woodsmoke/Due_SB/Duet-master/Duet_Expansion/Duex4v0.2/back_silkscreen.png

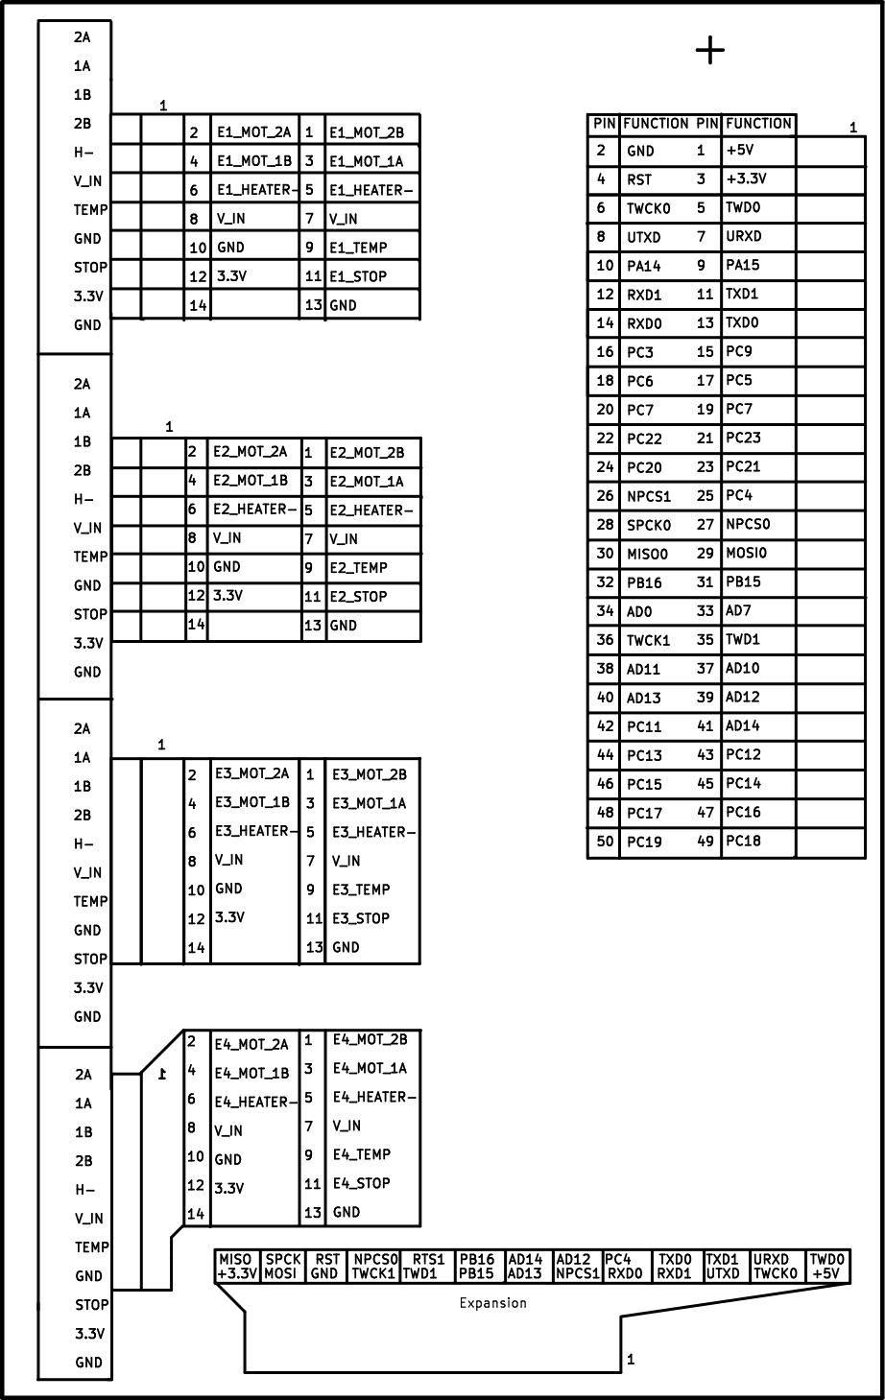
Duet-master/Duet_Expansion/Duex4v0.2/back_silkscreen.png
