woodsmoke/Due_SB/Duet-master/Archive_Files/Duet0.4/Duet0.4 BOM.xls

Part / Value | Qty | Package | Manufacturer / Part No. | Circuit Reference
Resistors, Thick Film
0R1, 1% | 8 | 1206 | Any | R32, R33, R34, R35, R44, R45, R46, R47
33R, 1% | 7 | 0603 | Any | R2, R3, R6, R7, R8, R9, R10
100R, 1% | 4 | 0603 | Any | R56, R57, R58, R59
220R, 1% | 2 | 0603 | Any | R16, R17
1k, 1% | 4 | 0603 | Any | R11, R18, R22, R24
1k5, 1% | 2 | 0603 | Any | R1, R64
4k7, 1% | 8 | 0603 | Any | R12, R13, R14, R19, R21, R65, R67, R68
6k49, 1% | 1 | 0603 | Any | R15
10k, 1% | 22 | 0603 | Any | R5, R20, R23, R25, R27, R29, R30, R31, R39, R41, R42, R43, R50, R51, R52, R53, R54, R55, R60, R61, R62, R63
12k, 1% | 4 | 0603 | Any | R36, R37, R48, R49
15k, 1% | 1 | 0603 | Any | R4
100k, 1% | 4 | 0603 | Any | R26, R28, R38, R40
Capacitors, Ceramic
22p, 50V, C0G/NP0, 5% | 4 | 0603 | Any | C8, C9, C44, C45
0u01, 50V, X7R, 10% | 1 | 0603 | Any | C47
0u1, 50V, X7R, 10% | 24 | 0603 | Any | C1, C5, C16, C17, C24, C25, C28, C29, C34, C35, C38, C39, C40, C41, C42, C43, C46, C48, C49, C50, C51, C52, C53, C55
0u22, 50V, X7R, 10% | 8 | 0603 | Any | C20, C21, C26, C27, C30, C31, C36, C37
2u2, 10V, X7R, 10% | 1 | 0805 | Any | C12
10u, 10V, X5R, 10% | 4 | 0805 | Any | C4, C7, C18, C19
22u, 6.3V, X7R, 10% | 2 | 1210 | Any | C10, C11
Capacitors, Al Electrolytic
100u, 35V, 20% | 6 | 6.3 x 7.7mm | Any | C3, C22, C23, C32, C33, C54
100u, 25V, 20% | 1 | 6.3 x 7.7mm | EPCOS, B41142A5107M | C6
Inductors / Filters
Power, 150uH, 0.5A | 1 | 2424 | PANASONIC - ELL6UH151M | L1
Ferrite Bead, 470R, 100Mhz | 2 | 0603 | Any | L3, L4
Ferrite Bead, 100R, 100MHz | 1 | 1206 | Any | L2
Crystals
12MHz | 1 | 5 x 3.2mm | TBD | X2
25MHz | 1 | 5 x 3.2mm | TBD | X1
Diodes
TS4148 | 2 | 0805 | Taiwan Semi - TS4148 RY | D4, D5
SS14M | 2 | uSMA | Taiwan Semi - SS14M | D1, D2
LED, 2mA, 1.8V | 4 | 0603 | Vishay - TLMO1000-GS08 | D3, D6, D7, D8
FETs
N-Ch, 20V, Logic-level | 3 | SOT-23 | NXP - BSH105 | TR1, TR3, TR5
P-Ch, 50V, Logic-level | 1 | SOT-23 | NXP - BSS84AK | TR7
N-Ch, 40V, Power | 3 | DPAK / TO-252 | Infineon - IPD036N04L | TR2, TR4, TR6
ICs
LPC1768 | 1 | LQFP100 | NXP - LPC1768FBD100,551 | U1
A4982 | 4 | TSSOP-24 | Allegro - A4982SLPTR-T | U5, U6, U7, U8
LM2594 | 1 | SOIC-8 | Nat Semi - LM2594M-5.0 | U3
LM1117 | 1 | SOT-223 | Nat Semi - LM1117MP-3.3 | U2
MCP44X1 | 1 | TSSOP-20 | Microchip - MCP4461-103E/ST | U9
KSZ8051 | 1 | QFN-32 | Micrel - KSZ8051RNL TR | U4
Miscellaneous
Micro Push Button Switch | 2 | SMD | Panasonic - EVQQ2T03W | S1, S2
USB - Micro B | 1 | SMD | FCI - 10118192-0001LF | J22
Micro SD Card Slot | 1 | SMD | TBD | J18
Connectors
RJ45+MAG | 1 |  |  | J19
BED_HEATER | 1 |  |  | J4
BED_TEMP | 1 |  |  | J5
CONN2X13 | 1 |  |  | J2
CONN2X20 | 2 |  |  | J1, J6
CONN_JTAG | 1 |  |  | J21
E0_HEATER | 1 |  |  | J11
E0_MOT/STOP | 1 |  |  | J10
E0_TEMP | 1 |  |  | J12
FAN0 | 1 |  |  | J13
I2C_2 | 1 |  |  | J3
JUMPER | 8 |  |  | JP1, JP2, JP3, JP4, JP5, JP6, JP7, JP8
POWER_IN | 1 |  |  | J23
UART0 | 1 |  |  | J20
X_MOT/STOP | 1 |  |  | J9
Y_MOT/STOP | 1 |  |  | J8
Z_MOT/STOP | 1 |  |  | J7
