woodsmoke/Due_SB/Duet-master/Duet0.8.5/Duet0.8.5_Schematic.pdf

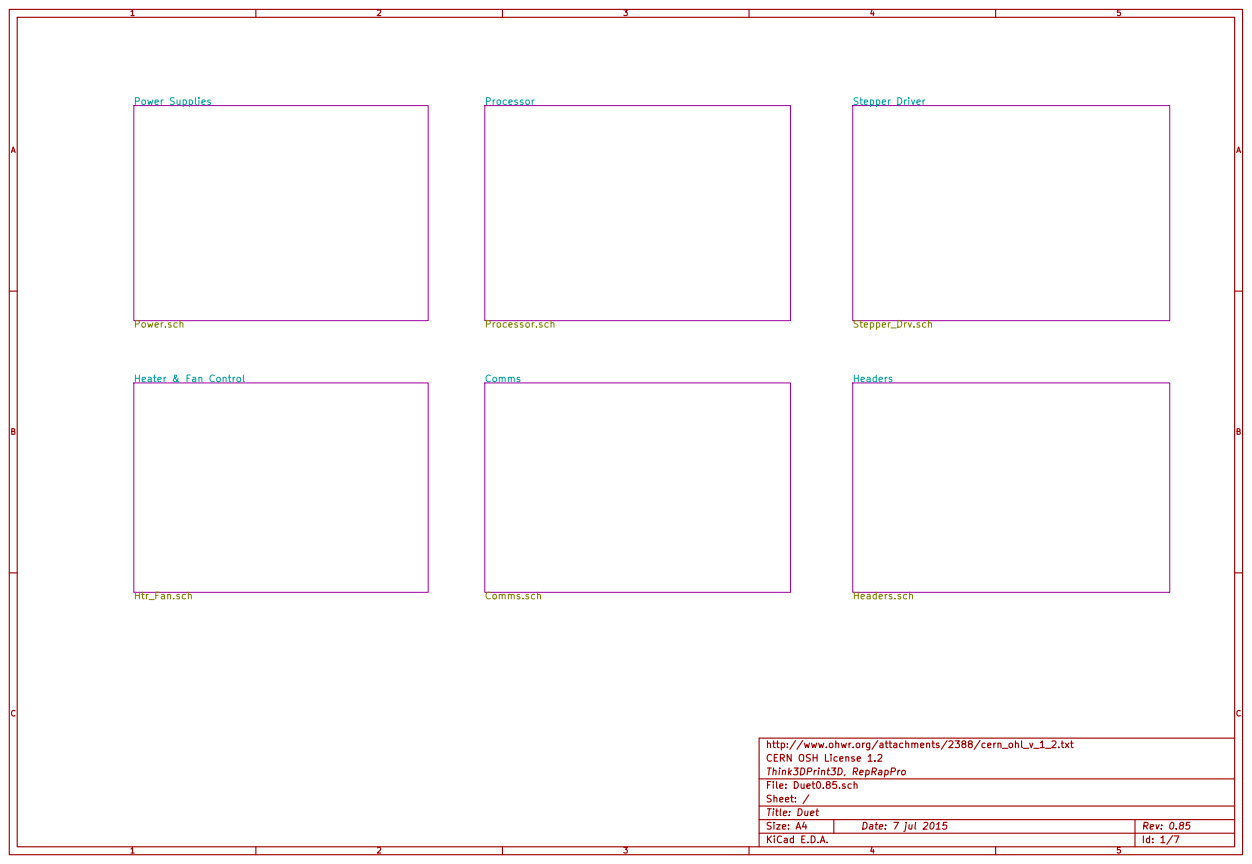
[picture p2: page 1]

http://www.ohwr.org/attachments/2388/cern_ohl_v_1_2.txt
CERN OSH License 1.2
Think3DPrint3D, RepRapPro
Id: 1/7 Title: Duet File: Duet0.85.sch Sheet: /

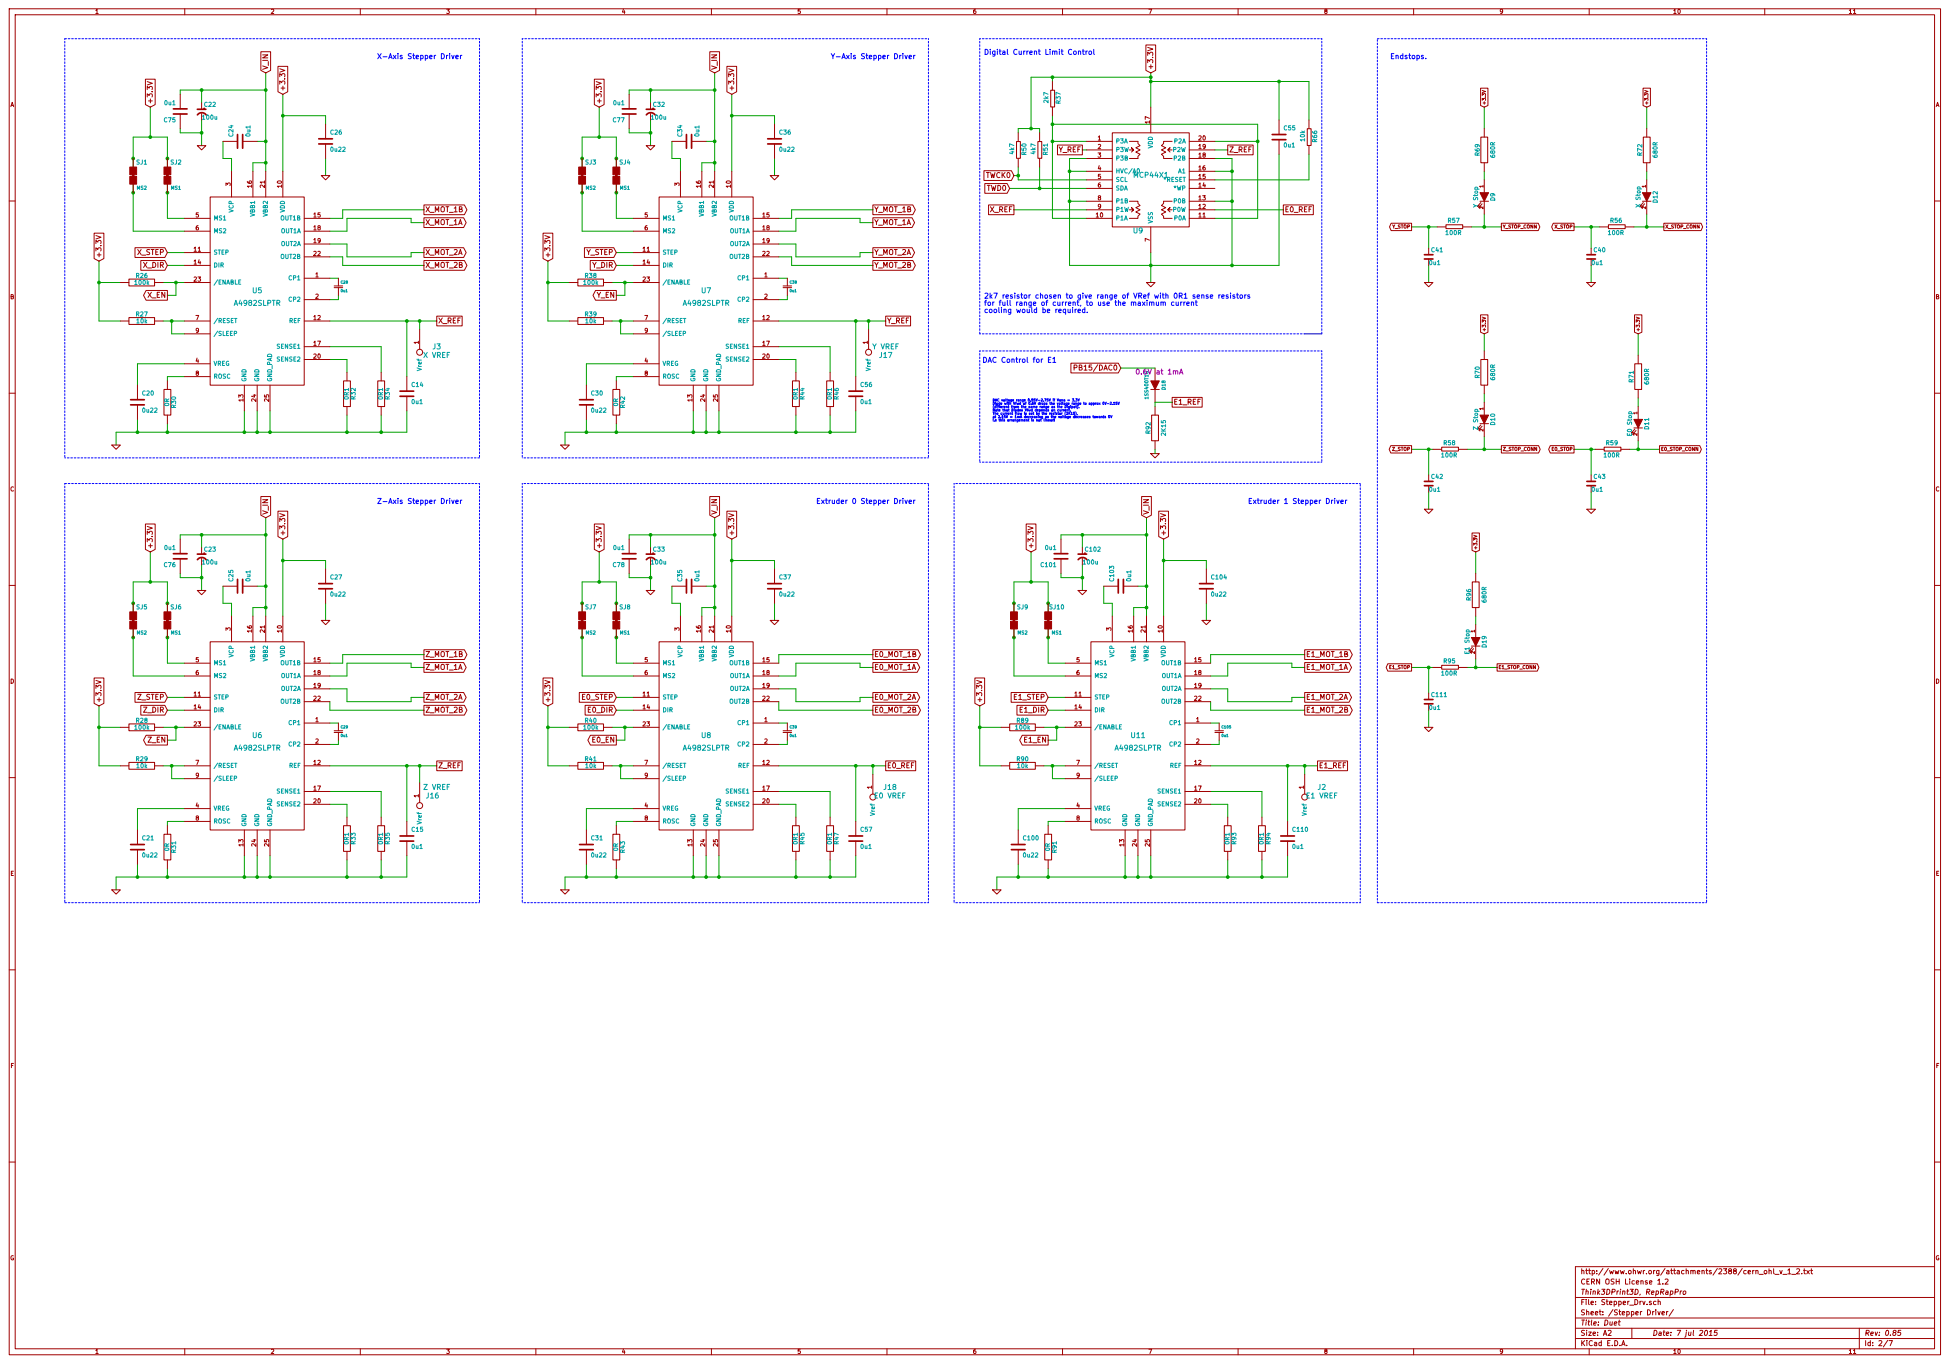
[picture p3: page 2]

Endstops. Digital Current Limit Control

for full range of current, to use the maximum current

DAC voltage range 0.55V-2.75V if Vana = 3.3V Diode with Vfwd of 0.6V drops the voltage range to approx 0V-2.15V
(different from the same range as the Digipot). Note that Diodes Vfwd depends on current. The current flow is set by the resistor (2K15), at 2.15V = 1mA decreasing as the voltage decreases towards 0V

http://www.ohwr.org/attachments/2388/cern_ohl_v_1_2.txt
CERN OSH License 1.2
Think3DPrint3D, RepRapPro
Id: 2/7 Title: Duet File: Stepper_Drv.sch
Sheet: /Stepper Driver/

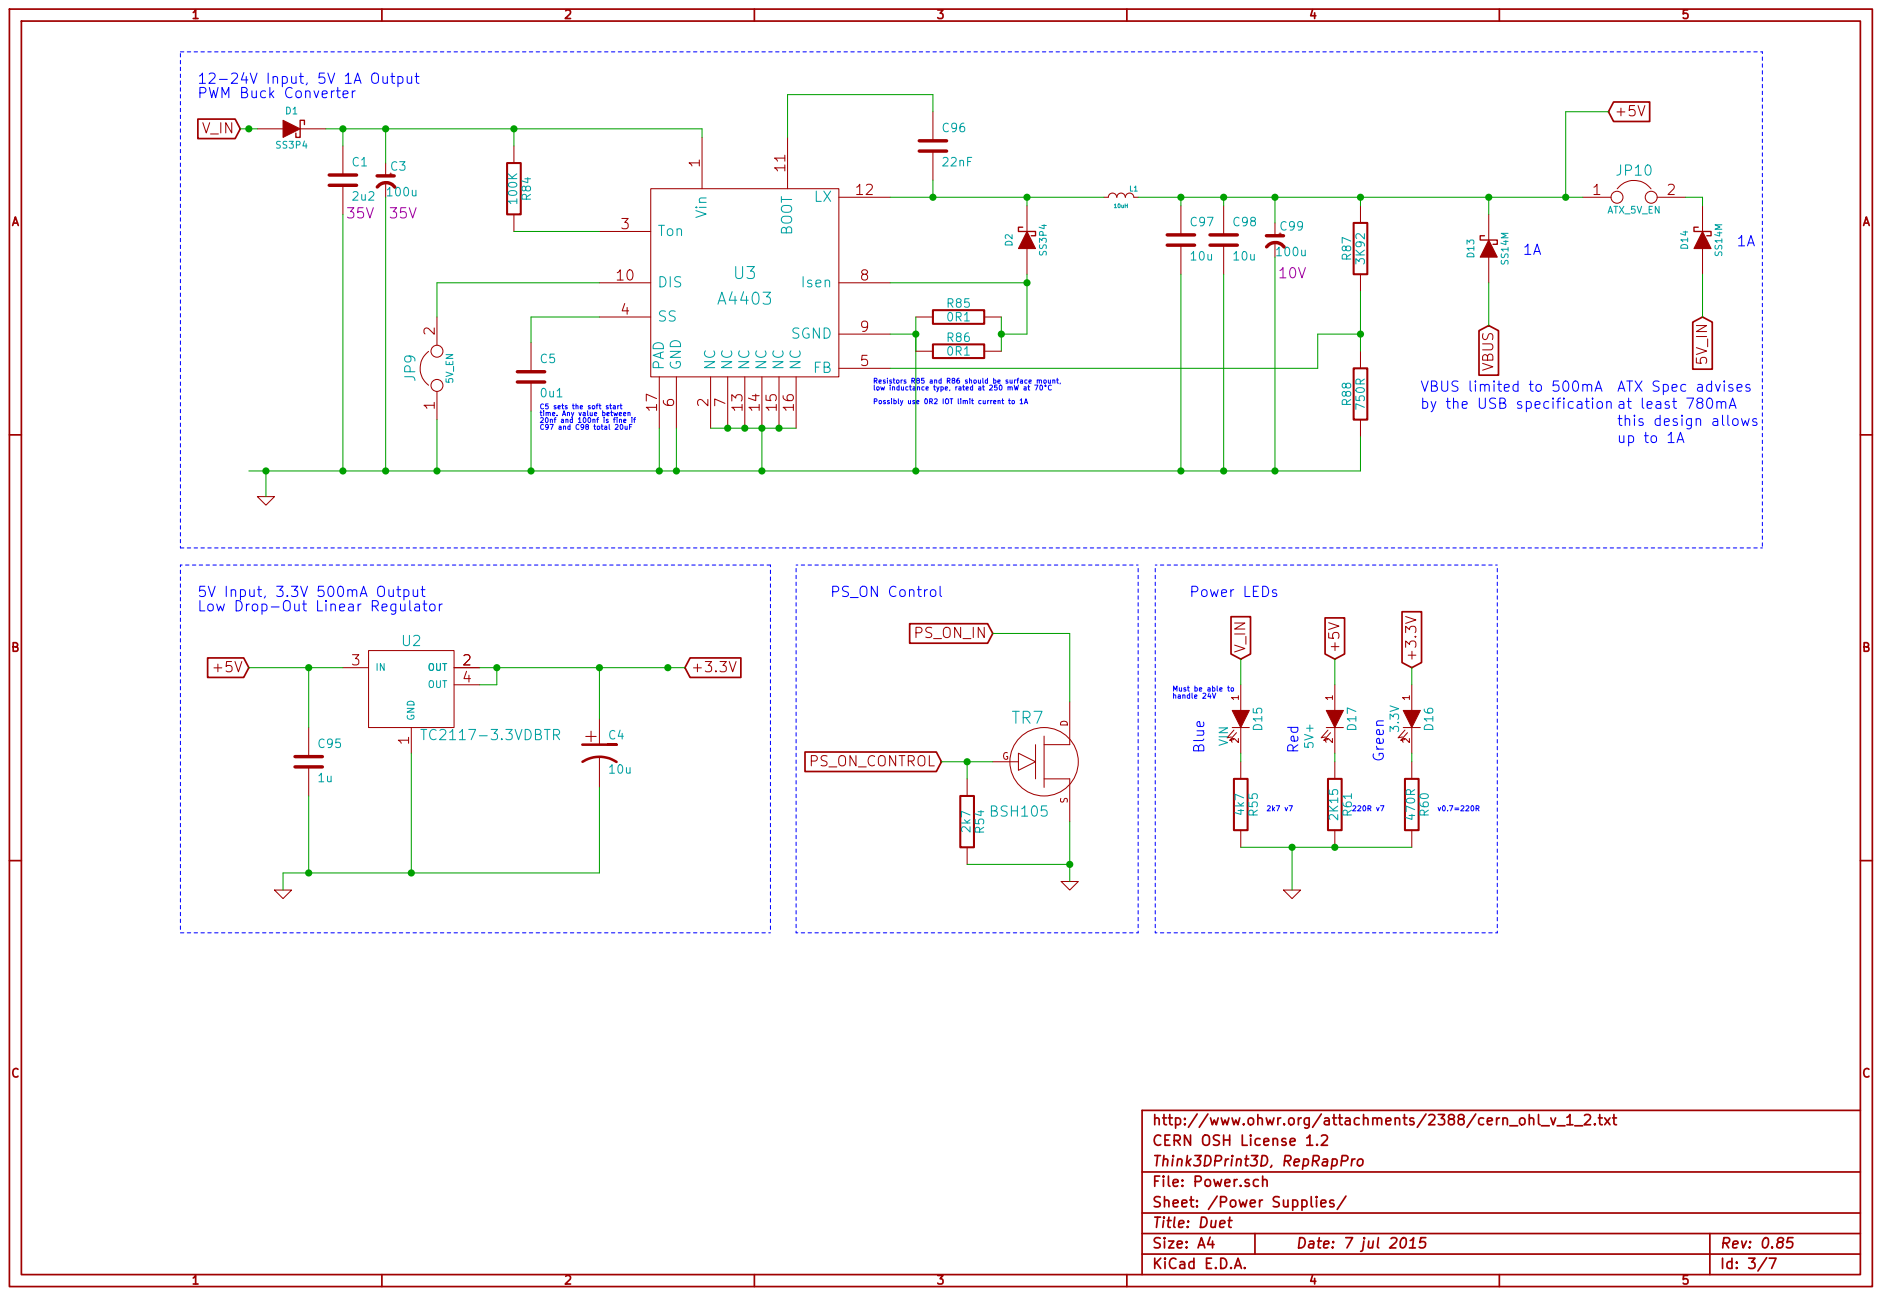
[picture p4: page 3]

U3 A4403 | LX | 12 NC 13 NC 14 NC 15 NC 16 PAD 17

2 Ton 3 SS 4 FB GND 5

Resistors R85 and R86 should be surface mount,
low inductance type, rated at 250 mW at 70°C

Possibly use 0R2 IOT limit current to 1A C5 sets the soft start

by the USB specification

this design allows at least 780mA

time. Any value between

5V Input, 3.3V 500mA Output
Low Drop-Out Linear Regulator

Must be able to

http://www.ohwr.org/attachments/2388/cern_ohl_v_1_2.txt C95

CERN OSH License 1.2
Think3DPrint3D, RepRapPro
Id: 3/7 Title: Duet File: Power.sch Sheet: /Power Supplies/

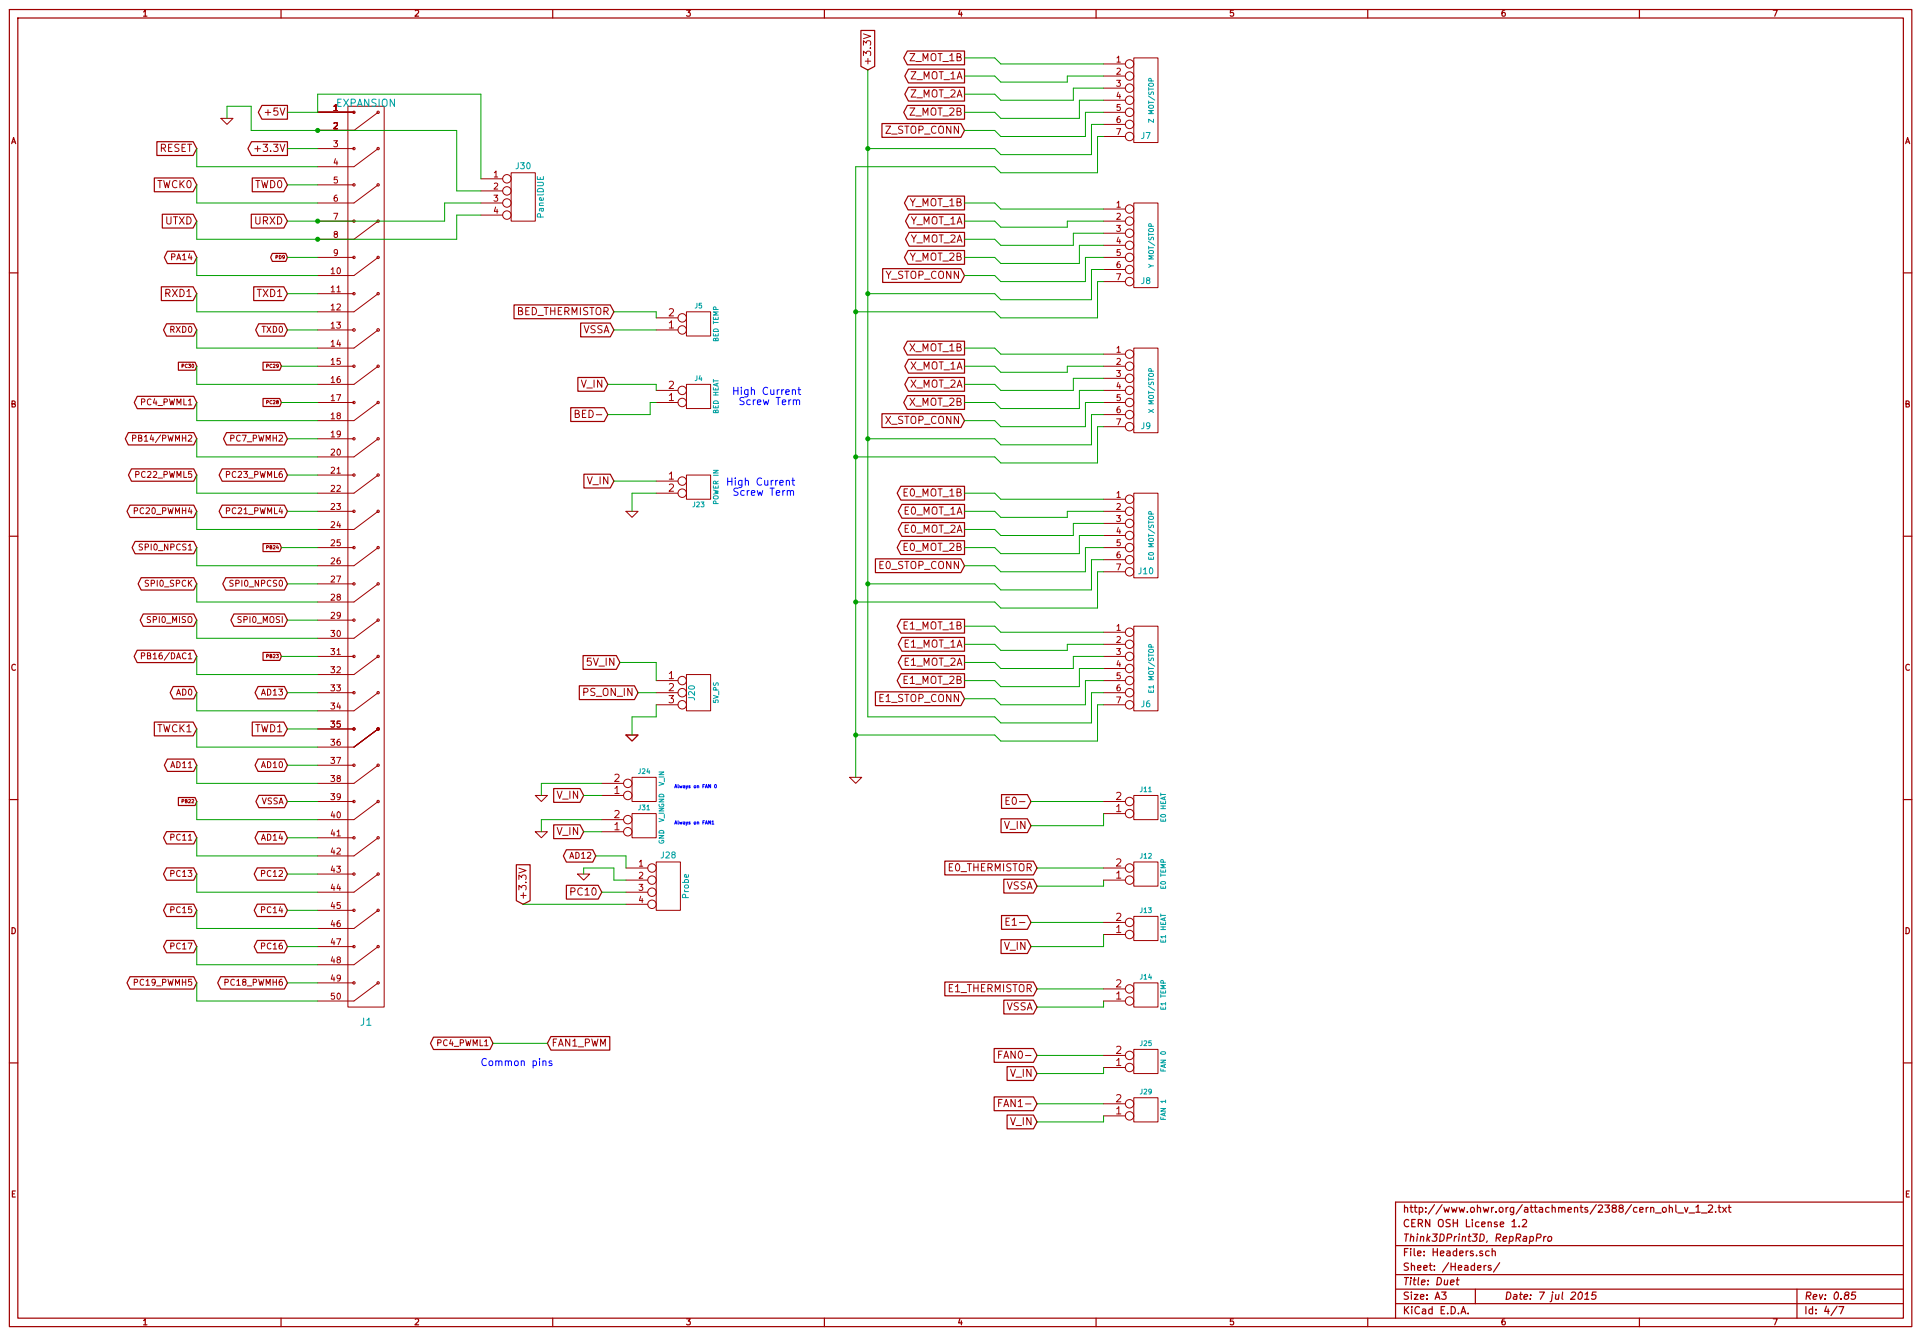
[picture p5: page 4]

CERN OSH License 1.2
Think3DPrint3D, RepRapPro
Id: 4/7 Title: Duet File: Headers.sch Sheet: /Headers/

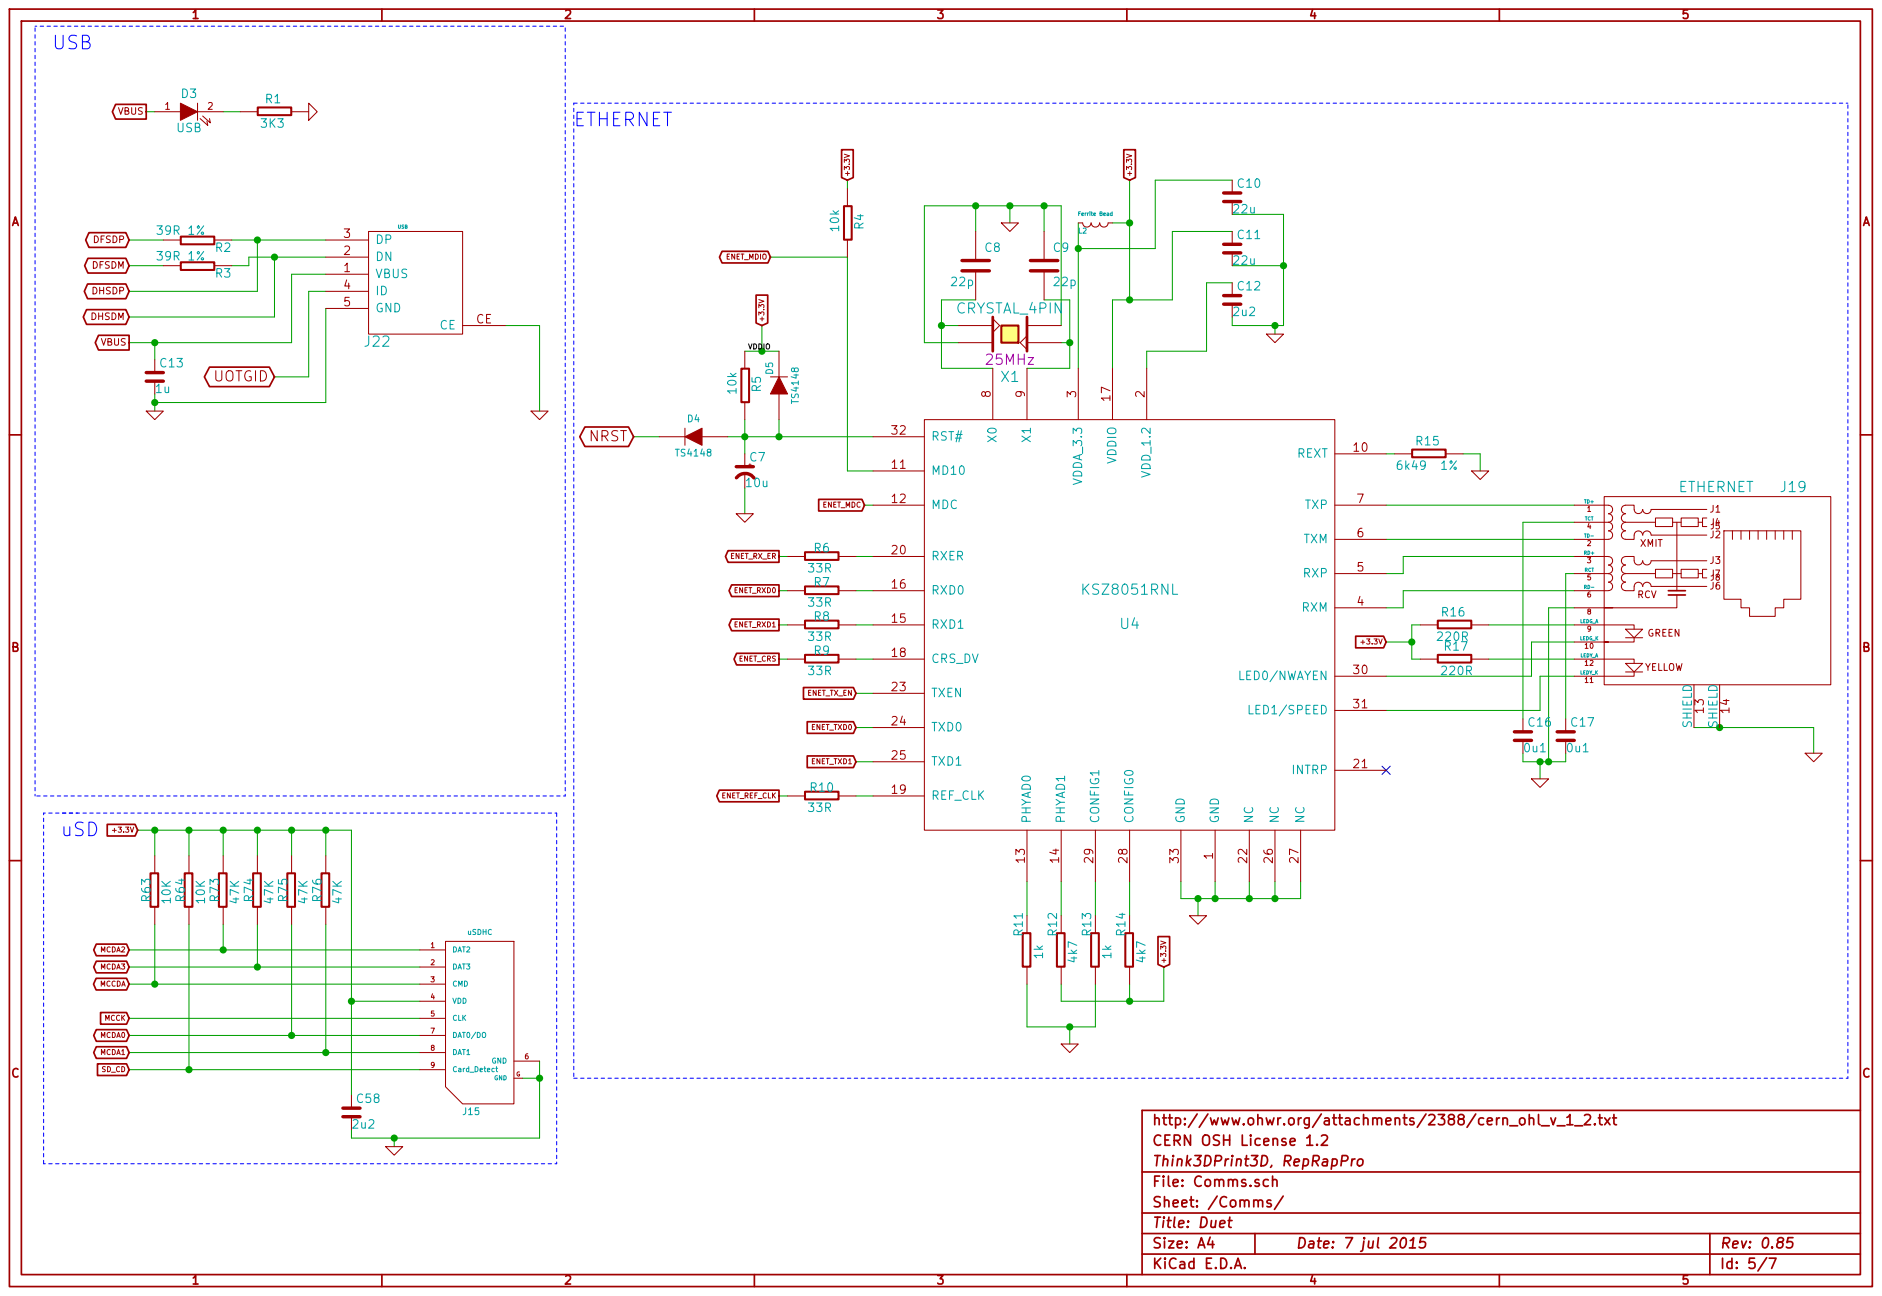
[picture p6: page 5]

3 RXM 4 RXP 5 TXM 6 TXP 7 X0

XMIT YELLOW | J1

GREEN

CERN OSH License 1.2
Think3DPrint3D, RepRapPro
Id: 5/7 Title: Duet File: Comms.sch
Sheet: /Comms/

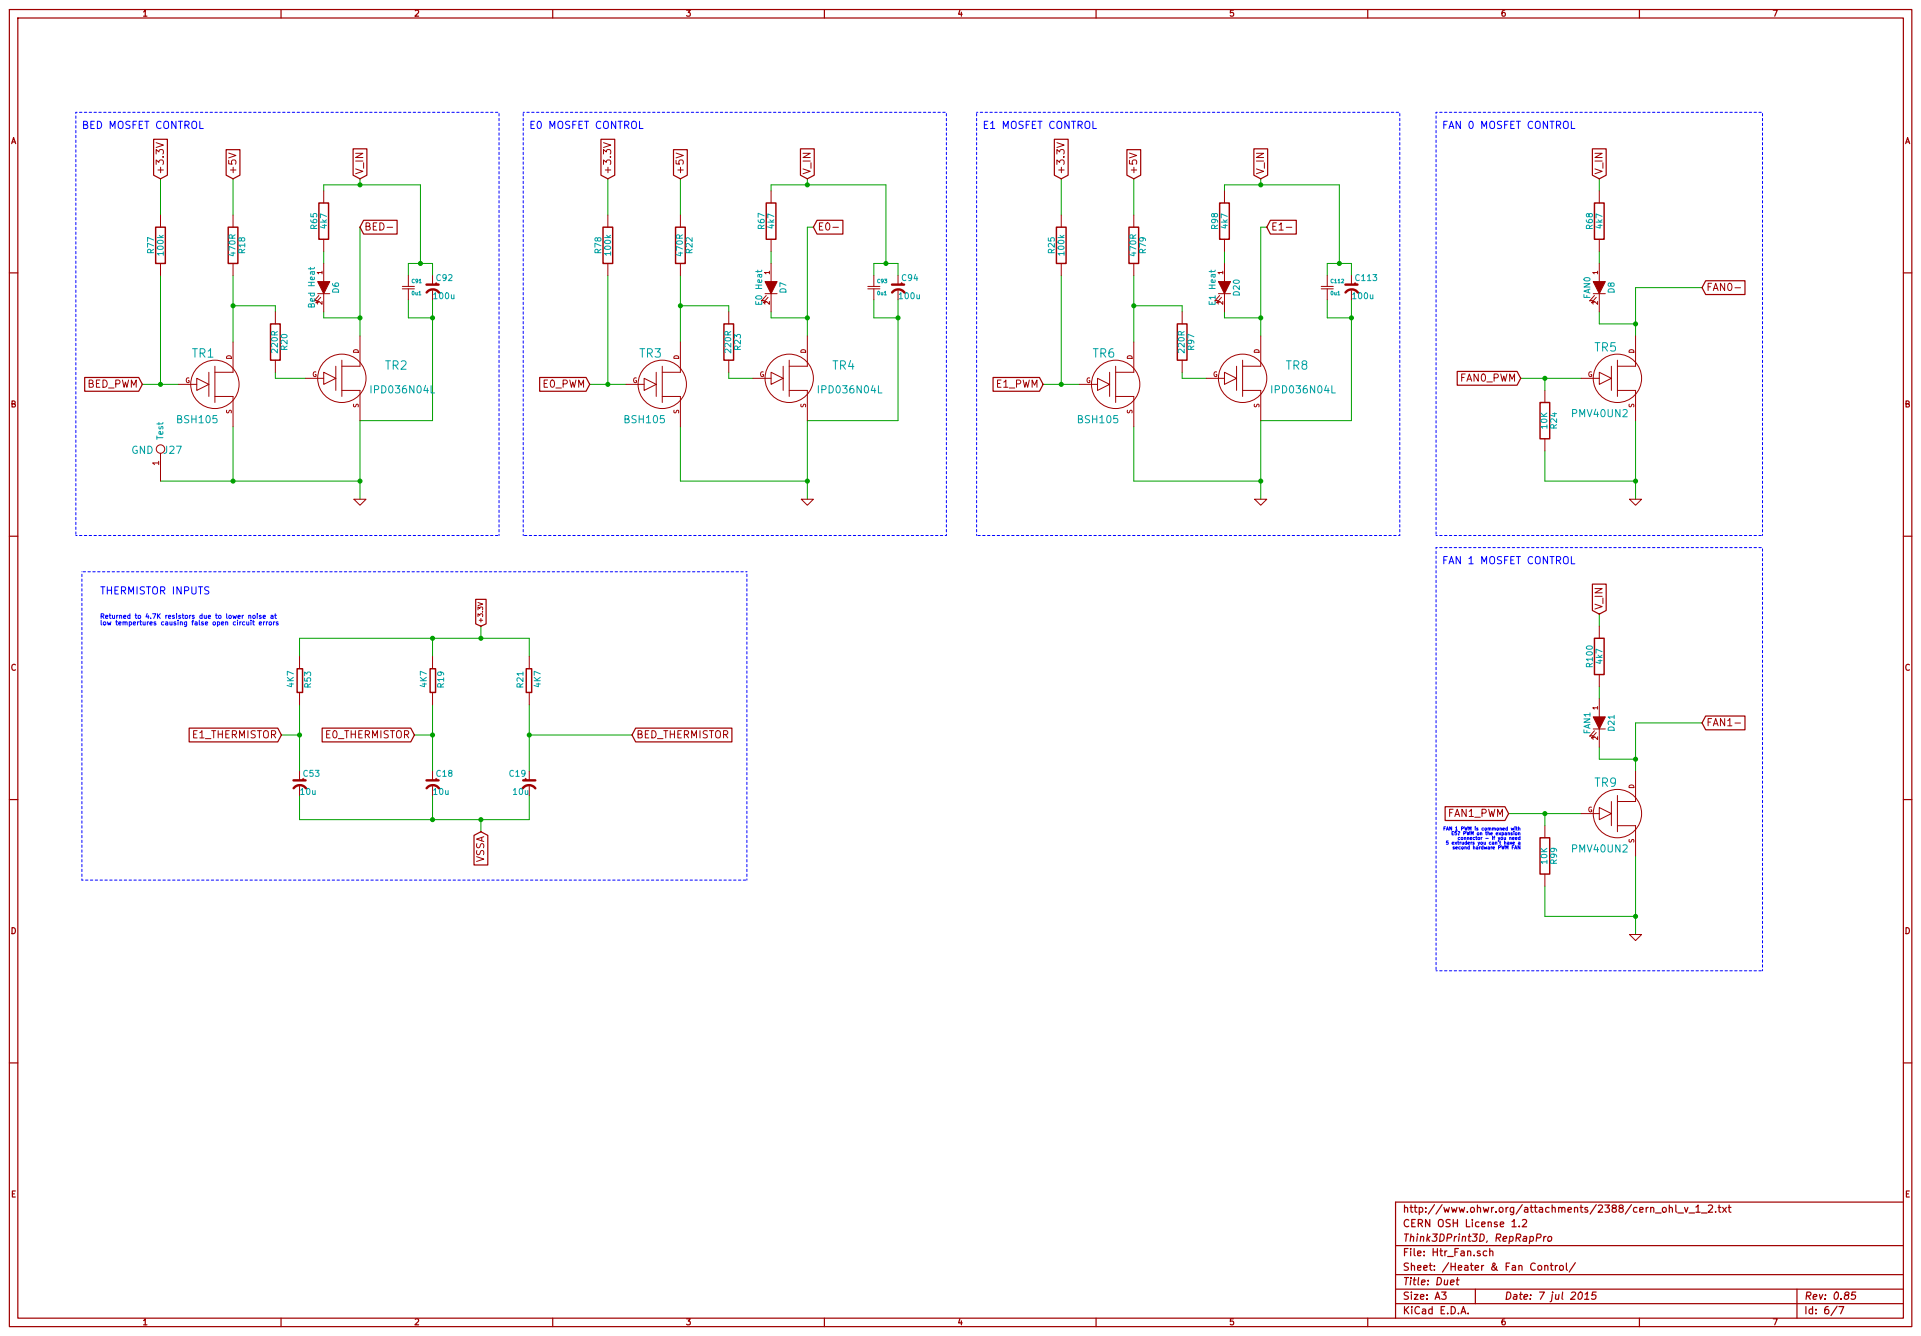
[picture p7: page 6]

10u +3.3V Returned to 4.7K resistors due to lower noise at
low tempertures causing false open circuit errors

FAN 1 PWM is commoned with E5? PWM on the expansion
connector - If you need
5 extruders you can't have a
second hardware PWM FAN

http://www.ohwr.org/attachments/2388/cern_ohl_v_1_2.txt
CERN OSH License 1.2
Think3DPrint3D, RepRapPro
Id: 6/7 Title: Duet File: Htr_Fan.sch
Sheet: /Heater & Fan Control/

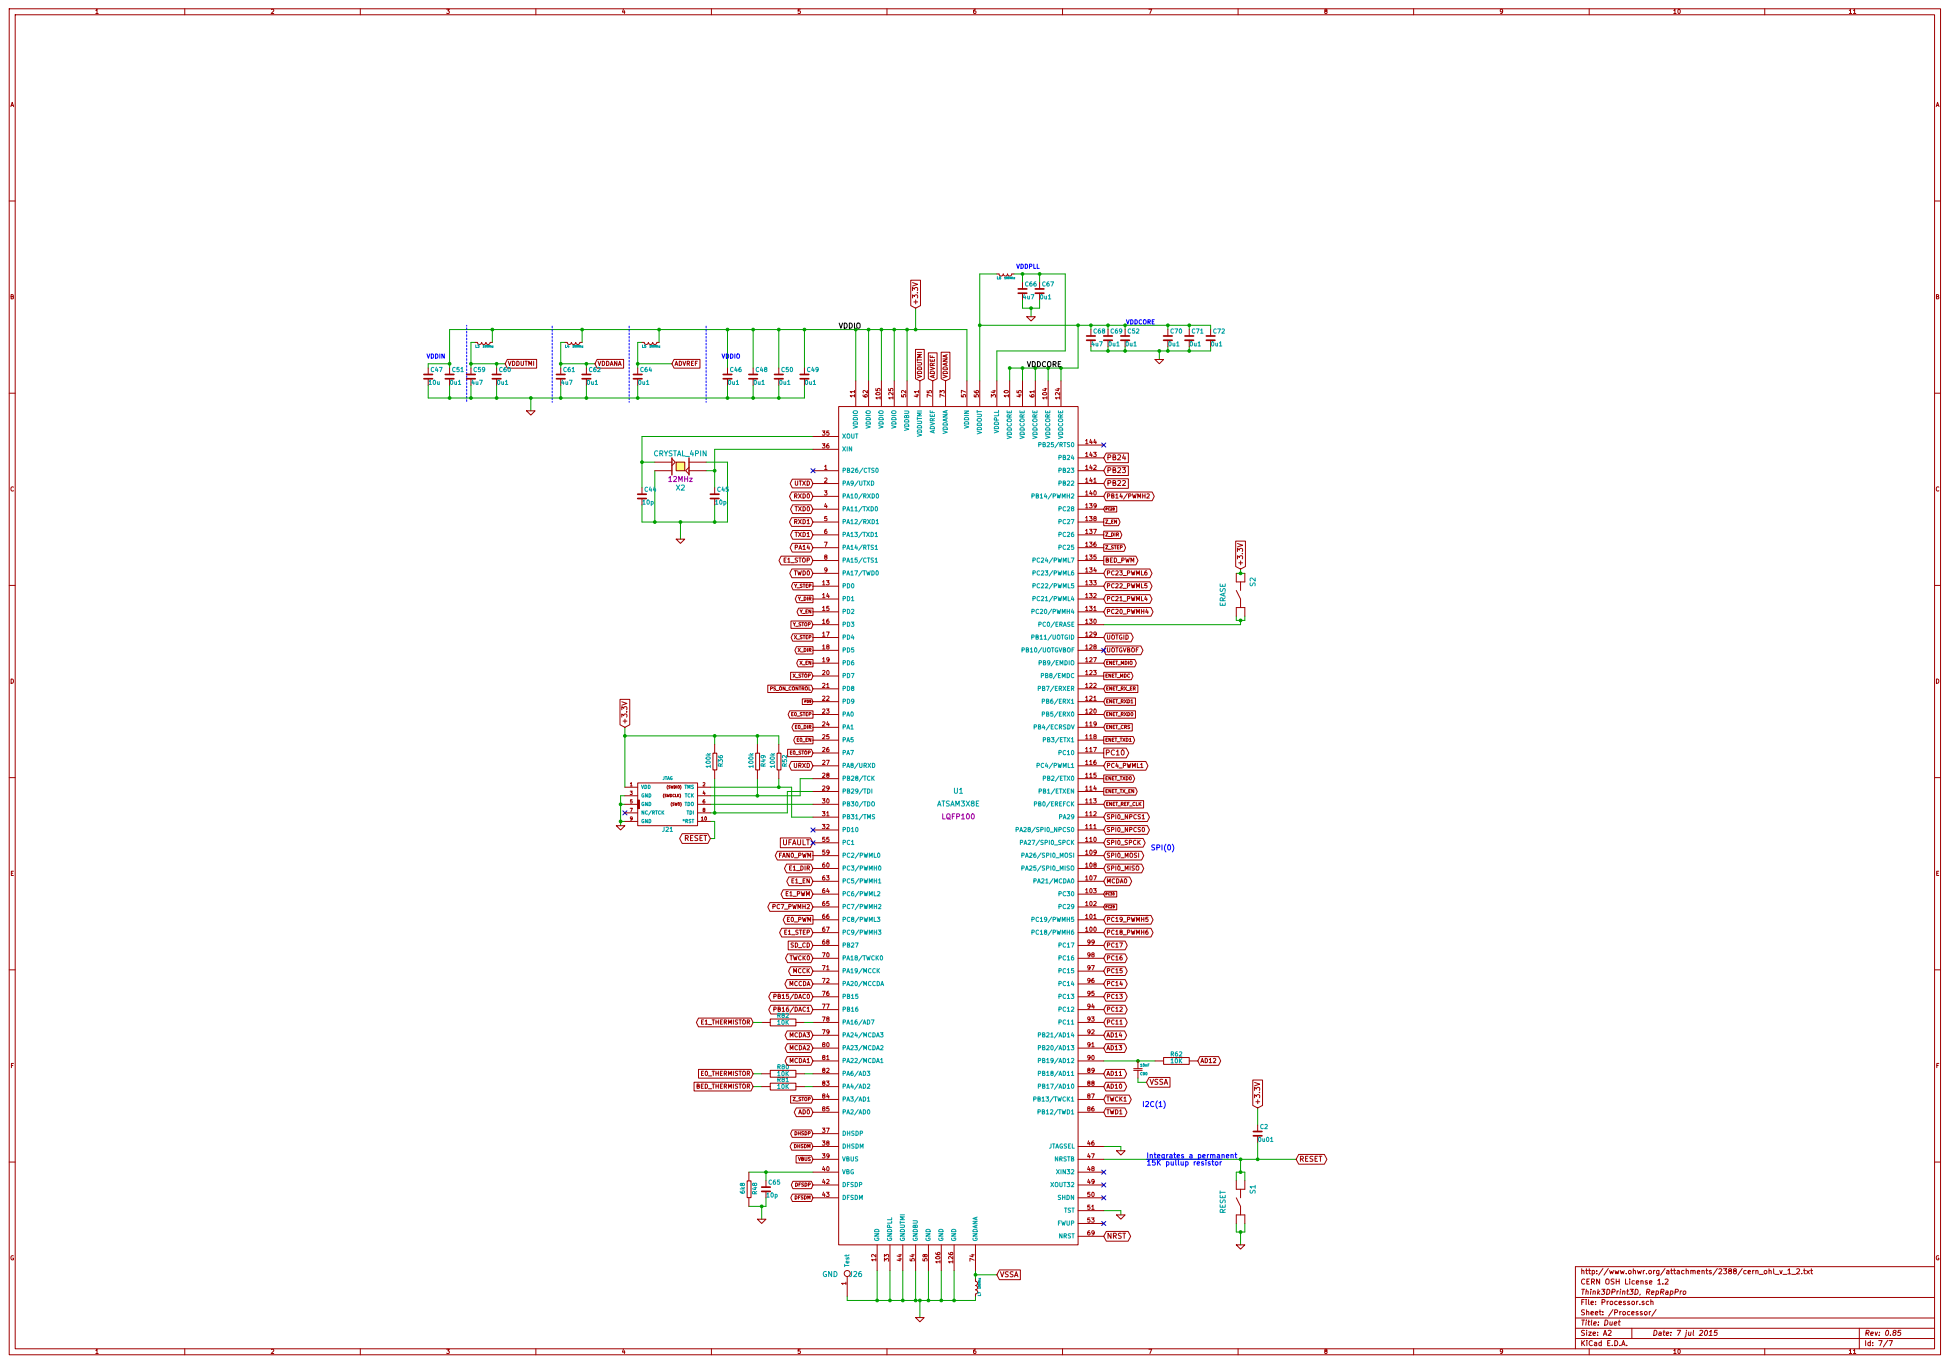
[picture p8: page 7]

http://www.ohwr.org/attachments/2388/cern_ohl_v_1_2.txt R81

CERN OSH License 1.2
Think3DPrint3D, RepRapPro
Id: 7/7 Title: Duet File: Processor.sch Sheet: /Processor/
