woodsmoke/Due_SB/Duet-master/Duet0.8.5/Duet0.85.kicad_pcb

## KiCad design Duet-master/Duet0.8.5/Duet0.85.kicad_pcb (2015-08-22)

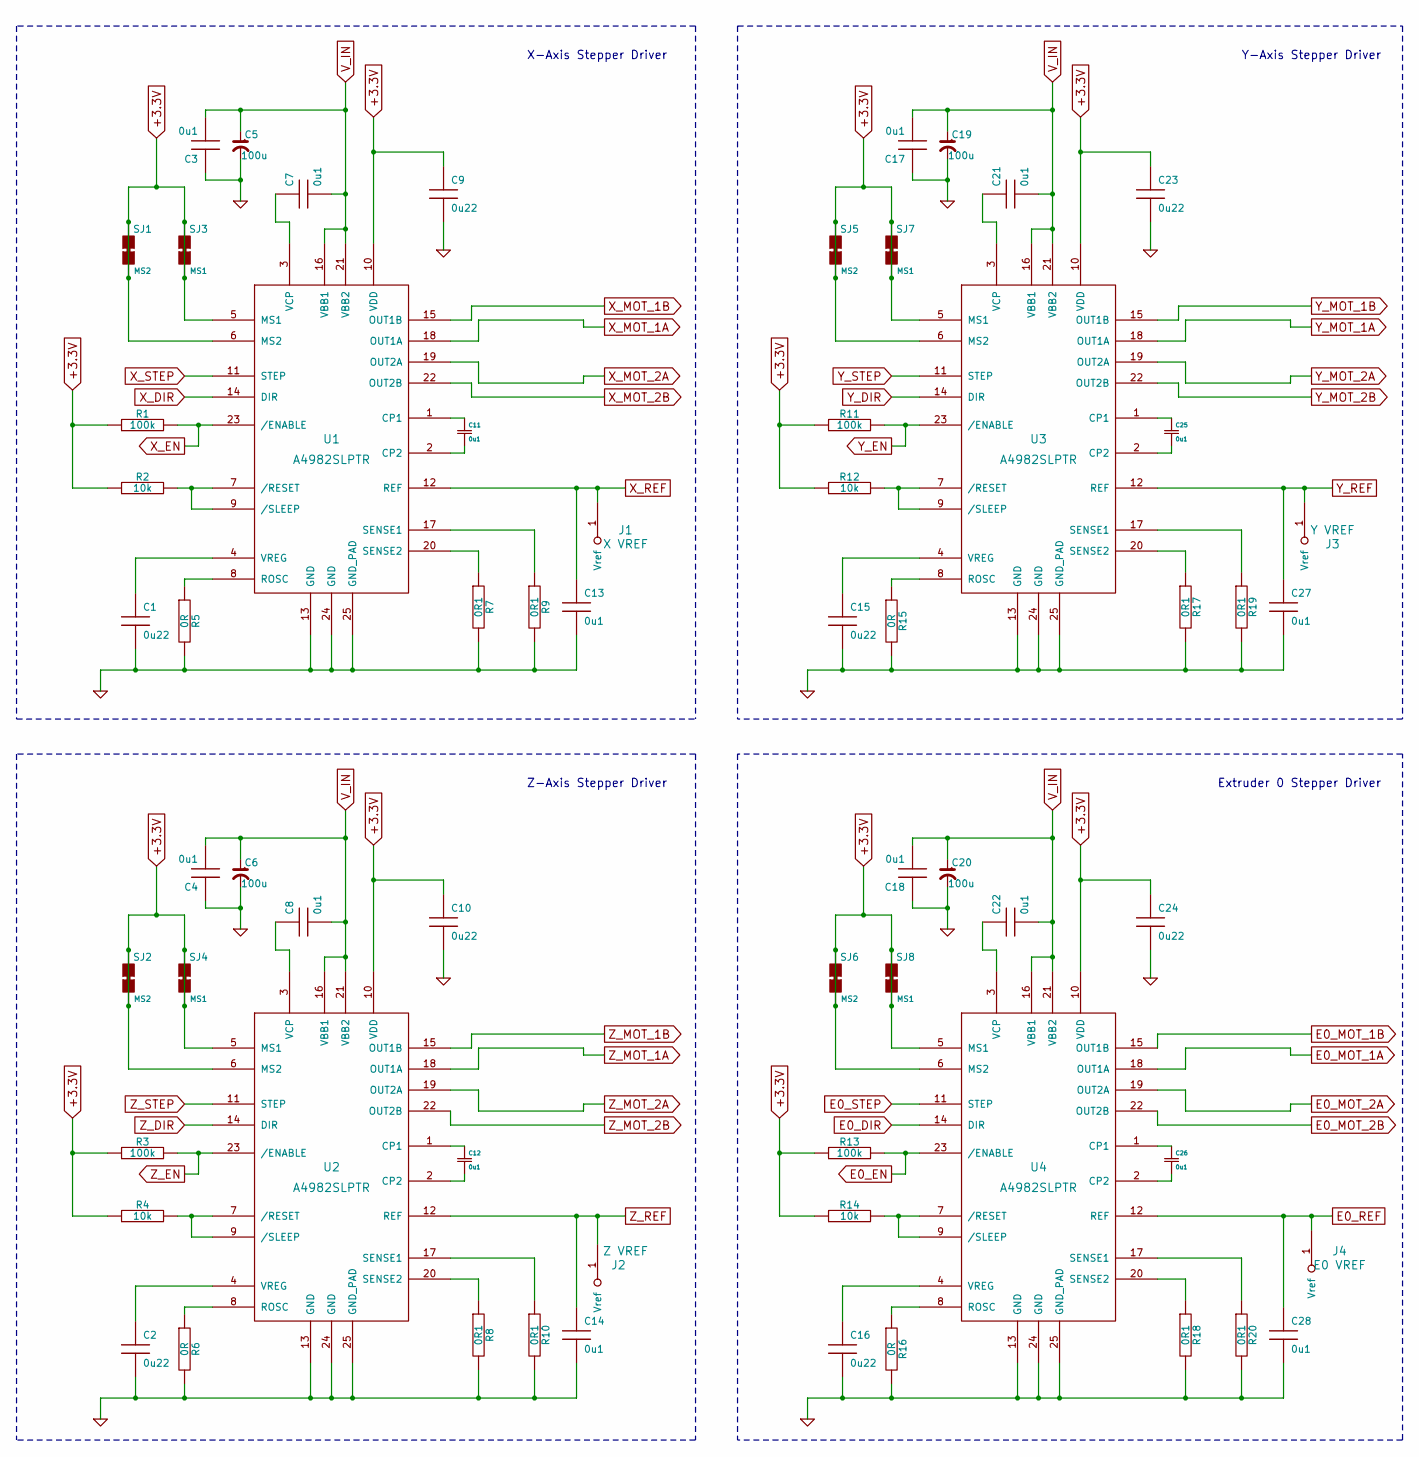
[picture p9: schematic Stepper_Drv.sch, Duet, part in row 1, column 1]

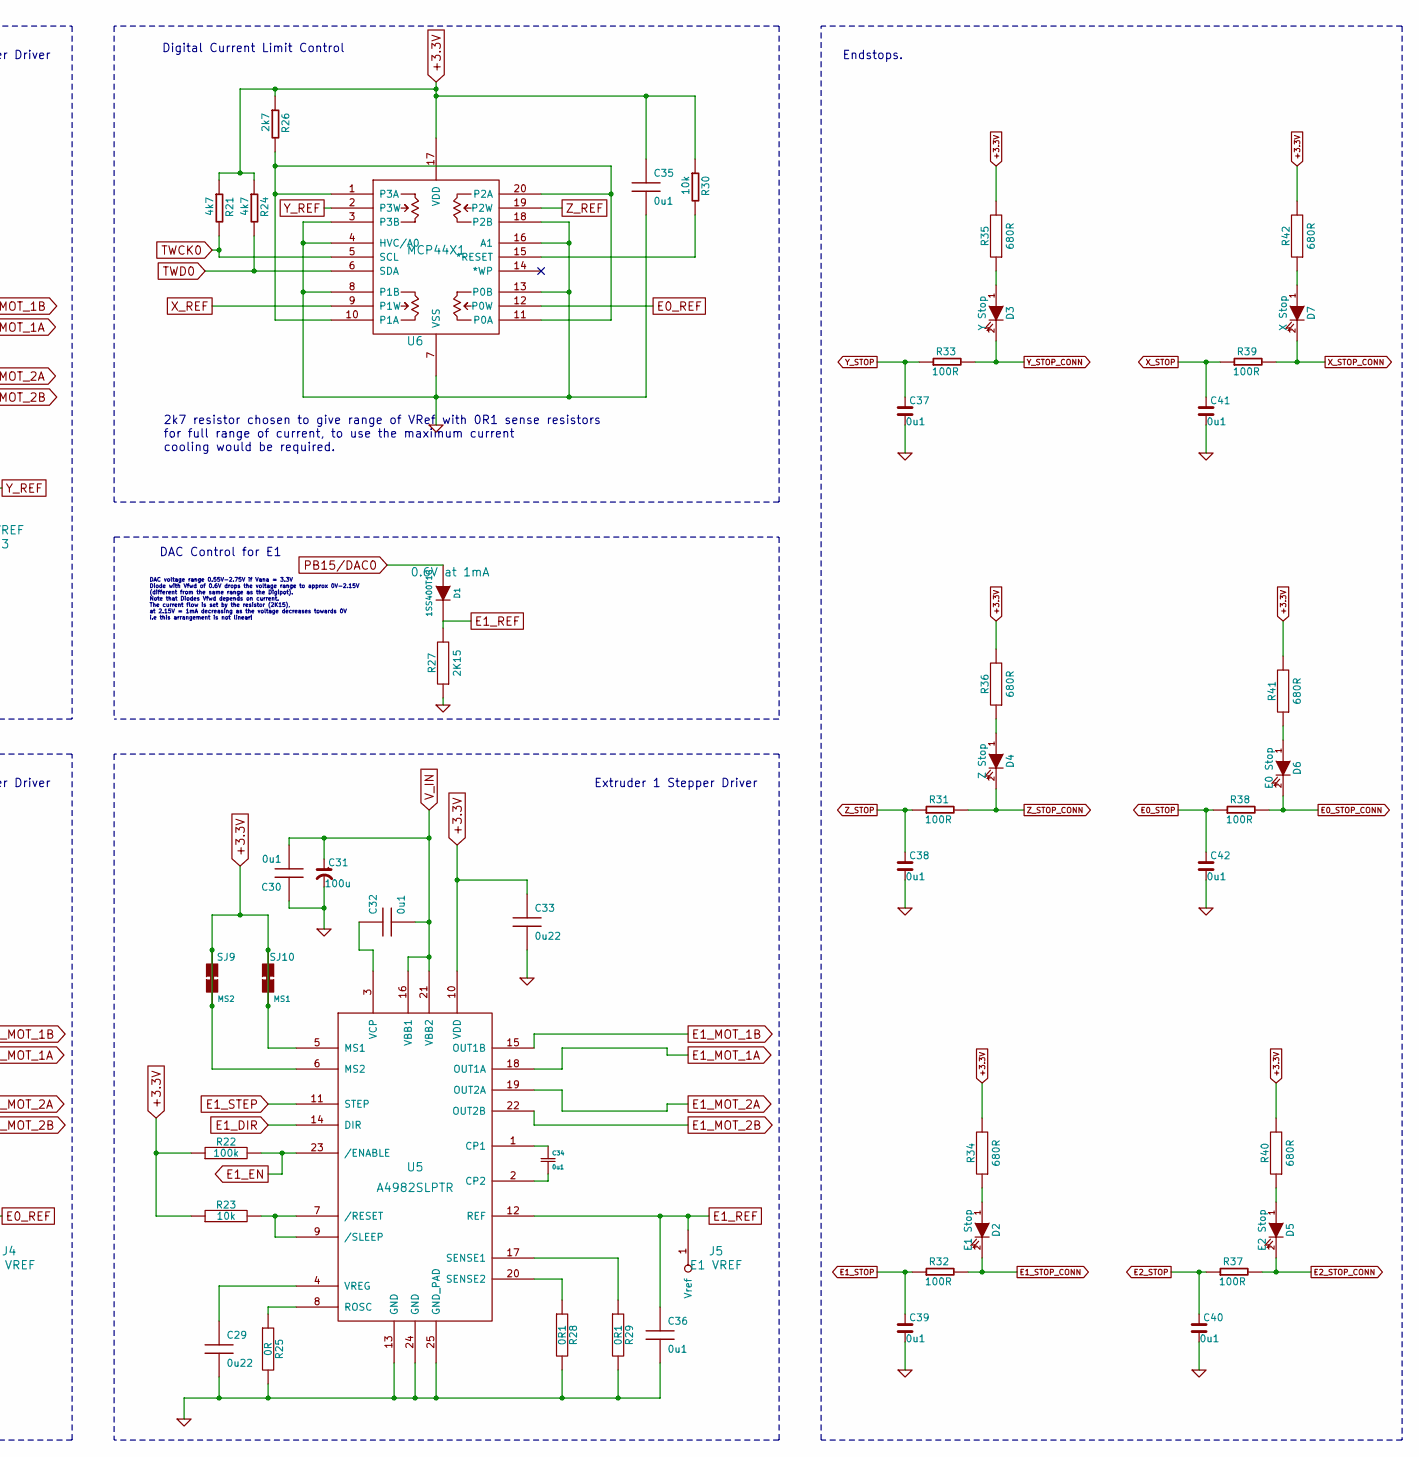
[picture p10: schematic Stepper_Drv.sch, Duet, part in row 1, column 2]

Parts:
C1, C2, C9, C10, C15, C16, C23, C24, C29, C33: 0u22; 0mf22_capacitor
C3, C4, C7, C8, C11, C12, C13, C14, C17, C18, C21, C22, C25, C26, C27, C28, C30, C32, C34, C35, C36, C37, C38, C39, C40, C41, C42: 0u1; 0mf1_capacitor
C5, C6, C19, C20, C31: 100u; 100mf_capacitor
D1: 1SS400T1G; Fwd Voltage Drop (1mA) 0.6V at 1mA
D2: E1 Stop; E1STOP_diode
D3: Y Stop; YSTOP_diode
D4: Z Stop; ZSTOP_diode
D5: E2 Stop; E2STOP_diode
D6: E0 Stop; E0STOP_diode
D7: X Stop; XSTOP_diode
J1: X VREF; Vref
J2: Z VREF; Vref
J3: Y VREF; Vref
J4: E0 VREF; Vref
J5: E1 VREF; Vref
R1, R3, R11, R13, R22: 100k; 100k_R_0603
R2, R4, R12, R14, R23, R30: 10k; 10k_R_0603
R5, R6, R15, R16, R25: 0R; 0R_R_0603
R7, R8, R9, R10, R17, R18, R19, R20, R28, R29: 0R1; 0R1_R_1206
R21, R24: 4k7; 4k7_R_0603
R26: 2k7; 2k7_R_0603
R27: 2K15; 2k15_R_0603
R31: 100R; 100k_R_0603
R32, R33, R37, R38, R39: 100R; 100R_R_0603
R34, R35, R36, R40, R41, R42: 680R; 680R_R_0603
SJ1, SJ2, SJ5, SJ6, SJ9: MS2; SJump
SJ3, SJ4, SJ7, SJ8, SJ10: MS1; SJump
U1, U2, U3, U4, U5: A4982SLPTR; A4982SPLTR_TSSOP-24-thin_pads
U6: MCP44X1; MCP44X1_TSSOP-20

Connections:
+3.3V: C9.1, C10.1, C23.1, C24.1, C33.1, C35.1, R1.1, R2.1, R3.1, R4.1, R11.1, R12.1, R13.1, R14.1, R21.1, R22.1, R23.1, R24.1, R26.1, R30.1, R34.2, R35.2, R36.2, R40.2, R41.2, R42.2, SJ1.1 (SJ_P1), SJ1.2 (SJ_P2), SJ2.1 (SJ_P1), SJ2.2 (SJ_P2), SJ3.1 (SJ_P1), SJ3.2 (SJ_P2), SJ4.1 (SJ_P1), SJ4.2 (SJ_P2), SJ5.1 (SJ_P1), SJ5.2 (SJ_P2), SJ6.1 (SJ_P1), SJ6.2 (SJ_P2), SJ7.1 (SJ_P1), SJ7.2 (SJ_P2), SJ8.1 (SJ_P1), SJ8.2 (SJ_P2), SJ9.1 (SJ_P1), SJ9.2 (SJ_P2), SJ10.1 (SJ_P1), SJ10.2 (SJ_P2), U1.5 (MS1), U1.6 (MS2), U1.10 (VDD), U2.5 (MS1), U2.6 (MS2), U2.10 (VDD), U3.5 (MS1), U3.6 (MS2), U3.10 (VDD), U4.5 (MS1), U4.6 (MS2), U4.10 (VDD), U5.5 (MS1), U5.6 (MS2), U5.10 (VDD), U6.17 (VDD); also elsewhere on the board
E0_DIR: U4.14 (DIR); also elsewhere on the board
E0_EN: R13.2, U4.23 (/ENABLE); also elsewhere on the board
E0_MOT_1A: U4.18 (OUT1A); also elsewhere on the board
E0_MOT_1B: U4.15 (OUT1B); also elsewhere on the board
E0_MOT_2A: U4.19 (OUT2A); also elsewhere on the board
E0_MOT_2B: U4.22 (OUT2B); also elsewhere on the board
E0_REF: C28.1, J4.1, U4.12 (REF), U6.12 (P0W)
E0_STEP: U4.11 (STEP); also elsewhere on the board
E0_STOP: C42.1, R38.1; also elsewhere on the board
E0_STOP_CONN: D6.2 (K), R38.2; also elsewhere on the board
E1_DIR: U5.14 (DIR); also elsewhere on the board
E1_EN: R22.2, U5.23 (/ENABLE); also elsewhere on the board
E1_MOT_1A: U5.18 (OUT1A); also elsewhere on the board
E1_MOT_1B: U5.15 (OUT1B); also elsewhere on the board
E1_MOT_2A: U5.19 (OUT2A); also elsewhere on the board
E1_MOT_2B: U5.22 (OUT2B); also elsewhere on the board
E1_REF: C36.1, D1.1 (K), J5.1, R27.2, U5.12 (REF)
E1_STEP: U5.11 (STEP); also elsewhere on the board
E1_STOP: C39.1, R32.1; also elsewhere on the board
E1_STOP_CONN: D2.2 (K), R32.2; also elsewhere on the board
E2_STOP: C40.1, R37.1; also elsewhere on the board
E2_STOP_CONN: D5.2 (K), R37.2; also elsewhere on the board
GND: C1.2, C2.2, C3.1, C4.1, C5.2, C6.2, C9.2, C10.2, C13.2, C14.2, C15.2, C16.2, C17.1, C18.1, C19.2, C20.2, C23.2, C24.2, C27.2, C28.2, C29.2, C30.1, C31.2, C33.2, C35.2, C36.2, C37.2, C38.2, C39.2, C40.2, C41.2, C42.2, R5.2, R6.2, R7.2, R8.2, R9.2, R10.2, R15.2, R16.2, R17.2, R18.2, R19.2, R20.2, R25.2, R27.1, R28.2, R29.2, U1.13 (GND), U1.24 (GND), U1.25 (GND_PAD), U2.13 (GND), U2.24 (GND), U2.25 (GND_PAD), U3.13 (GND), U3.24 (GND), U3.25 (GND_PAD), U4.13 (GND), U4.24 (GND), U4.25 (GND_PAD), U5.13 (GND), U5.24 (GND), U5.25 (GND_PAD), U6.3 (P3B), U6.4 (HVC/A0), U6.7 (VSS), U6.8 (P1B), U6.13 (P0B), U6.16 (A1), U6.18 (P2B); also elsewhere on the board
unnamed: C1.1, U1.4 (VREG)
unnamed: C2.1, U2.4 (VREG)
unnamed: C7.1, U1.3 (VCP)
unnamed: C8.1, U2.3 (VCP)
unnamed: C11.1, U1.1 (CP1)
unnamed: C11.2, U1.2 (CP2)
unnamed: C12.1, U2.1 (CP1)
unnamed: C12.2, U2.2 (CP2)
unnamed: C15.1, U3.4 (VREG)
unnamed: C16.1, U4.4 (VREG)
unnamed: C21.1, U3.3 (VCP)
unnamed: C22.1, U4.3 (VCP)
unnamed: C25.1, U3.1 (CP1)
unnamed: C25.2, U3.2 (CP2)
unnamed: C26.1, U4.1 (CP1)
unnamed: C26.2, U4.2 (CP2)
unnamed: C29.1, U5.4 (VREG)
unnamed: C32.1, U5.3 (VCP)
unnamed: C34.1, U5.1 (CP1)
unnamed: C34.2, U5.2 (CP2)
unnamed: D2.1 (A), R34.1
unnamed: D3.1 (A), R35.1
unnamed: D4.1 (A), R36.1
unnamed: D5.1 (A), R40.1
unnamed: D6.1 (A), R41.1
unnamed: D7.1 (A), R42.1
unnamed: R2.2, U1.7 (/RESET), U1.9 (/SLEEP)
unnamed: R4.2, U2.7 (/RESET), U2.9 (/SLEEP)
unnamed: R5.1, U1.8 (ROSC)
unnamed: R6.1, U2.8 (ROSC)
unnamed: R7.1, U1.20 (SENSE2)
unnamed: R8.1, U2.20 (SENSE2)
unnamed: R9.1, U1.17 (SENSE1)
unnamed: R10.1, U2.17 (SENSE1)
unnamed: R12.2, U3.7 (/RESET), U3.9 (/SLEEP)
unnamed: R14.2, U4.7 (/RESET), U4.9 (/SLEEP)
unnamed: R15.1, U3.8 (ROSC)
unnamed: R16.1, U4.8 (ROSC)
unnamed: R17.1, U3.20 (SENSE2)
unnamed: R18.1, U4.20 (SENSE2)
unnamed: R19.1, U3.17 (SENSE1)
unnamed: R20.1, U4.17 (SENSE1)
unnamed: R23.2, U5.7 (/RESET), U5.9 (/SLEEP)
unnamed: R25.1, U5.8 (ROSC)
unnamed: R26.2, U6.1 (P3A), U6.10 (P1A), U6.11 (P0A), U6.20 (P2A)
unnamed: R28.1, U5.20 (SENSE2)
unnamed: R29.1, U5.17 (SENSE1)
unnamed: R30.2, U6.15 (*RESET)
PB15/DAC0: D1.2 (A); also elsewhere on the board
TWCK0: R21.2, U6.5 (SCL); also elsewhere on the board
TWD0: R24.2, U6.6 (SDA); also elsewhere on the board
V_IN: C3.2, C4.2, C5.1, C6.1, C7.2, C8.2, C17.2, C18.2, C19.1, C20.1, C21.2, C22.2, C30.2, C31.1, C32.2, U1.16 (VBB1), U1.21 (VBB2), U2.16 (VBB1), U2.21 (VBB2), U3.16 (VBB1), U3.21 (VBB2), U4.16 (VBB1), U4.21 (VBB2), U5.16 (VBB1), U5.21 (VBB2); also elsewhere on the board
X_DIR: U1.14 (DIR); also elsewhere on the board
X_EN: R1.2, U1.23 (/ENABLE); also elsewhere on the board
X_MOT_1A: U1.18 (OUT1A); also elsewhere on the board
X_MOT_1B: U1.15 (OUT1B); also elsewhere on the board
X_MOT_2A: U1.19 (OUT2A); also elsewhere on the board
X_MOT_2B: U1.22 (OUT2B); also elsewhere on the board
X_REF: C13.1, J1.1, U1.12 (REF), U6.9 (P1W)
X_STEP: U1.11 (STEP); also elsewhere on the board
X_STOP: C41.1, R39.1; also elsewhere on the board
X_STOP_CONN: D7.2 (K), R39.2; also elsewhere on the board
Y_DIR: U3.14 (DIR); also elsewhere on the board
Y_EN: R11.2, U3.23 (/ENABLE); also elsewhere on the board
Y_MOT_1A: U3.18 (OUT1A); also elsewhere on the board
Y_MOT_1B: U3.15 (OUT1B); also elsewhere on the board
Y_MOT_2A: U3.19 (OUT2A); also elsewhere on the board
Y_MOT_2B: U3.22 (OUT2B); also elsewhere on the board
Y_REF: C27.1, J3.1, U3.12 (REF), U6.2 (P3W)
Y_STEP: U3.11 (STEP); also elsewhere on the board
Y_STOP: C37.1, R33.1; also elsewhere on the board
Y_STOP_CONN: D3.2 (K), R33.2; also elsewhere on the board
Z_DIR: U2.14 (DIR); also elsewhere on the board
Z_EN: R3.2, U2.23 (/ENABLE); also elsewhere on the board
Z_MOT_1A: U2.18 (OUT1A); also elsewhere on the board
Z_MOT_1B: U2.15 (OUT1B); also elsewhere on the board
Z_MOT_2A: U2.19 (OUT2A); also elsewhere on the board
Z_MOT_2B: U2.22 (OUT2B); also elsewhere on the board
Z_REF: C14.1, J2.1, U2.12 (REF), U6.19 (P2W)
Z_STEP: U2.11 (STEP); also elsewhere on the board
Z_STOP: C38.1, R31.1; also elsewhere on the board
Z_STOP_CONN: D4.2 (K), R31.2; also elsewhere on the board

Notes on the sheet:
2k7 resistor chosen to give range of VRef with 0R1 sense resistors for full range of current, to use the maximum current cooling would be required.
Endstops.
Digital Current Limit Control
Z-Axis Stepper Driver
Extruder 0 Stepper Driver
Y-Axis Stepper Driver
X-Axis Stepper Driver
Extruder 1 Stepper Driver
DAC Control for E1
DAC voltage range 0.55V-2.75V if Vana = 3.3V Diode with Vfwd of 0.6V drops the voltage range to approx 0V-2.15V (different from the same range as the Digipot). Note that Diodes Vfwd depends on current. The current flow is set by the resistor (2K15), at 2.15V = 1mA decreasing as the voltage decrease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

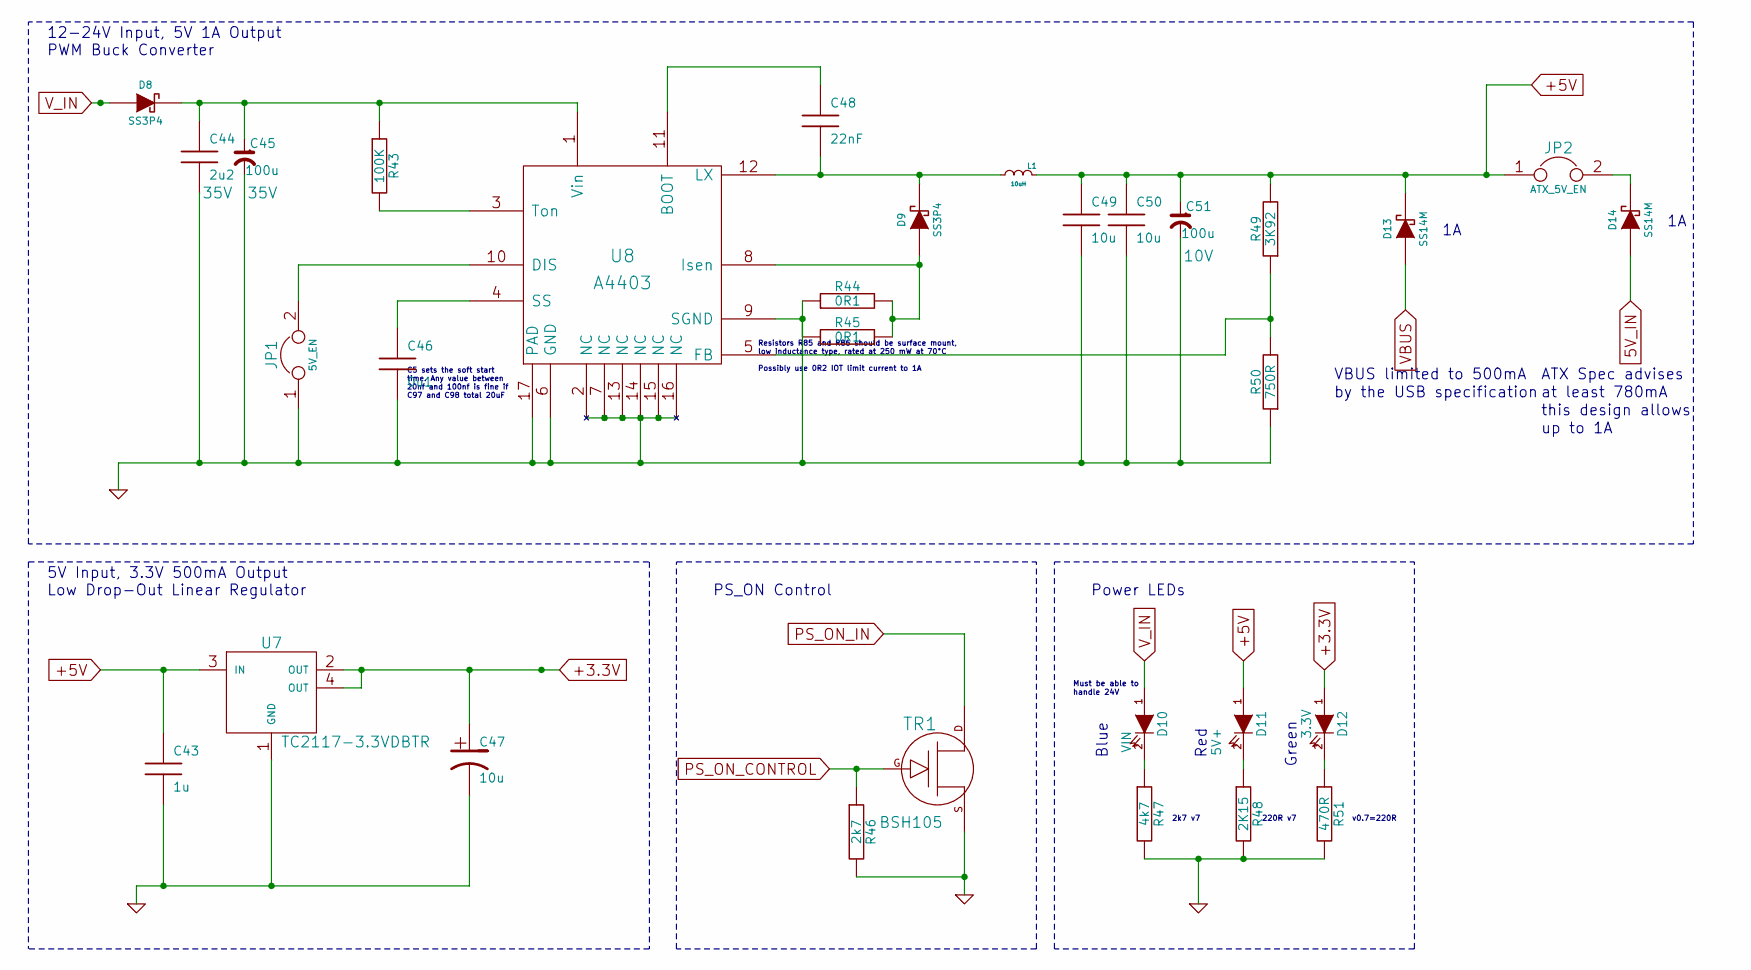
[picture p11: schematic Power.sch, Duet]

Parts:
C43: 1u; 1mf_capacitor
C44: 2u2; 2mf2_capacitor; Voltage 35V
C45: 100u; 100mf_capacitor; Voltage 35V
C46: 0u1; 0mf1_capacitor
C47, C49, C50: 10u; 10mf_capacitor
C48: 22nF; 22nf_capacitor
C51: 100u; 100mf_capacitor; Voltage 10V
D8, D9: SS3P4
D10: VIN; V_IN_Diode_0603
D11: 5V+; 5V_Diode_0603
D12: 3.3V; 33V_Diode_0603
D13, D14: SS14M
JP1: 5V_EN; JUMPER
JP2: ATX_5V_EN; JUMPER
L1: 10uH; 10mH_L_6x6
R43: 100K; 100k_R_0603
R44, R45: 0R1; 0R1_R_1206
R46: 2k7; 2k7_R_0603
R47: 4k7; 4k7_R_0603
R48: 2K15; 2k15_R_0603
R49: 3K92; 3k92_R_0603
R50: 750R; 750R_R_0603
R51: 470R; 470R_R_0603
TR1: BSH105; BSH105_SOT-23
U7: TC2117-3.3VDBTR
U8: A4403; A4403_QFN16-4x4

Connections:
5V_IN: D14.1 (A); also elsewhere on the board
+3.3V: C47.1, D12.1 (A), U7.2 (OUT), U7.4 (OUT); also elsewhere on the board
+5V: C43.1, C49.1, C50.1, C51.1, D11.1 (A), D13.2 (K), JP2.1, L1.1 (A), R49.2, U7.3 (IN); also elsewhere on the board
GND: C43.2, C44.2, C45.2, C46.2, C47.2, C49.2, C50.2, C51.2, JP1.1, R44.1, R45.1, R46.2, R47.2, R48.2, R50.1, R51.2, TR1.S, U7.1 (GND), U8.2 (NC), U8.6 (GND), U8.7 (NC), U8.9 (SGND), U8.13 (NC), U8.14 (NC), U8.15 (NC), U8.16 (NC), U8.17 (PAD); also elsewhere on the board
unnamed: C44.1, C45.1, D8.2 (K), R43.1, U8.1 (Vin)
unnamed: C46.1, U8.4 (SS)
unnamed: C48.1, U8.11 (BOOT)
unnamed: C48.2, D9.2 (K), L1.2 (B), U8.12 (LX)
unnamed: D9.1 (A), R44.2, R45.2, U8.8 (Isen)
unnamed: D10.2 (K), R47.1
unnamed: D11.2 (K), R48.1
unnamed: D12.2 (K), R51.1
unnamed: D14.2 (K), JP2.2
unnamed: JP1.2, U8.10 (DIS)
unnamed: R43.2, U8.3 (Ton)
unnamed: R49.1, R50.2, U8.5 (FB)
PS_ON_CONTROL: R46.1, TR1.G; also elsewhere on the board
PS_ON_IN: TR1.D; also elsewhere on the board
VBUS: D13.1 (A); also elsewhere on the board
V_IN: D8.1 (A), D10.1 (A); also elsewhere on the board

Notes on the sheet:
PS_ON Control
up to 1A
this design allows
at least 780mA
ATX Spec advises
by the USB specification
VBUS limited to 500mA
5V Input, 3.3V 500mA Output Low Drop-Out Linear Regulator
12-24V Input, 5V 1A Output PWM Buck Converter
2k7 v7
220R v7
v0.7=220R
Resistors R85 and R86 should be surface mount, low inductance type, rated at 250 mW at 70°C Possibly use 0R2 IOT limit current to 1A
C5 sets the soft start time. Any value between 20nf and 100nf is fine if C97 and C98 total 20uF
Power LEDs
Must be able to handle 24V
Blue
Red
Green

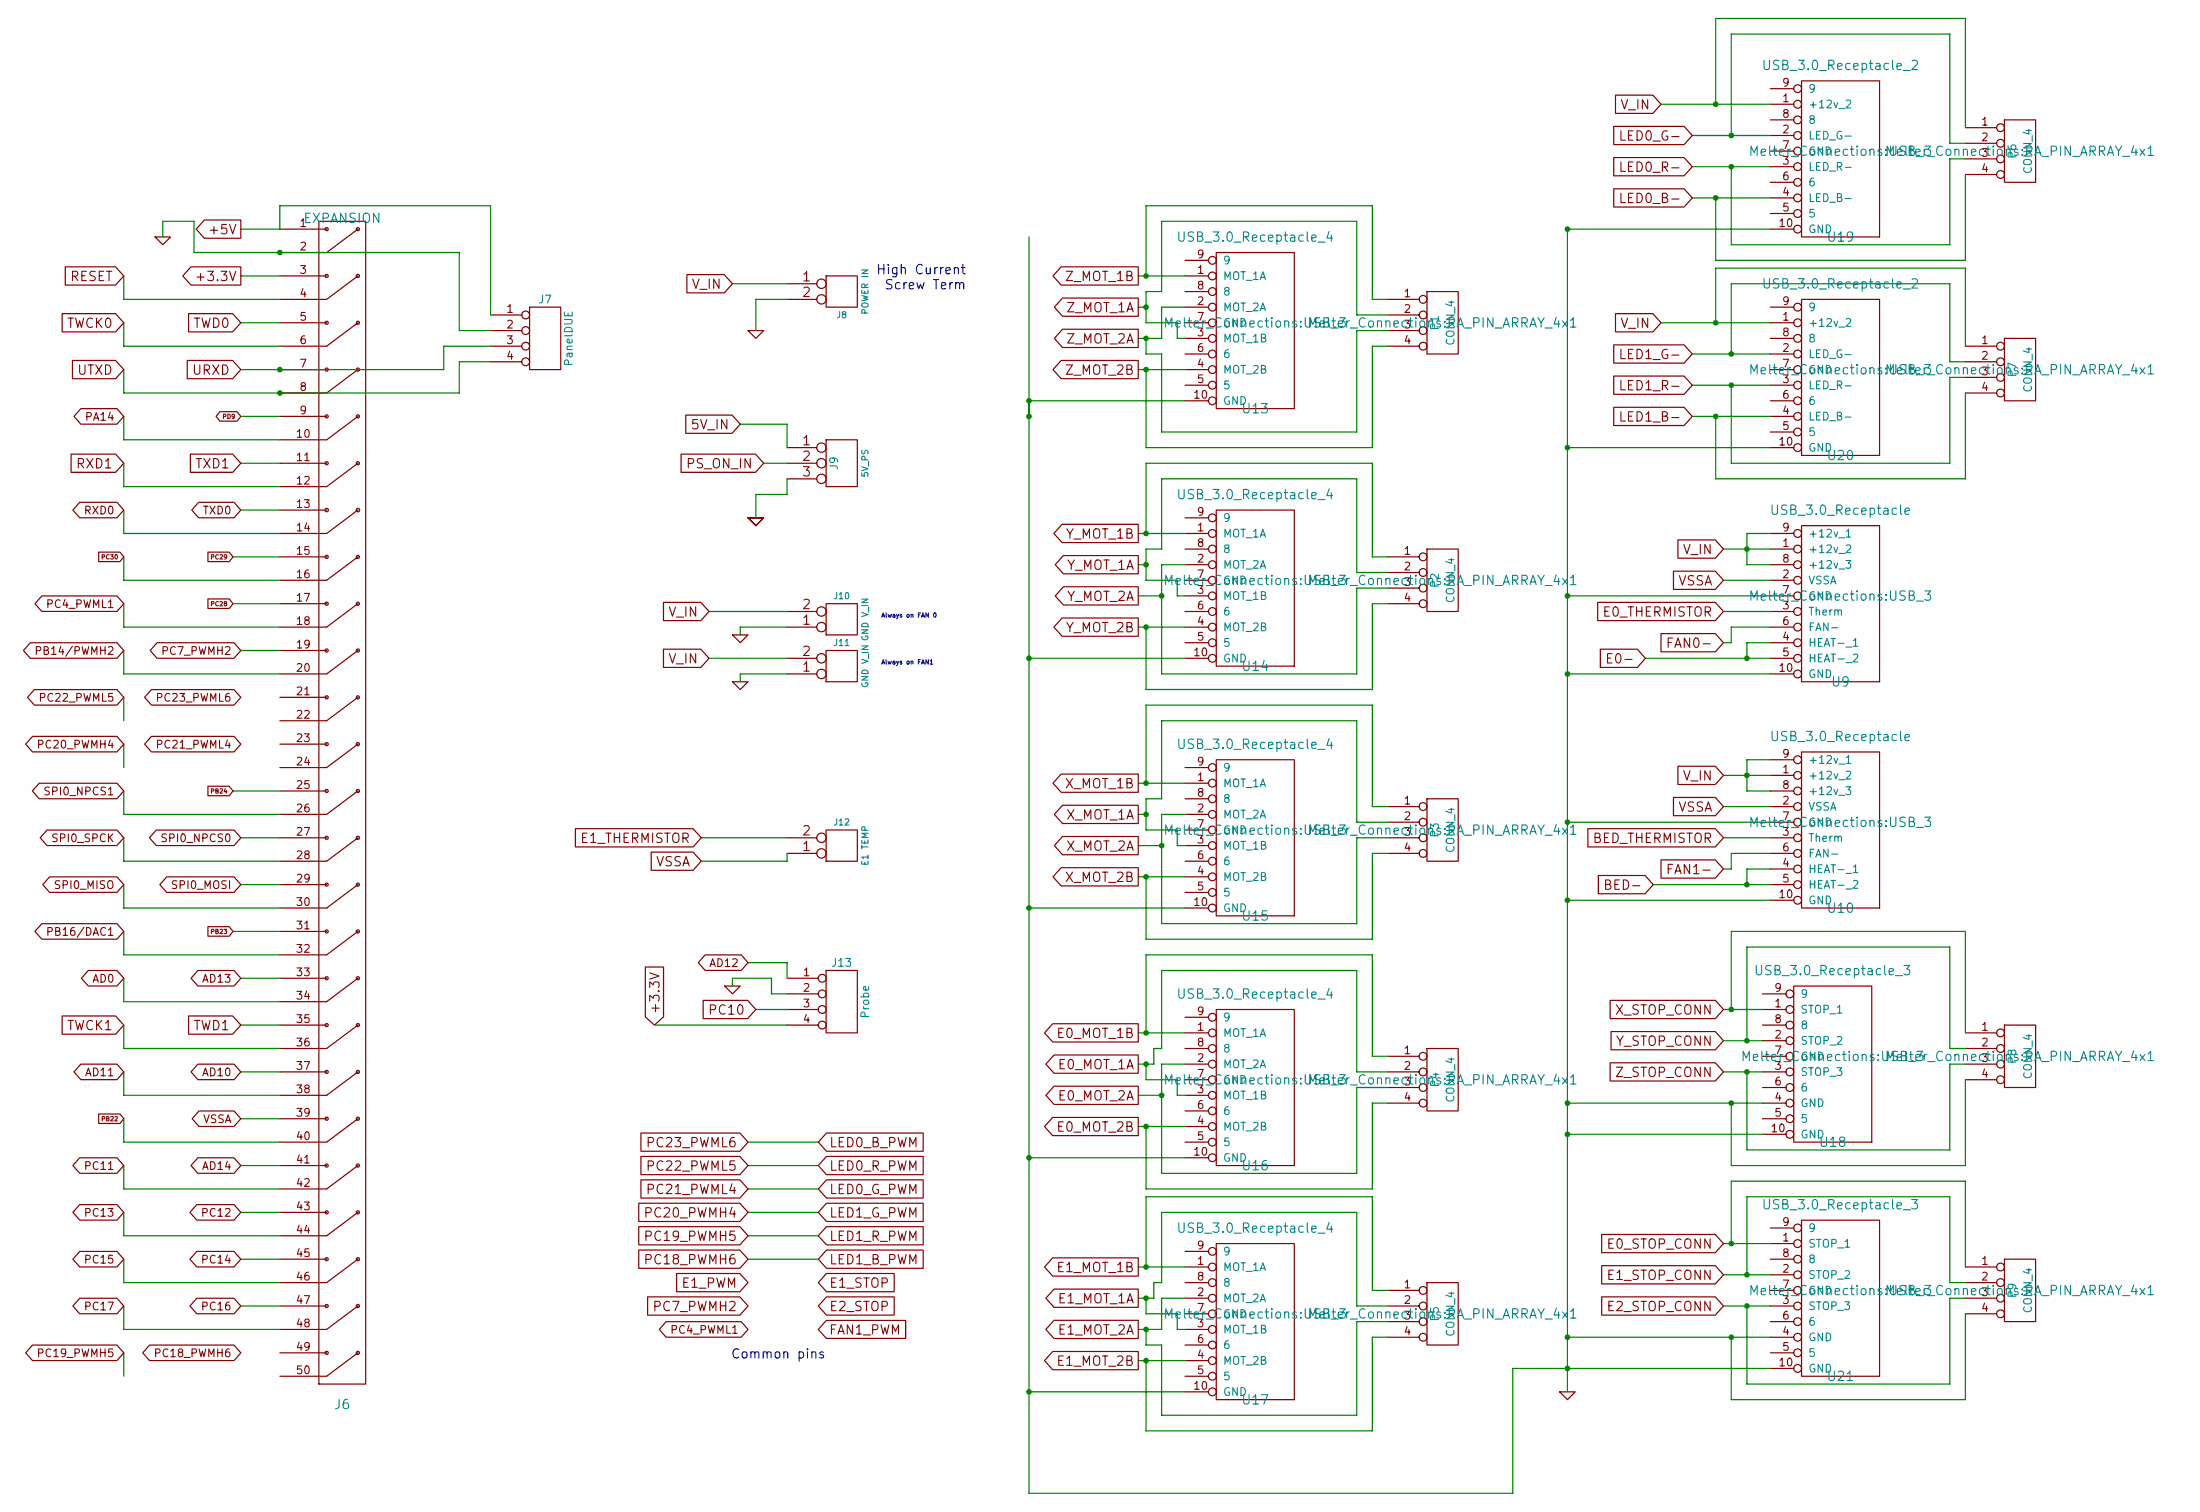
[picture p12: schematic Headers.sch, Duet]

Parts:
J6: EXPANSION; PIN_ARRAY_25X2
J7: PanelDUE; PIN_ARRAY_4x1
J8: POWER IN; V_TERM_2-WAY_6.35mm
J9: 5V_PS; 5VPSGND_PIN_ARRAY_3X1
J10, J11: GND V_IN; JUMPER
J12: E1 TEMP; PIN_ARRAY_2X1
J13: Probe; PIN_ARRAY_4x1
P1, P2, P3, P4, P5, P6, P7, P8, P9: CONN_4; RA_PIN_ARRAY_4x1
U9, U10: USB_3.0_Receptacle; USB_3
U13, U14, U15, U16, U17: USB_3.0_Receptacle_4; USB_3
U18, U21: USB_3.0_Receptacle_3; USB_3
U19, U20: USB_3.0_Receptacle_2; USB_3

Connections:
5V_IN: J9.1; also elsewhere on the board
+3.3V: J6.3, J13.4; also elsewhere on the board
+5V: J6.1, J7.1; also elsewhere on the board
AD0: J6.34; also elsewhere on the board
AD10: J6.37; also elsewhere on the board
AD11: J6.38; also elsewhere on the board
AD12: J13.1; also elsewhere on the board
AD13: J6.33; also elsewhere on the board
AD14: J6.41; also elsewhere on the board
E1_THERMISTOR: J12.2 (PM); also elsewhere on the board
GND: J6.2, J7.2, J8.2 (PM), J9.3, J10.1, J11.1, J13.2, P8.4, P9.4, U9.7 (GND), U9.10 (GND), U10.7 (GND), U10.10 (GND), U13.10 (GND), U14.10 (GND), U15.10 (GND), U16.10 (GND), U17.10 (GND), U18.4 (GND), U18.10 (GND), U19.10 (GND), U20.10 (GND), U21.4 (GND), U21.10 (GND); also elsewhere on the board
unnamed: P1.1, U13.1 (MOT_1A)
unnamed: P1.2, U13.3 (MOT_1B)
unnamed: P1.3, U13.2 (MOT_2A)
unnamed: P1.4, U13.4 (MOT_2B)
unnamed: P2.1, U14.1 (MOT_1A)
unnamed: P2.2, U14.3 (MOT_1B)
unnamed: P2.3, U14.2 (MOT_2A)
unnamed: P2.4, U14.4 (MOT_2B)
unnamed: P3.1, U15.1 (MOT_1A)
unnamed: P3.2, U15.3 (MOT_1B)
unnamed: P3.3, U15.2 (MOT_2A)
unnamed: P3.4, U15.4 (MOT_2B)
unnamed: P4.1, U16.1 (MOT_1A)
unnamed: P4.2, U16.3 (MOT_1B)
unnamed: P4.3, U16.2 (MOT_2A)
unnamed: P4.4, U16.4 (MOT_2B)
unnamed: P5.1, U17.1 (MOT_1A)
unnamed: P5.2, U17.3 (MOT_1B)
unnamed: P5.3, U17.2 (MOT_2A)
unnamed: P5.4, U17.4 (MOT_2B)
unnamed: P6.2, U19.2 (LED_G-)
unnamed: P6.3, U19.3 (LED_R-)
unnamed: P6.4, U19.4 (LED_B-)
unnamed: P7.2, U20.2 (LED_G-)
unnamed: P7.3, U20.3 (LED_R-)
unnamed: P7.4, U20.4 (LED_B-)
unnamed: P8.1, U18.1 (STOP_1)
unnamed: P8.2, U18.2 (STOP_2)
unnamed: P8.3, U18.3 (STOP_3)
unnamed: P9.1, U21.1 (STOP_1)
unnamed: P9.2, U21.2 (STOP_2)
unnamed: P9.3, U21.3 (STOP_3)
unnamed: U9.4 (HEAT-_1), U9.5 (HEAT-_2)
unnamed: U10.4 (HEAT-_1), U10.5 (HEAT-_2)
PA14: J6.10; also elsewhere on the board
PB14/PWMH2: J6.20; also elsewhere on the board
PB16/DAC1: J6.32; also elsewhere on the board
PB22: J6.40; also elsewhere on the board
PB23: J6.31; also elsewhere on the board
PB24: J6.25; also elsewhere on the board
PC4_PWML1: J6.18
PC7_PWMH2: J6.19
PC10: J13.3; also elsewhere on the board
PC11: J6.42; also elsewhere on the board
PC12: J6.43; also elsewhere on the board
PC13: J6.44; also elsewhere on the board
PC14: J6.45; also elsewhere on the board
PC15: J6.46; also elsewhere on the board
PC16: J6.47; also elsewhere on the board
PC17: J6.48; also elsewhere on the board
PC28: J6.17; also elsewhere on the board
PC29: J6.15; also elsewhere on the board
PC30: J6.16; also elsewhere on the board
PD9: J6.9; also elsewhere on the board
PS_ON_IN: J9.2 (PM); also elsewhere on the board
RESET: J6.4; also elsewhere on the board
RXD0: J6.14; also elsewhere on the board
RXD1: J6.12; also elsewhere on the board
SPI0_MISO: J6.30; also elsewhere on the board
SPI0_MOSI: J6.29; also elsewhere on the board
SPI0_NPCS0: J6.27; also elsewhere on the board
SPI0_NPCS1: J6.26; also elsewhere on the board
SPI0_SPCK: J6.28; also elsewhere on the board
TWCK0: J6.6; also elsewhere on the board
TWCK1: J6.36; also elsewhere on the board
TWD0: J6.5; also elsewhere on the board
TWD1: J6.35; also elsewhere on the board
TXD0: J6.13; also elsewhere on the board
TXD1: J6.11; also elsewhere on the board
URXD: J6.7, J7.3; also elsewhere on the board
UTXD: J6.8, J7.4; also elsewhere on the board
VSSA: J6.39, J12.1, U9.2 (VSSA), U10.2 (VSSA); also elsewhere on the board
V_IN: J8.1, J10.2 (PM), J11.2 (PM), P6.1, P7.1, U9.1 (+12v_2), U9.8 (+12v_3), U9.9 (+12v_1), U10.1 (+12v_2), U10.8 (+12v_3), U10.9 (+12v_1), U19.1 (+12v_2), U20.1 (+12v_2); also elsewhere on the board

Notes on the sheet:
High Current Screw Term
Always on FAN 0
Common pins
Always on FAN1

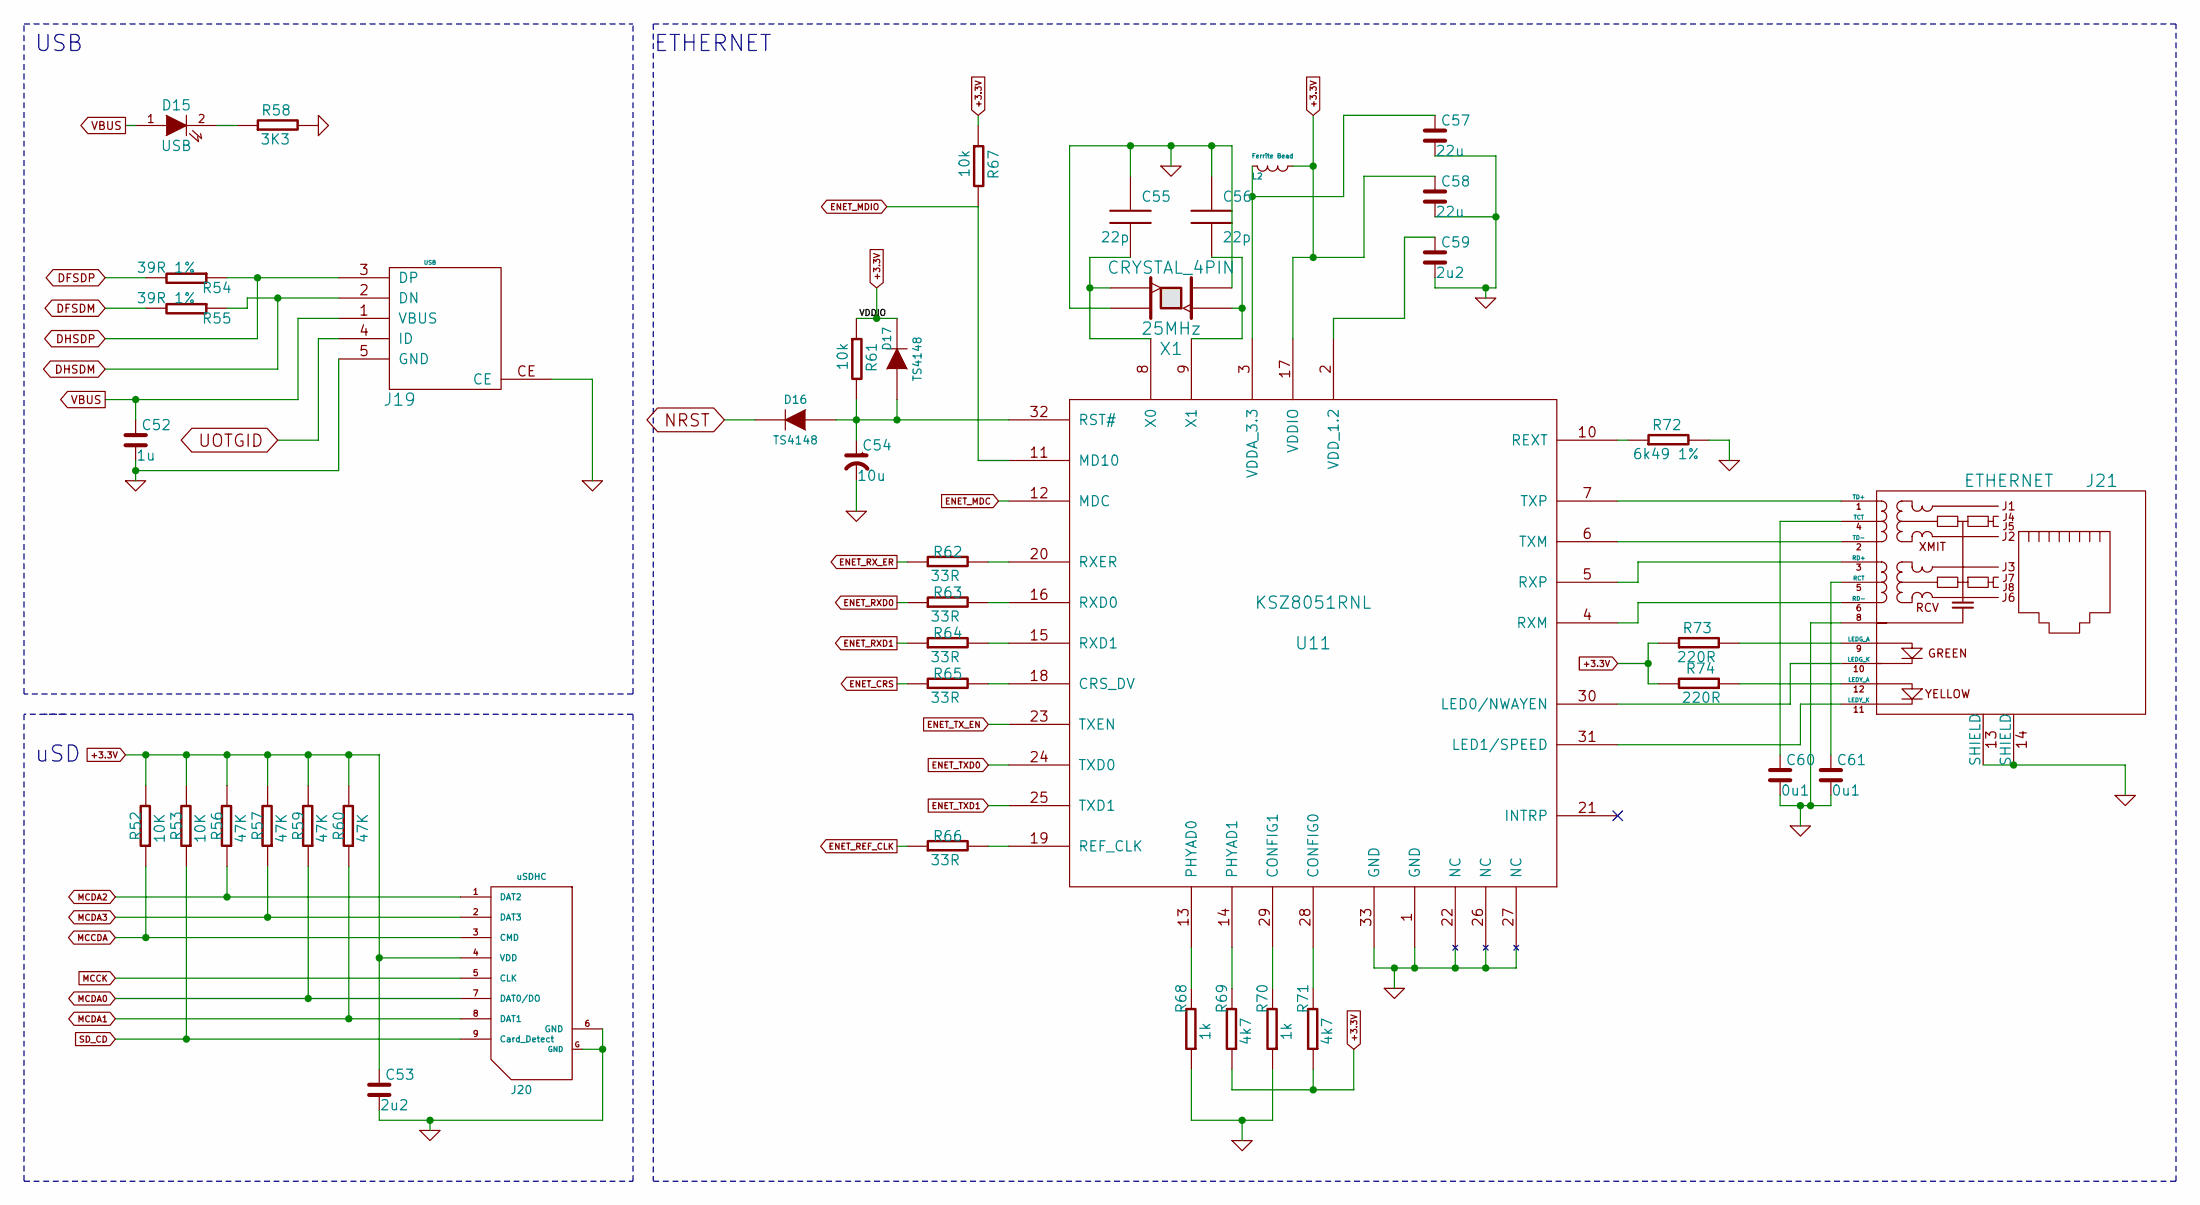
[picture p13: schematic Comms.sch, Duet]

Parts:
C52: 1u; 1mf_capacitor
C53, C59: 2u2; 2mf2_capacitor
C54: 10u; 10mf_capacitor
C55, C56: 22p; 22pf_capacitor
C57, C58: 22u; 22mf_Capacitor_1210
C60, C61: 0u1; 0mf1_capacitor
D15: USB; USB_Diode_0603
D16, D17: TS4148; TS4148_Diode_0805
J19: USB; uSD_SKT
J20: uSDHC; SD_Card_Receptacle
J21: ETHERNET; RJ45_MAG
L2: Ferrite Bead; FERRITE_BEAD
R52, R53: 10K; 10k_R_0603
R54, R55: 39R 1%; 39_1per_R_0603
R56, R57, R59, R60: 47K; 47k_R_0603
R58: 3K3; 3k3_R_0603
R61, R67: 10k; 10k_R_0603
R62, R63, R64, R65, R66: 33R; 33R_R_0603
R68, R70: 1k; 1k_R_0603
R69, R71: 4k7; 4k7_R_0603
R72: 6k49 1%; 6k49_1_per_R_0603
R73, R74: 220R; 220R_R_0603
U11: KSZ8051RNL
X1: CRYSTAL_4PIN; Xtal_5x3.2

Connections:
+3.3V: C53.1, C58.1, D17.1 (K), J20.4 (VDD), L2.2 (B), R52.2, R53.2, R56.2, R57.2, R59.2, R60.2, R61.1, R67.1, R69.1, R71.1, R73.1, R74.2, U11.17 (VDDIO); also elsewhere on the board
DFSDM: R55.2; also elsewhere on the board
DFSDP: R54.2; also elsewhere on the board
DHSDM: J19.2 (DN), R55.1; also elsewhere on the board
DHSDP: J19.3 (DP), R54.1; also elsewhere on the board
ENET_CRS: R65.1; also elsewhere on the board
ENET_MDC: U11.12 (MDC); also elsewhere on the board
ENET_MDIO: R67.2, U11.11 (MD10); also elsewhere on the board
ENET_REF_CLK: R66.1; also elsewhere on the board
ENET_RXD0: R63.1; also elsewhere on the board
ENET_RXD1: R64.1; also elsewhere on the board
ENET_RX_ER: R62.1; also elsewhere on the board
ENET_TXD0: U11.24 (TXD0); also elsewhere on the board
ENET_TXD1: U11.25 (TXD1); also elsewhere on the board
ENET_TX_EN: U11.23 (TXEN); also elsewhere on the board
GND: C52.2, C53.2, C54.2, C55.1, C56.1, C57.2, C58.2, C59.2, C60.2, C61.2, J19.5 (GND), J19.CE, J20.6 (GND), J20.G (GND), J21.8, J21.13 (SHIELD), J21.14 (SHIELD), R58.2, R68.1, R70.1, R72.2, U11.1 (GND), U11.22 (NC), U11.26 (NC), U11.27 (NC), U11.33 (GND), X1.2, X1.4; also elsewhere on the board
MCCDA: J20.3 (CMD), R52.1; also elsewhere on the board
MCCK: J20.5 (CLK); also elsewhere on the board
MCDA0: J20.7 (DAT0/DO), R59.1; also elsewhere on the board
MCDA1: J20.8 (DAT1), R60.1; also elsewhere on the board
MCDA2: J20.1 (DAT2), R56.1; also elsewhere on the board
MCDA3: J20.2 (DAT3), R57.1; also elsewhere on the board
NRST: D16.1 (K); also elsewhere on the board
unnamed: C54.1, D16.2 (A), D17.2 (A), R61.2, U11.32 (RST#)
unnamed: C55.2, U11.8 (X0), X1.3
unnamed: C56.2, U11.9 (X1), X1.1
unnamed: C57.1, L2.1 (A), U11.3 (VDDA_3.3)
unnamed: C59.1, U11.2 (VDD_1.2)
unnamed: C60.1, J21.4 (TCT)
unnamed: C61.1, J21.5 (RCT)
unnamed: D15.2 (K), R58.1
unnamed: J21.1 (TD+), U11.7 (TXP)
unnamed: J21.2 (TD-), U11.6 (TXM)
unnamed: J21.3 (RD+), U11.5 (RXP)
unnamed: J21.6 (RD-), U11.4 (RXM)
unnamed: J21.9 (LEDG_A), R73.2
unnamed: J21.10 (LEDG_K), U11.30 (LED0/NWAYEN)
unnamed: J21.11 (LEDY_K), U11.31 (LED1/SPEED)
unnamed: J21.12 (LEDY_A), R74.1
unnamed: R62.2, U11.20 (RXER)
unnamed: R63.2, U11.16 (RXD0)
unnamed: R64.2, U11.15 (RXD1)
unnamed: R65.2, U11.18 (CRS_DV)
unnamed: R66.2, U11.19 (REF_CLK)
unnamed: R68.2, U11.13 (PHYAD0)
unnamed: R69.2, U11.14 (PHYAD1)
unnamed: R70.2, U11.29 (CONFIG1)
unnamed: R71.2, U11.28 (CONFIG0)
unnamed: R72.1, U11.10 (REXT)
SD_CD: J20.9 (Card_Detect), R53.1; also elsewhere on the board
UOTGID: J19.4 (ID); also elsewhere on the board
VBUS: C52.1, D15.1 (A), J19.1 (VBUS); also elsewhere on the board

Notes on the sheet:
uSD
ETHERNET
USB
