woodsmoke/Due_SB/Duet-master/Duet0.8.5/Duet0.85.kicad_pcb

## KiCad design Duet-master/Duet0.8.5/Duet0.85.kicad_pcb (continued)

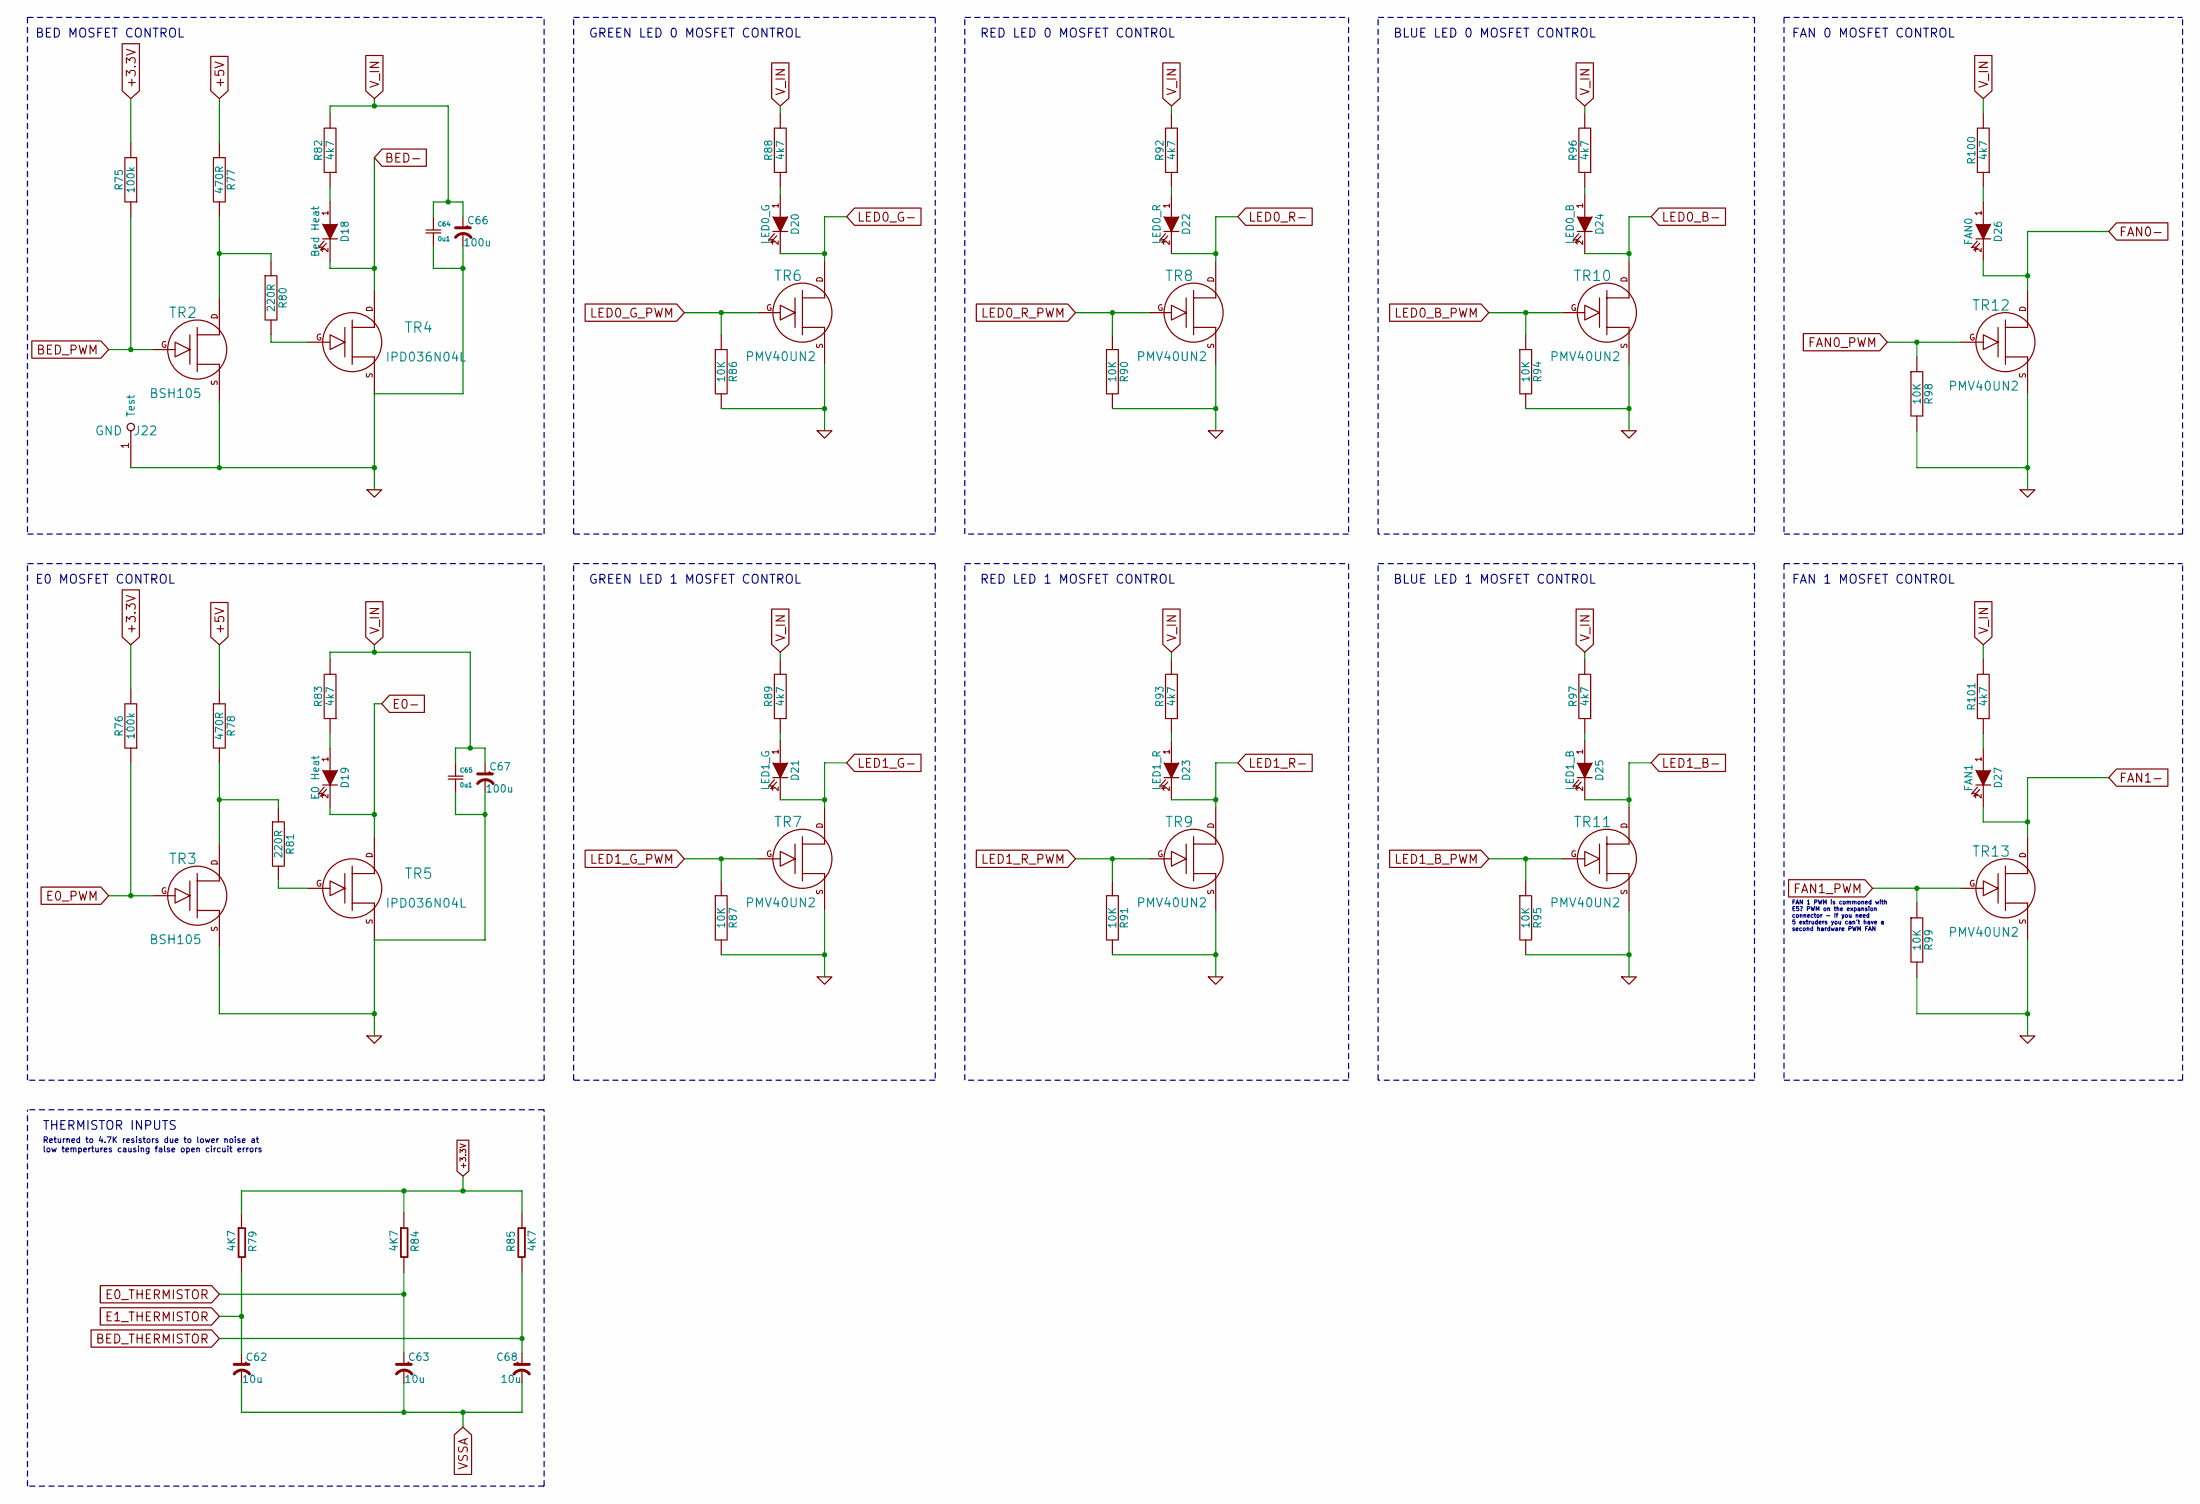
[picture p14: schematic Htr_Fan.sch, Duet]

Parts:
C62, C63, C68: 10u; 10mf_capacitor
C64, C65: 0u1; 0mf1_capacitor
C66, C67: 100u; 100mf_capacitor
D18: Bed Heat; BED_Diode_0603
D19: E0 Heat; E0_Diode_0603
D20: LED0_G; LED0_diode
D21: LED1_G; LED0_diode
D22: LED0_R; LED0_diode
D23: LED1_R; LED0_diode
D24: LED0_B; LED0_diode
D25: LED1_B; LED0_diode
D26: FAN0; FAN0_diode
D27: FAN1; FAN1_diode
J22: GND; GND_TP
R75, R76: 100k; 100k_R_0603
R77, R78: 470R; 470R_R_0603
R79, R84, R85: 4K7; 4k7_R_0603
R80, R81: 220R; 220R_R_0603
R82, R83, R88, R89, R92, R93, R96, R97, R100, R101: 4k7; 4k7_R_0603
R86, R87, R90, R91, R94, R95, R98, R99: 10K; 10k_R_0603
TR2, TR3: BSH105; BSH105_SOT-23
TR4, TR5: IPD036N04L; IPD036N04L_D-PAK
TR6, TR7, TR8, TR9, TR10, TR11, TR12, TR13: PMV40UN2; PMV40UN2_SOT-23

Connections:
+3.3V: R75.2, R76.2, R79.1, R84.1, R85.1; also elsewhere on the board
+5V: R77.1, R78.1; also elsewhere on the board
BED-: D18.2 (K), TR4.D; also elsewhere on the board
BED_PWM: R75.1, TR2.G; also elsewhere on the board
BED_THERMISTOR: C68.1, R85.2; also elsewhere on the board
E0-: D19.2 (K), TR5.D; also elsewhere on the board
E0_PWM: R76.1, TR3.G; also elsewhere on the board
E0_THERMISTOR: C63.1, R84.2; also elsewhere on the board
E1_THERMISTOR: C62.1, R79.2; also elsewhere on the board
FAN0-: D26.2 (K), TR12.D; also elsewhere on the board
FAN0_PWM: R98.1, TR12.G; also elsewhere on the board
FAN1-: D27.2 (K), TR13.D; also elsewhere on the board
FAN1_PWM: R99.1, TR13.G; also elsewhere on the board
GND: C64.2, C65.2, C66.2, C67.2, J22.1, R86.2, R87.2, R90.2, R91.2, R94.2, R95.2, R98.2, R99.2, TR2.S, TR3.S, TR4.S, TR5.S, TR6.S, TR7.S, TR8.S, TR9.S, TR10.S, TR11.S, TR12.S, TR13.S; also elsewhere on the board
LED0_B-: D24.2 (K), TR10.D; also elsewhere on the board
LED0_G-: D20.2 (K), TR6.D; also elsewhere on the board
LED0_R-: D22.2 (K), TR8.D; also elsewhere on the board
LED1_B-: D25.2 (K), TR11.D; also elsewhere on the board
LED1_G-: D21.2 (K), TR7.D; also elsewhere on the board
LED1_R-: D23.2 (K), TR9.D; also elsewhere on the board
unnamed: D18.1 (A), R82.1
unnamed: D19.1 (A), R83.1
unnamed: D20.1 (A), R88.1
unnamed: D21.1 (A), R89.1
unnamed: D22.1 (A), R92.1
unnamed: D23.1 (A), R93.1
unnamed: D24.1 (A), R96.1
unnamed: D25.1 (A), R97.1
unnamed: D26.1 (A), R100.1
unnamed: D27.1 (A), R101.1
unnamed: R77.2, R80.1, TR2.D
unnamed: R78.2, R81.1, TR3.D
unnamed: R80.2, TR4.G
unnamed: R81.2, TR5.G
VSSA: C62.2, C63.2, C68.2; also elsewhere on the board
V_IN: C64.1, C65.1, C66.1, C67.1, R82.2, R83.2, R88.2, R89.2, R92.2, R93.2, R96.2, R97.2, R100.2, R101.2; also elsewhere on the board

Notes on the sheet:
Returned to 4.7K resistors due to lower noise at low tempertures causing false open circuit errors
THERMISTOR INPUTS
FAN 0 MOSFET CONTROL
E0 MOSFET CONTROL
BED MOSFET CONTROL
FAN 1 MOSFET CONTROL
FAN 1 PWM is commoned with E5? PWM on the expansion connector - If you need 5 extruders you can't have a second hardware PWM FAN
RED LED 0 MOSFET CONTROL
GREEN LED 0 MOSFET CONTROL
BLUE LED 0 MOSFET CONTROL
RED LED 1 MOSFET CONTROL
GREEN LED 1 MOSFET CONTROL
BLUE LED 1 MOSFET CONTROL

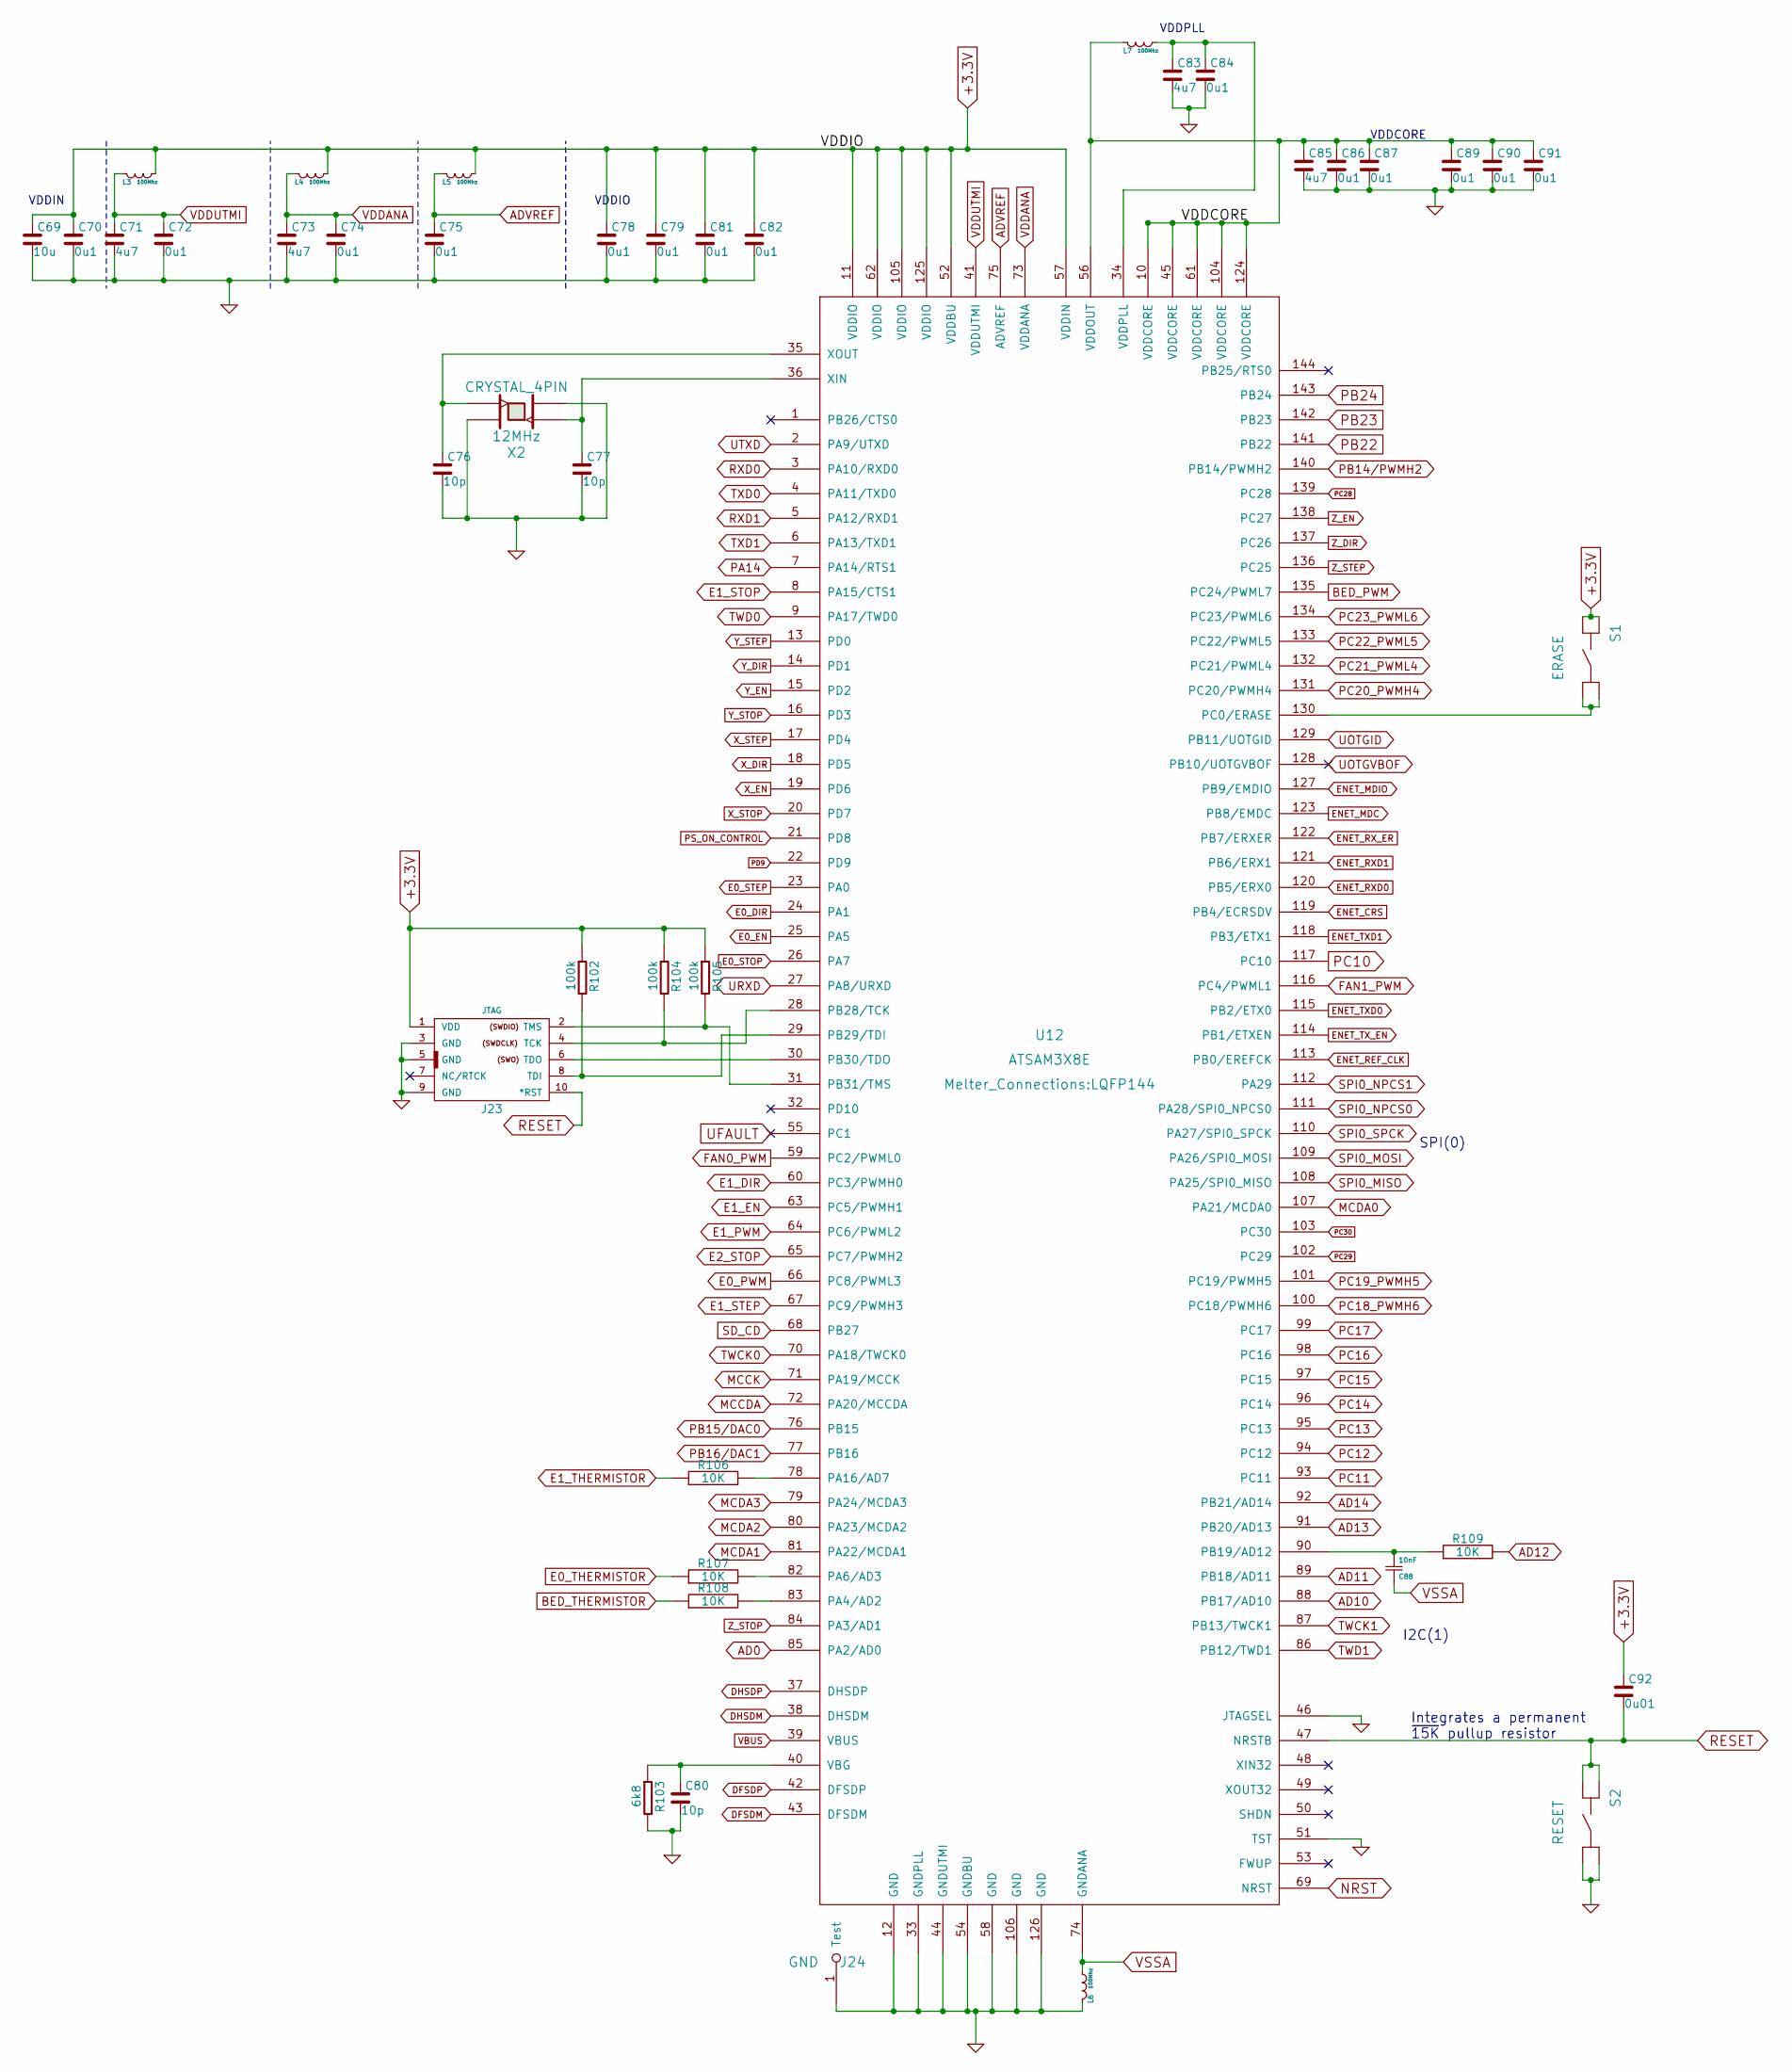
[picture p15: schematic Processor.sch, Duet]

Parts:
C69: 10u; 10mf_capacitor
C70, C72, C74, C75, C78, C79, C81, C82, C84, C86, C87, C89, C90, C91: 0u1; 0mf1_capacitor
C71, C73, C83, C85: 4u7; 4uf7_capacitor
C76, C77, C80: 10p; 10pf_capacitor
C88: 10nF; 10nf_capacitor
C92: 0u01; 0mf01_Capacitor
J23: JTAG; PIN_ARRAY_5x2
J24: GND; GND_TP
L3, L4, L5, L6, L7: 100Mhz; 100Mhz_R_0603
R102, R104, R105: 100k; 100k_R_0603
R103: 6k8; 6k8_R_0603
R106, R107, R108, R109: 10K; 10k_R_0603
S1: ERASE; SW_SIDE_1
S2: RESET; SW_SIDE_1
U12: ATSAM3X8E; LQFP144
X2: CRYSTAL_4PIN; Xtal_5x3.2

Connections:
+3.3V: C69.1, C70.1, C78.1, C79.1, C81.1, C82.1, C92.1, J23.1 (VDD), L3.2 (B), L4.2 (B), L5.2 (B), R102.1, R104.1, R105.1, S1.3, S1.4, U12.11 (VDDIO), U12.52 (VDDBU), U12.57 (VDDIN), U12.62 (VDDIO), U12.105 (VDDIO), U12.125 (VDDIO); also elsewhere on the board
/Processor/VDDCORE: C85.1, C86.1, C87.1, C89.1, C90.1, C91.1, L7.1 (A), U12.10 (VDDCORE), U12.45 (VDDCORE), U12.56 (VDDOUT), U12.61 (VDDCORE), U12.104 (VDDCORE), U12.124 (VDDCORE)
AD0: U12.85 (PA2/AD0); also elsewhere on the board
AD10: U12.88 (PB17/AD10); also elsewhere on the board
AD11: U12.89 (PB18/AD11); also elsewhere on the board
AD12: R109.2; also elsewhere on the board
AD13: U12.91 (PB20/AD13); also elsewhere on the board
AD14: U12.92 (PB21/AD14); also elsewhere on the board
ADVREF: C75.1, L5.1 (A), U12.75 (ADVREF)
BED_PWM: U12.135 (PC24/PWML7); also elsewhere on the board
BED_THERMISTOR: R108.1; also elsewhere on the board
DFSDM: U12.43 (DFSDM); also elsewhere on the board
DFSDP: U12.42 (DFSDP); also elsewhere on the board
DHSDM: U12.38 (DHSDM); also elsewhere on the board
DHSDP: U12.37 (DHSDP); also elsewhere on the board
E0_DIR: U12.24 (PA1); also elsewhere on the board
E0_EN: U12.25 (PA5); also elsewhere on the board
E0_PWM: U12.66 (PC8/PWML3); also elsewhere on the board
E0_STEP: U12.23 (PA0); also elsewhere on the board
E0_STOP: U12.26 (PA7); also elsewhere on the board
E0_THERMISTOR: R107.1; also elsewhere on the board
E1_DIR: U12.60 (PC3/PWMH0); also elsewhere on the board
E1_EN: U12.63 (PC5/PWMH1); also elsewhere on the board
E1_PWM: U12.64 (PC6/PWML2)
E1_STEP: U12.67 (PC9/PWMH3); also elsewhere on the board
E1_STOP: U12.8 (PA15/CTS1); also elsewhere on the board
E1_THERMISTOR: R106.1; also elsewhere on the board
E2_STOP: U12.65 (PC7/PWMH2); also elsewhere on the board
ENET_CRS: U12.119 (PB4/ECRSDV); also elsewhere on the board
ENET_MDC: U12.123 (PB8/EMDC); also elsewhere on the board
ENET_MDIO: U12.127 (PB9/EMDIO); also elsewhere on the board
ENET_REF_CLK: U12.113 (PB0/EREFCK); also elsewhere on the board
ENET_RXD0: U12.120 (PB5/ERX0); also elsewhere on the board
ENET_RXD1: U12.121 (PB6/ERX1); also elsewhere on the board
ENET_RX_ER: U12.122 (PB7/ERXER); also elsewhere on the board
ENET_TXD0: U12.115 (PB2/ETX0); also elsewhere on the board
ENET_TXD1: U12.118 (PB3/ETX1); also elsewhere on the board
ENET_TX_EN: U12.114 (PB1/ETXEN); also elsewhere on the board
FAN0_PWM: U12.59 (PC2/PWML0); also elsewhere on the board
FAN1_PWM: U12.116 (PC4/PWML1); also elsewhere on the board
GND: C69.2, C70.2, C71.2, C72.2, C73.2, C74.2, C75.2, C76.2, C77.2, C78.2, C79.2, C80.2, C81.2, C82.2, C83.2, C84.2, C85.2, C86.2, C87.2, C89.2, C90.2, C91.2, J23.3 (GND), J23.5 (GND), J23.9 (GND), J24.1, L6.1 (A), R103.2, S2.1, S2.2, U12.12 (GND), U12.33 (GNDPLL), U12.44 (GNDUTMI), U12.46 (JTAGSEL), U12.51 (TST), U12.54 (GNDBU), U12.58 (GND), U12.106 (GND), U12.126 (GND), X2.2, X2.4; also elsewhere on the board
MCCDA: U12.72 (PA20/MCCDA); also elsewhere on the board
MCCK: U12.71 (PA19/MCCK); also elsewhere on the board
MCDA0: U12.107 (PA21/MCDA0); also elsewhere on the board
MCDA1: U12.81 (PA22/MCDA1); also elsewhere on the board
MCDA2: U12.80 (PA23/MCDA2); also elsewhere on the board
MCDA3: U12.79 (PA24/MCDA3); also elsewhere on the board
NRST: U12.69 (NRST); also elsewhere on the board
unnamed: C76.1, U12.35 (XOUT), X2.3
unnamed: C77.1, U12.36 (XIN), X2.1
unnamed: C80.1, R103.1, U12.40 (VBG)
unnamed: C83.1, C84.1, L7.2 (B), U12.34 (VDDPLL)
unnamed: C88.2, R109.1, U12.90 (PB19/AD12)
unnamed: J23.2 (TMS), R105.2, U12.31 (PB31/TMS)
unnamed: J23.4 (TCK), R104.2, U12.28 (PB28/TCK)
unnamed: J23.6 (TDO), U12.30 (PB30/TDO)
unnamed: J23.8 (TDI), R102.2, U12.29 (PB29/TDI)
unnamed: R106.2, U12.78 (PA16/AD7)
unnamed: R107.2, U12.82 (PA6/AD3)
unnamed: R108.2, U12.83 (PA4/AD2)
unnamed: S1.1, S1.2, U12.130 (PC0/ERASE)
PA14: U12.7 (PA14/RTS1); also elsewhere on the board
PB14/PWMH2: U12.140 (PB14/PWMH2); also elsewhere on the board
PB15/DAC0: U12.76 (PB15); also elsewhere on the board
PB16/DAC1: U12.77 (PB16); also elsewhere on the board
PB22: U12.141 (PB22); also elsewhere on the board
PB23: U12.142 (PB23); also elsewhere on the board
PB24: U12.143 (PB24); also elsewhere on the board
PC10: U12.117 (PC10); also elsewhere on the board
PC11: U12.93 (PC11); also elsewhere on the board
PC12: U12.94 (PC12); also elsewhere on the board
PC13: U12.95 (PC13); also elsewhere on the board
PC14: U12.96 (PC14); also elsewhere on the board
PC15: U12.97 (PC15); also elsewhere on the board
PC16: U12.98 (PC16); also elsewhere on the board
PC17: U12.99 (PC17); also elsewhere on the board
PC28: U12.139 (PC28); also elsewhere on the board
PC29: U12.102 (PC29); also elsewhere on the board
PC30: U12.103 (PC30); also elsewhere on the board
PD9: U12.22 (PD9); also elsewhere on the board
PS_ON_CONTROL: U12.21 (PD8); also elsewhere on the board
RESET: C92.2, J23.10 (*RST), S2.3, S2.4, U12.47 (NRSTB); also elsewhere on the board
RXD0: U12.3 (PA10/RXD0); also elsewhere on the board
RXD1: U12.5 (PA12/RXD1); also elsewhere on the board
SD_CD: U12.68 (PB27); also elsewhere on the board
SPI0_MISO: U12.108 (PA25/SPI0_MISO); also elsewhere on the board
SPI0_MOSI: U12.109 (PA26/SPI0_MOSI); also elsewhere on the board
SPI0_NPCS0: U12.111 (PA28/SPI0_NPCS0); also elsewhere on the board
SPI0_NPCS1: U12.112 (PA29); also elsewhere on the board
SPI0_SPCK: U12.110 (PA27/SPI0_SPCK); also elsewhere on the board
TWCK0: U12.70 (PA18/TWCK0); also elsewhere on the board
TWCK1: U12.87 (PB13/TWCK1); also elsewhere on the board
TWD0: U12.9 (PA17/TWD0); also elsewhere on the board
TWD1: U12.86 (PB12/TWD1); also elsewhere on the board
TXD0: U12.4 (PA11/TXD0); also elsewhere on the board
TXD1: U12.6 (PA13/TXD1); also elsewhere on the board
UFAULT: U12.55 (PC1)
UOTGID: U12.129 (PB11/UOTGID); also elsewhere on the board
UOTGVBOF: U12.128 (PB10/UOTGVBOF)
URXD: U12.27 (PA8/URXD); also elsewhere on the board
UTXD: U12.2 (PA9/UTXD); also elsewhere on the board
VBUS: U12.39 (VBUS); also elsewhere on the board
VDDANA: C73.1, C74.1, L4.1 (A), U12.73 (VDDANA)
VDDUTMI: C71.1, C72.1, L3.1 (A), U12.41 (VDDUTMI)
VSSA: C88.1, L6.2 (B), U12.74 (GNDANA); also elsewhere on the board
X_DIR: U12.18 (PD5); also elsewhere on the board
X_EN: U12.19 (PD6); also elsewhere on the board
X_STEP: U12.17 (PD4); also elsewhere on the board
X_STOP: U12.20 (PD7); also elsewhere on the board
Y_DIR: U12.14 (PD1); also elsewhere on the board
Y_EN: U12.15 (PD2); also elsewhere on the board
Y_STEP: U12.13 (PD0); also elsewhere on the board
Y_STOP: U12.16 (PD3); also elsewhere on the board
Z_DIR: U12.137 (PC26); also elsewhere on the board
Z_EN: U12.138 (PC27); also elsewhere on the board
Z_STEP: U12.136 (PC25); also elsewhere on the board
Z_STOP: U12.84 (PA3/AD1); also elsewhere on the board

Notes on the sheet:
Integrates a permanent ~15K pullup resistor
SPI(0)
I2C(1)
VDDPLL
VDDCORE
VDDIO
VDDIN

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
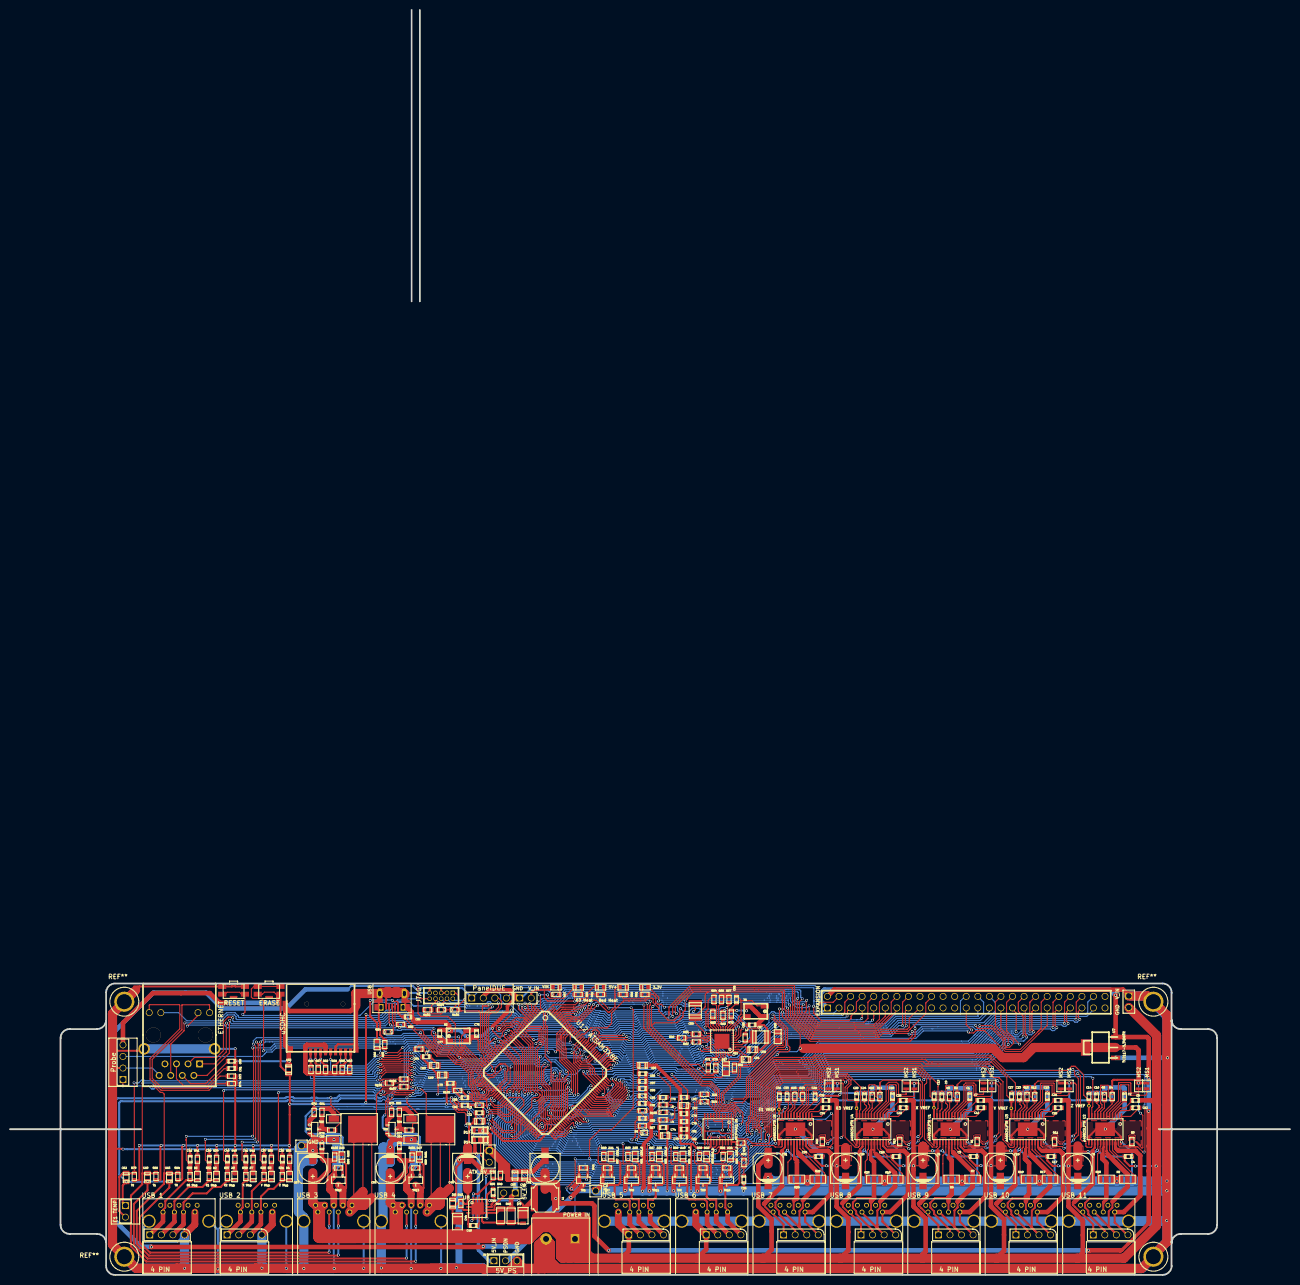
[picture p16: board Duet0.85.kicad_pcb from above]

Board: 4 copper layers, 234.0 x 64.0 mm, 313 parts (0 on the bottom side), 265 nets.

Other parts of the board:
H1, H2, H3, H4, H5, H6, H7, H8, H9: 4 PIN; RA_PIN_ARRAY_4x1
USB 1: SENSE 2; USB_3
USB 2: SENSE 1; USB_3
USB 3: PWR/SENSE 1; USB_3
USB 4: PWR/SENSE 2; USB_3
USB 5: LIGHT 2; USB_3
USB 6: LIGHT 1; USB_3
USB 7: MOTOR 1; USB_3
USB 8: MOTOR 2; USB_3
USB 9: MOTOR 3; USB_3
USB 10: MOTOR 4; USB_3
USB 11: MOTOR 5; USB_3

Their connections:
BED-: USB 4.4, USB 4.5; also elsewhere on the board
BED_THERMISTOR: USB 4.3; also elsewhere on the board
E0-: USB 3.4, USB 3.5; also elsewhere on the board
E0_MOT_1A: H6.2, USB 8.3; also elsewhere on the board
E0_MOT_1B: H6.1, USB 8.1; also elsewhere on the board
E0_MOT_2A: H6.3, USB 8.2; also elsewhere on the board
E0_MOT_2B: H6.4, USB 8.4; also elsewhere on the board
E0_STOP_CONN: H1.1, USB 1.1; also elsewhere on the board
E0_THERMISTOR: USB 3.3; also elsewhere on the board
E1_MOT_1A: H5.2, USB 7.3; also elsewhere on the board
E1_MOT_1B: H5.1, USB 7.1; also elsewhere on the board
E1_MOT_2A: H5.3, USB 7.2; also elsewhere on the board
E1_MOT_2B: H5.4, USB 7.4; also elsewhere on the board
E1_STOP_CONN: H1.2, USB 1.2; also elsewhere on the board
E2_STOP_CONN: H1.3, USB 1.3; also elsewhere on the board
FAN0-: USB 3.6; also elsewhere on the board
FAN1-: USB 4.6; also elsewhere on the board
GND: H1.4, H2.4, USB 1.4, USB 1.10, USB 2.4, USB 2.10, USB 3.7, USB 3.10, USB 4.7, USB 4.10, USB 5.10, USB 6.10, USB 7.10, USB 8.10, USB 9.10, USB 10.10, USB 11.10; also elsewhere on the board
LED0_B-: H4.4, USB 6.4; also elsewhere on the board
LED0_G-: H4.2, USB 6.2; also elsewhere on the board
LED0_R-: H4.3, USB 6.3; also elsewhere on the board
LED1_B-: H3.4, USB 5.4; also elsewhere on the board
LED1_G-: H3.2, USB 5.2; also elsewhere on the board
LED1_R-: H3.3, USB 5.3; also elsewhere on the board
VSSA: USB 3.2, USB 4.2; also elsewhere on the board
V_IN: H3.1, H4.1, USB 3.1, USB 3.8, USB 3.9, USB 4.1, USB 4.8, USB 4.9, USB 5.1, USB 6.1; also elsewhere on the board
X_MOT_1A: H7.2, USB 9.3; also elsewhere on the board
X_MOT_1B: H7.1, USB 9.1; also elsewhere on the board
X_MOT_2A: H7.3, USB 9.2; also elsewhere on the board
X_MOT_2B: H7.4, USB 9.4; also elsewhere on the board
X_STOP_CONN: H2.1, USB 2.1; also elsewhere on the board
Y_MOT_1A: H8.2, USB 10.3; also elsewhere on the board
Y_MOT_1B: H8.1, USB 10.1; also elsewhere on the board
Y_MOT_2A: H8.3, USB 10.2; also elsewhere on the board
Y_MOT_2B: H8.4, USB 10.4; also elsewhere on the board
Y_STOP_CONN: H2.2, USB 2.2; also elsewhere on the board
Z_MOT_1A: H9.2, USB 11.3; also elsewhere on the board
Z_MOT_1B: H9.1, USB 11.1; also elsewhere on the board
Z_MOT_2A: H9.3, USB 11.2; also elsewhere on the board
Z_MOT_2B: H9.4, USB 11.4; also elsewhere on the board
Z_STOP_CONN: H2.3, USB 2.3; also elsewhere on the board
