woodsmoke/Due_SB/Duet-master/Duet0.6/Processor.sch

## KiCad design Duet-master/Duet0.6/Processor.sch (2015-08-09)

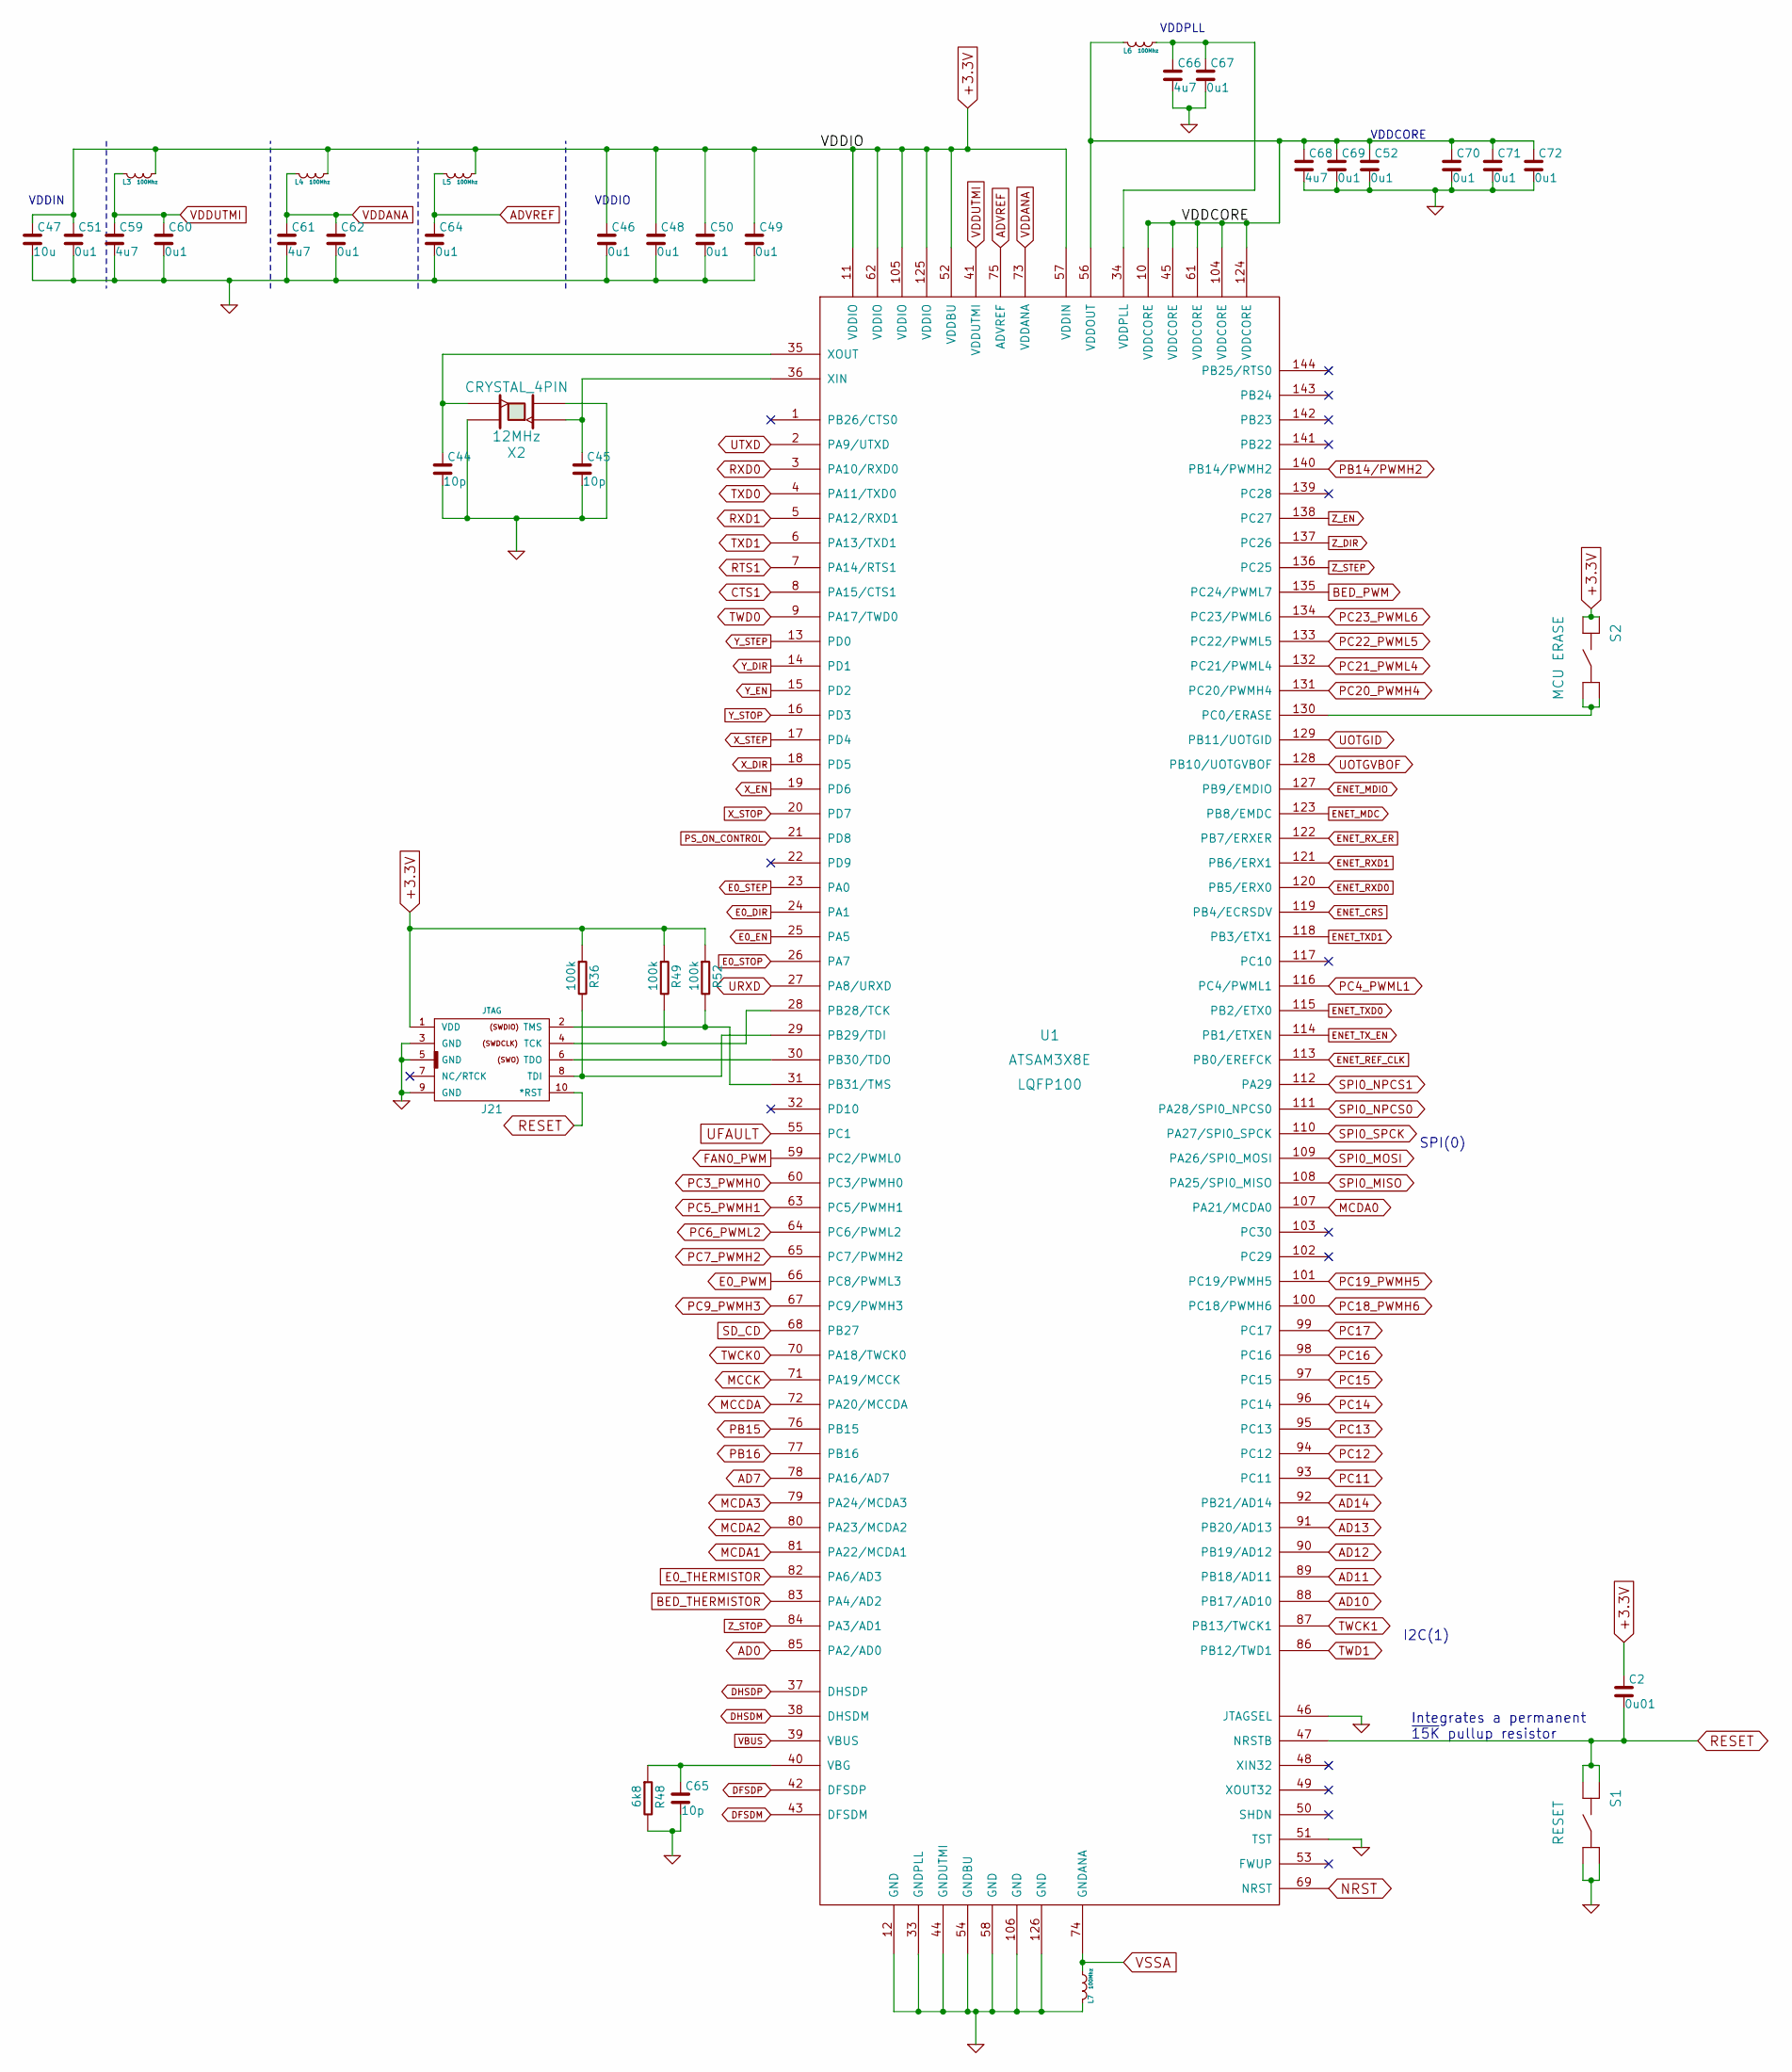
[picture p20: schematic Processor.sch]

Parts:
C2: 0u01
C44, C45, C65: 10p
C46, C48, C49, C50, C51, C52, C60, C62, C64, C67, C69, C70, C71, C72: 0u1
C47: 10u
C59, C61, C66, C68: 4u7
J21: JTAG
L3, L4, L5, L6, L7: 100Mhz
R36, R49, R52: 100k
R48: 6k8
S1: RESET
S2: MCU ERASE
U1: ATSAM3X8E; LQFP100
X2: CRYSTAL_4PIN

Connections:
+3.3V: C2.1, C46.1, C47.1, C48.1, C49.1, C50.1, C51.1, J21.1 (VDD), L3.2 (B), L4.2 (B), L5.2 (B), R36.1, R49.1, R52.1, S2.3, S2.4, U1.11 (VDDIO), U1.52 (VDDBU), U1.57 (VDDIN), U1.62 (VDDIO), U1.105 (VDDIO), U1.125 (VDDIO)
AD0: U1.85 (PA2/AD0)
AD7: U1.78 (PA16/AD7)
AD10: U1.88 (PB17/AD10)
AD11: U1.89 (PB18/AD11)
AD12: U1.90 (PB19/AD12)
AD13: U1.91 (PB20/AD13)
AD14: U1.92 (PB21/AD14)
ADVREF: C64.1, L5.1 (A), U1.75 (ADVREF)
BED_PWM: U1.135 (PC24/PWML7)
BED_THERMISTOR: U1.83 (PA4/AD2)
CTS1: U1.8 (PA15/CTS1)
DFSDM: U1.43 (DFSDM)
DFSDP: U1.42 (DFSDP)
DHSDM: U1.38 (DHSDM)
DHSDP: U1.37 (DHSDP)
E0_DIR: U1.24 (PA1)
E0_EN: U1.25 (PA5)
E0_PWM: U1.66 (PC8/PWML3)
E0_STEP: U1.23 (PA0)
E0_STOP: U1.26 (PA7)
E0_THERMISTOR: U1.82 (PA6/AD3)
ENET_CRS: U1.119 (PB4/ECRSDV)
ENET_MDC: U1.123 (PB8/EMDC)
ENET_MDIO: U1.127 (PB9/EMDIO)
ENET_REF_CLK: U1.113 (PB0/EREFCK)
ENET_RXD0: U1.120 (PB5/ERX0)
ENET_RXD1: U1.121 (PB6/ERX1)
ENET_RX_ER: U1.122 (PB7/ERXER)
ENET_TXD0: U1.115 (PB2/ETX0)
ENET_TXD1: U1.118 (PB3/ETX1)
ENET_TX_EN: U1.114 (PB1/ETXEN)
FAN0_PWM: U1.59 (PC2/PWML0)
GND: C44.2, C45.2, C46.2, C47.2, C48.2, C49.2, C50.2, C51.2, C52.2, C59.2, C60.2, C61.2, C62.2, C64.2, C65.2, C66.2, C67.2, C68.2, C69.2, C70.2, C71.2, C72.2, J21.3 (GND), J21.5 (GND), J21.9 (GND), L7.1 (A), R48.2, S1.1, S1.2, U1.12 (GND), U1.33 (GNDPLL), U1.44 (GNDUTMI), U1.46 (JTAGSEL), U1.51 (TST), U1.54 (GNDBU), U1.58 (GND), U1.106 (GND), U1.126 (GND), X2.2, X2.4
MCCDA: U1.72 (PA20/MCCDA)
MCCK: U1.71 (PA19/MCCK)
MCDA0: U1.107 (PA21/MCDA0)
MCDA1: U1.81 (PA22/MCDA1)
MCDA2: U1.80 (PA23/MCDA2)
MCDA3: U1.79 (PA24/MCDA3)
NRST: U1.69 (NRST)
unnamed: C44.1, U1.35 (XOUT), X2.3
unnamed: C45.1, U1.36 (XIN), X2.1
unnamed: C65.1, R48.1, U1.40 (VBG)
unnamed: C66.1, C67.1, L6.2 (B), U1.34 (VDDPLL)
unnamed: J21.2 (TMS), R52.2, U1.31 (PB31/TMS)
unnamed: J21.4 (TCK), R49.2, U1.28 (PB28/TCK)
unnamed: J21.6 (TDO), U1.30 (PB30/TDO)
unnamed: J21.8 (TDI), R36.2, U1.29 (PB29/TDI)
unnamed: S2.1, S2.2, U1.130 (PC0/ERASE)
PB14/PWMH2: U1.140 (PB14/PWMH2)
PB15: U1.76 (PB15)
PB16: U1.77 (PB16)
PC3_PWMH0: U1.60 (PC3/PWMH0)
PC4_PWML1: U1.116 (PC4/PWML1)
PC5_PWMH1: U1.63 (PC5/PWMH1)
PC6_PWML2: U1.64 (PC6/PWML2)
PC7_PWMH2: U1.65 (PC7/PWMH2)
PC9_PWMH3: U1.67 (PC9/PWMH3)
PC11: U1.93 (PC11)
PC12: U1.94 (PC12)
PC13: U1.95 (PC13)
PC14: U1.96 (PC14)
PC15: U1.97 (PC15)
PC16: U1.98 (PC16)
PC17: U1.99 (PC17)
PC18_PWMH6: U1.100 (PC18/PWMH6)
PC19_PWMH5: U1.101 (PC19/PWMH5)
PC20_PWMH4: U1.131 (PC20/PWMH4)
PC21_PWML4: U1.132 (PC21/PWML4)
PC22_PWML5: U1.133 (PC22/PWML5)
PC23_PWML6: U1.134 (PC23/PWML6)
PS_ON_CONTROL: U1.21 (PD8)
RESET: C2.2, J21.10 (*RST), S1.3, S1.4, U1.47 (NRSTB)
RTS1: U1.7 (PA14/RTS1)
RXD0: U1.3 (PA10/RXD0)
RXD1: U1.5 (PA12/RXD1)
SD_CD: U1.68 (PB27)
SPI0_MISO: U1.108 (PA25/SPI0_MISO)
SPI0_MOSI: U1.109 (PA26/SPI0_MOSI)
SPI0_NPCS0: U1.111 (PA28/SPI0_NPCS0)
SPI0_NPCS1: U1.112 (PA29)
SPI0_SPCK: U1.110 (PA27/SPI0_SPCK)
TWCK0: U1.70 (PA18/TWCK0)
TWCK1: U1.87 (PB13/TWCK1)
TWD0: U1.9 (PA17/TWD0)
TWD1: U1.86 (PB12/TWD1)
TXD0: U1.4 (PA11/TXD0)
TXD1: U1.6 (PA13/TXD1)
UFAULT: U1.55 (PC1)
UOTGID: U1.129 (PB11/UOTGID)
UOTGVBOF: U1.128 (PB10/UOTGVBOF)
URXD: U1.27 (PA8/URXD)
UTXD: U1.2 (PA9/UTXD)
VBUS: U1.39 (VBUS)
VDDANA: C61.1, C62.1, L4.1 (A), U1.73 (VDDANA)
VDDCORE: C52.1, C68.1, C69.1, C70.1, C71.1, C72.1, L6.1 (A), U1.10 (VDDCORE), U1.45 (VDDCORE), U1.56 (VDDOUT), U1.61 (VDDCORE), U1.104 (VDDCORE), U1.124 (VDDCORE)
VDDUTMI: C59.1, C60.1, L3.1 (A), U1.41 (VDDUTMI)
VSSA: L7.2 (B), U1.74 (GNDANA)
X_DIR: U1.18 (PD5)
X_EN: U1.19 (PD6)
X_STEP: U1.17 (PD4)
X_STOP: U1.20 (PD7)
Y_DIR: U1.14 (PD1)
Y_EN: U1.15 (PD2)
Y_STEP: U1.13 (PD0)
Y_STOP: U1.16 (PD3)
Z_DIR: U1.137 (PC26)
Z_EN: U1.138 (PC27)
Z_STEP: U1.136 (PC25)
Z_STOP: U1.84 (PA3/AD1)

Notes on the sheet:
Integrates a permanent ~15K pullup resistor
SPI(0)
I2C(1)
VDDPLL
VDDCORE
VDDIO
VDDIN
