woodsmoke/Due_SB/Duet-master/Duet0.6/Stepper_Drv.sch

## KiCad design Duet-master/Duet0.6/Stepper_Drv.sch (2015-08-09)

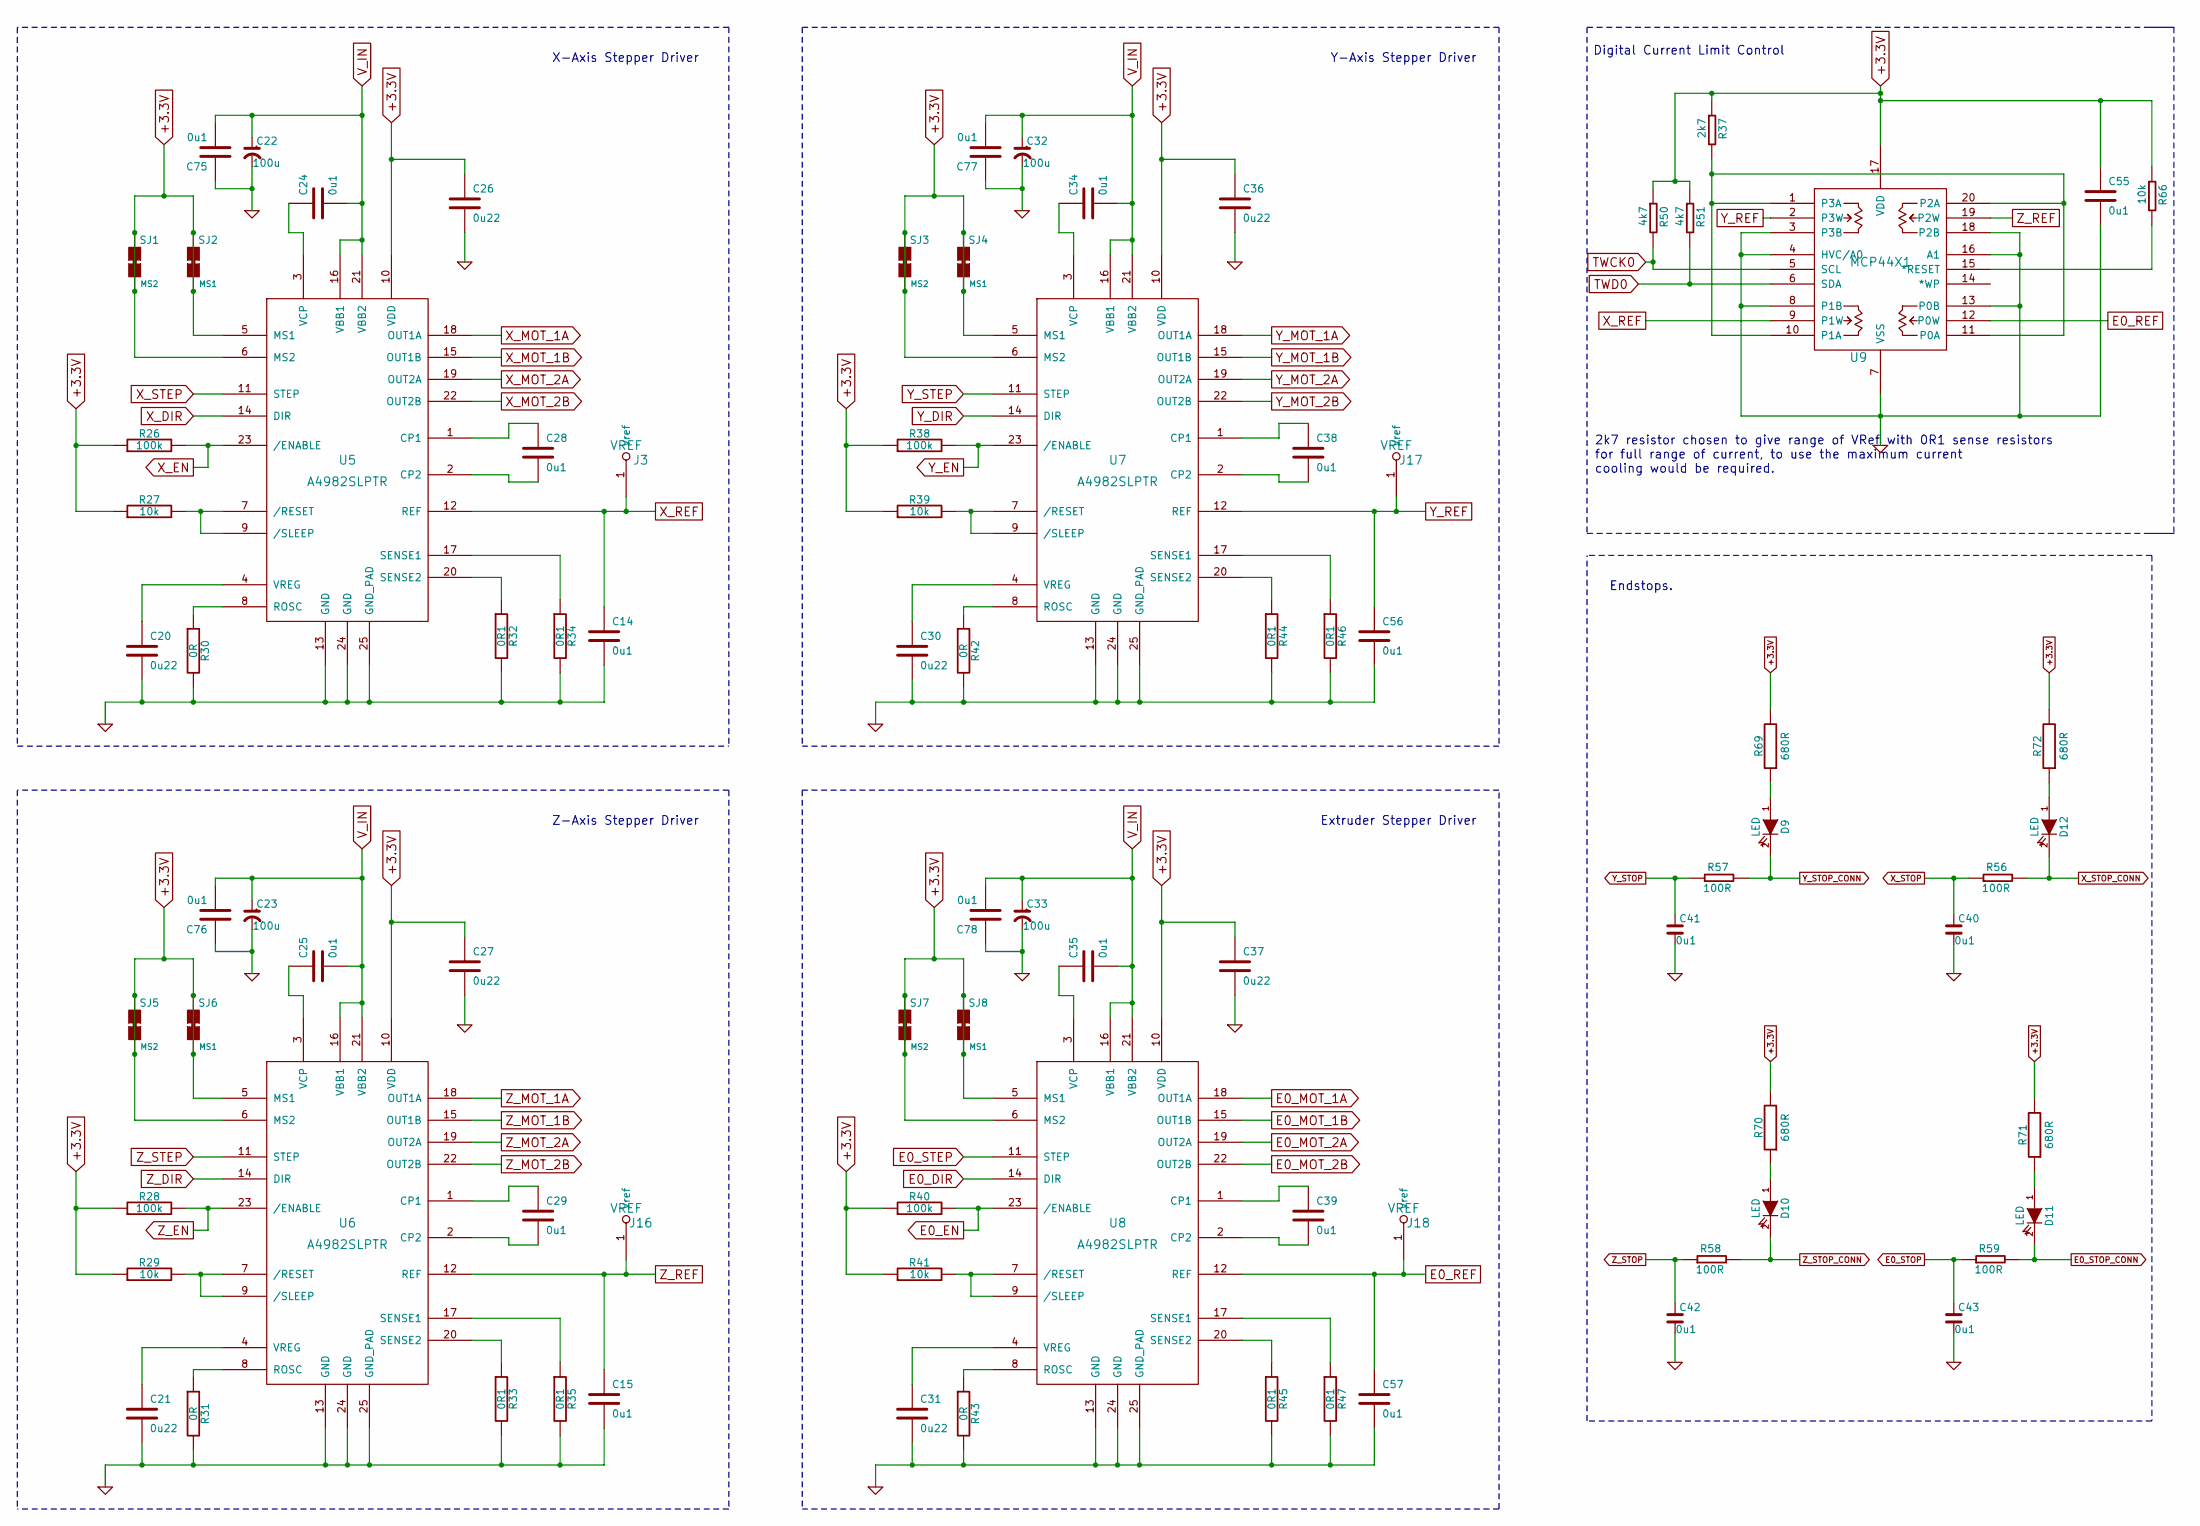
[picture p21: schematic Stepper_Drv.sch]

Parts:
C14, C15, C24, C25, C28, C29, C34, C35, C38, C40, C41, C42, C43, C55, C56, C57, C75, C76, C77, C78: 0u1
C20, C21, C26, C27, C30, C31, C36, C37: 0u22
C22, C23, C32, C33: 100u
C39: 0u1; 0603
D9, D10, D11, D12: LED
J3, J16, J17, J18: VREF
R26, R28, R40: 100k
R27, R29, R39, R41, R66: 10k
R30, R31, R42, R43: 0R
R32, R33, R34, R35, R44, R45, R46, R47: 0R1
R37: 2k7
R38: 100k; 0603
R50, R51: 4k7
R56, R57, R58, R59: 100R
R69, R70, R71, R72: 680R
SJ1, SJ3, SJ5, SJ7: MS2
SJ2, SJ4, SJ6, SJ8: MS1
U5, U6, U7, U8: A4982SLPTR
U9: MCP44X1

Connections:
+3.3V: C26.1, C27.1, C36.1, C37.1, C55.1, R26.1, R27.1, R28.1, R29.1, R37.1, R38.1, R39.1, R40.1, R41.1, R50.1, R51.1, R66.1, R69.2, R70.2, R71.2, R72.2, SJ1.1 (SJ_P1), SJ1.2 (SJ_P2), SJ2.1 (SJ_P1), SJ2.2 (SJ_P2), SJ3.1 (SJ_P1), SJ3.2 (SJ_P2), SJ4.1 (SJ_P1), SJ4.2 (SJ_P2), SJ5.1 (SJ_P1), SJ5.2 (SJ_P2), SJ6.1 (SJ_P1), SJ6.2 (SJ_P2), SJ7.1 (SJ_P1), SJ7.2 (SJ_P2), SJ8.1 (SJ_P1), SJ8.2 (SJ_P2), U5.5 (MS1), U5.6 (MS2), U5.10 (VDD), U6.5 (MS1), U6.6 (MS2), U6.10 (VDD), U7.5 (MS1), U7.6 (MS2), U7.10 (VDD), U8.5 (MS1), U8.6 (MS2), U8.10 (VDD), U9.17 (VDD)
E0_DIR: U8.14 (DIR)
E0_EN: R40.2, U8.23 (/ENABLE)
E0_MOT_1A: U8.18 (OUT1A)
E0_MOT_1B: U8.15 (OUT1B)
E0_MOT_2A: U8.19 (OUT2A)
E0_MOT_2B: U8.22 (OUT2B)
E0_REF: C57.1, J18.1, U8.12 (REF), U9.12 (P0W)
E0_STEP: U8.11 (STEP)
E0_STOP: C43.1, R59.1
E0_STOP_CONN: D11.2 (K), R59.2
GND: C14.2, C15.2, C20.2, C21.2, C22.2, C23.2, C26.2, C27.2, C30.2, C31.2, C32.2, C33.2, C36.2, C37.2, C40.2, C41.2, C42.2, C43.2, C55.2, C56.2, C57.2, C75.1, C76.1, C77.1, C78.1, R30.2, R31.2, R32.2, R33.2, R34.2, R35.2, R42.2, R43.2, R44.2, R45.2, R46.2, R47.2, U5.13 (GND), U5.24 (GND), U5.25 (GND_PAD), U6.13 (GND), U6.24 (GND), U6.25 (GND_PAD), U7.13 (GND), U7.24 (GND), U7.25 (GND_PAD), U8.13 (GND), U8.24 (GND), U8.25 (GND_PAD), U9.3 (P3B), U9.4 (HVC/A0), U9.7 (VSS), U9.8 (P1B), U9.13 (P0B), U9.16 (A1), U9.18 (P2B)
unnamed: C20.1, U5.4 (VREG)
unnamed: C21.1, U6.4 (VREG)
unnamed: C24.1, U5.3 (VCP)
unnamed: C25.1, U6.3 (VCP)
unnamed: C28.1, U5.1 (CP1)
unnamed: C28.2, U5.2 (CP2)
unnamed: C29.1, U6.1 (CP1)
unnamed: C29.2, U6.2 (CP2)
unnamed: C30.1, U7.4 (VREG)
unnamed: C31.1, U8.4 (VREG)
unnamed: C34.1, U7.3 (VCP)
unnamed: C35.1, U8.3 (VCP)
unnamed: C38.1, U7.1 (CP1)
unnamed: C38.2, U7.2 (CP2)
unnamed: C39.1, U8.1 (CP1)
unnamed: C39.2, U8.2 (CP2)
unnamed: D9.1 (A), R69.1
unnamed: D10.1 (A), R70.1
unnamed: D11.1 (A), R71.1
unnamed: D12.1 (A), R72.1
unnamed: R27.2, U5.7 (/RESET), U5.9 (/SLEEP)
unnamed: R29.2, U6.7 (/RESET), U6.9 (/SLEEP)
unnamed: R30.1, U5.8 (ROSC)
unnamed: R31.1, U6.8 (ROSC)
unnamed: R32.1, U5.20 (SENSE2)
unnamed: R33.1, U6.20 (SENSE2)
unnamed: R34.1, U5.17 (SENSE1)
unnamed: R35.1, U6.17 (SENSE1)
unnamed: R37.2, U9.1 (P3A), U9.10 (P1A), U9.11 (P0A), U9.20 (P2A)
unnamed: R39.2, U7.7 (/RESET), U7.9 (/SLEEP)
unnamed: R41.2, U8.7 (/RESET), U8.9 (/SLEEP)
unnamed: R42.1, U7.8 (ROSC)
unnamed: R43.1, U8.8 (ROSC)
unnamed: R44.1, U7.20 (SENSE2)
unnamed: R45.1, U8.20 (SENSE2)
unnamed: R46.1, U7.17 (SENSE1)
unnamed: R47.1, U8.17 (SENSE1)
unnamed: R66.2, U9.15 (*RESET)
TWCK0: R50.2, U9.5 (SCL)
TWD0: R51.2, U9.6 (SDA)
V_IN: C22.1, C23.1, C24.2, C25.2, C32.1, C33.1, C34.2, C35.2, C75.2, C76.2, C77.2, C78.2, U5.16 (VBB1), U5.21 (VBB2), U6.16 (VBB1), U6.21 (VBB2), U7.16 (VBB1), U7.21 (VBB2), U8.16 (VBB1), U8.21 (VBB2)
X_DIR: U5.14 (DIR)
X_EN: R26.2, U5.23 (/ENABLE)
X_MOT_1A: U5.18 (OUT1A)
X_MOT_1B: U5.15 (OUT1B)
X_MOT_2A: U5.19 (OUT2A)
X_MOT_2B: U5.22 (OUT2B)
X_REF: C14.1, J3.1, U5.12 (REF), U9.9 (P1W)
X_STEP: U5.11 (STEP)
X_STOP: C40.1, R56.1
X_STOP_CONN: D12.2 (K), R56.2
Y_DIR: U7.14 (DIR)
Y_EN: R38.2, U7.23 (/ENABLE)
Y_MOT_1A: U7.18 (OUT1A)
Y_MOT_1B: U7.15 (OUT1B)
Y_MOT_2A: U7.19 (OUT2A)
Y_MOT_2B: U7.22 (OUT2B)
Y_REF: C56.1, J17.1, U7.12 (REF), U9.2 (P3W)
Y_STEP: U7.11 (STEP)
Y_STOP: C41.1, R57.1
Y_STOP_CONN: D9.2 (K), R57.2
Z_DIR: U6.14 (DIR)
Z_EN: R28.2, U6.23 (/ENABLE)
Z_MOT_1A: U6.18 (OUT1A)
Z_MOT_1B: U6.15 (OUT1B)
Z_MOT_2A: U6.19 (OUT2A)
Z_MOT_2B: U6.22 (OUT2B)
Z_REF: C15.1, J16.1, U6.12 (REF), U9.19 (P2W)
Z_STEP: U6.11 (STEP)
Z_STOP: C42.1, R58.1
Z_STOP_CONN: D10.2 (K), R58.2

Notes on the sheet:
2k7 resistor chosen to give range of VRef with 0R1 sense resistors for full range of current, to use the maximum current cooling would be required.
Endstops.
Digital Current Limit Control
Z-Axis Stepper Driver
Extruder Stepper Driver
Y-Axis Stepper Driver
X-Axis Stepper Driver
