woodsmoke/Due_SB/Duet-master/Duet0.8.5/Comms.sch

## KiCad design Duet-master/Duet0.8.5/Comms.sch (2015-08-14, an earlier design)

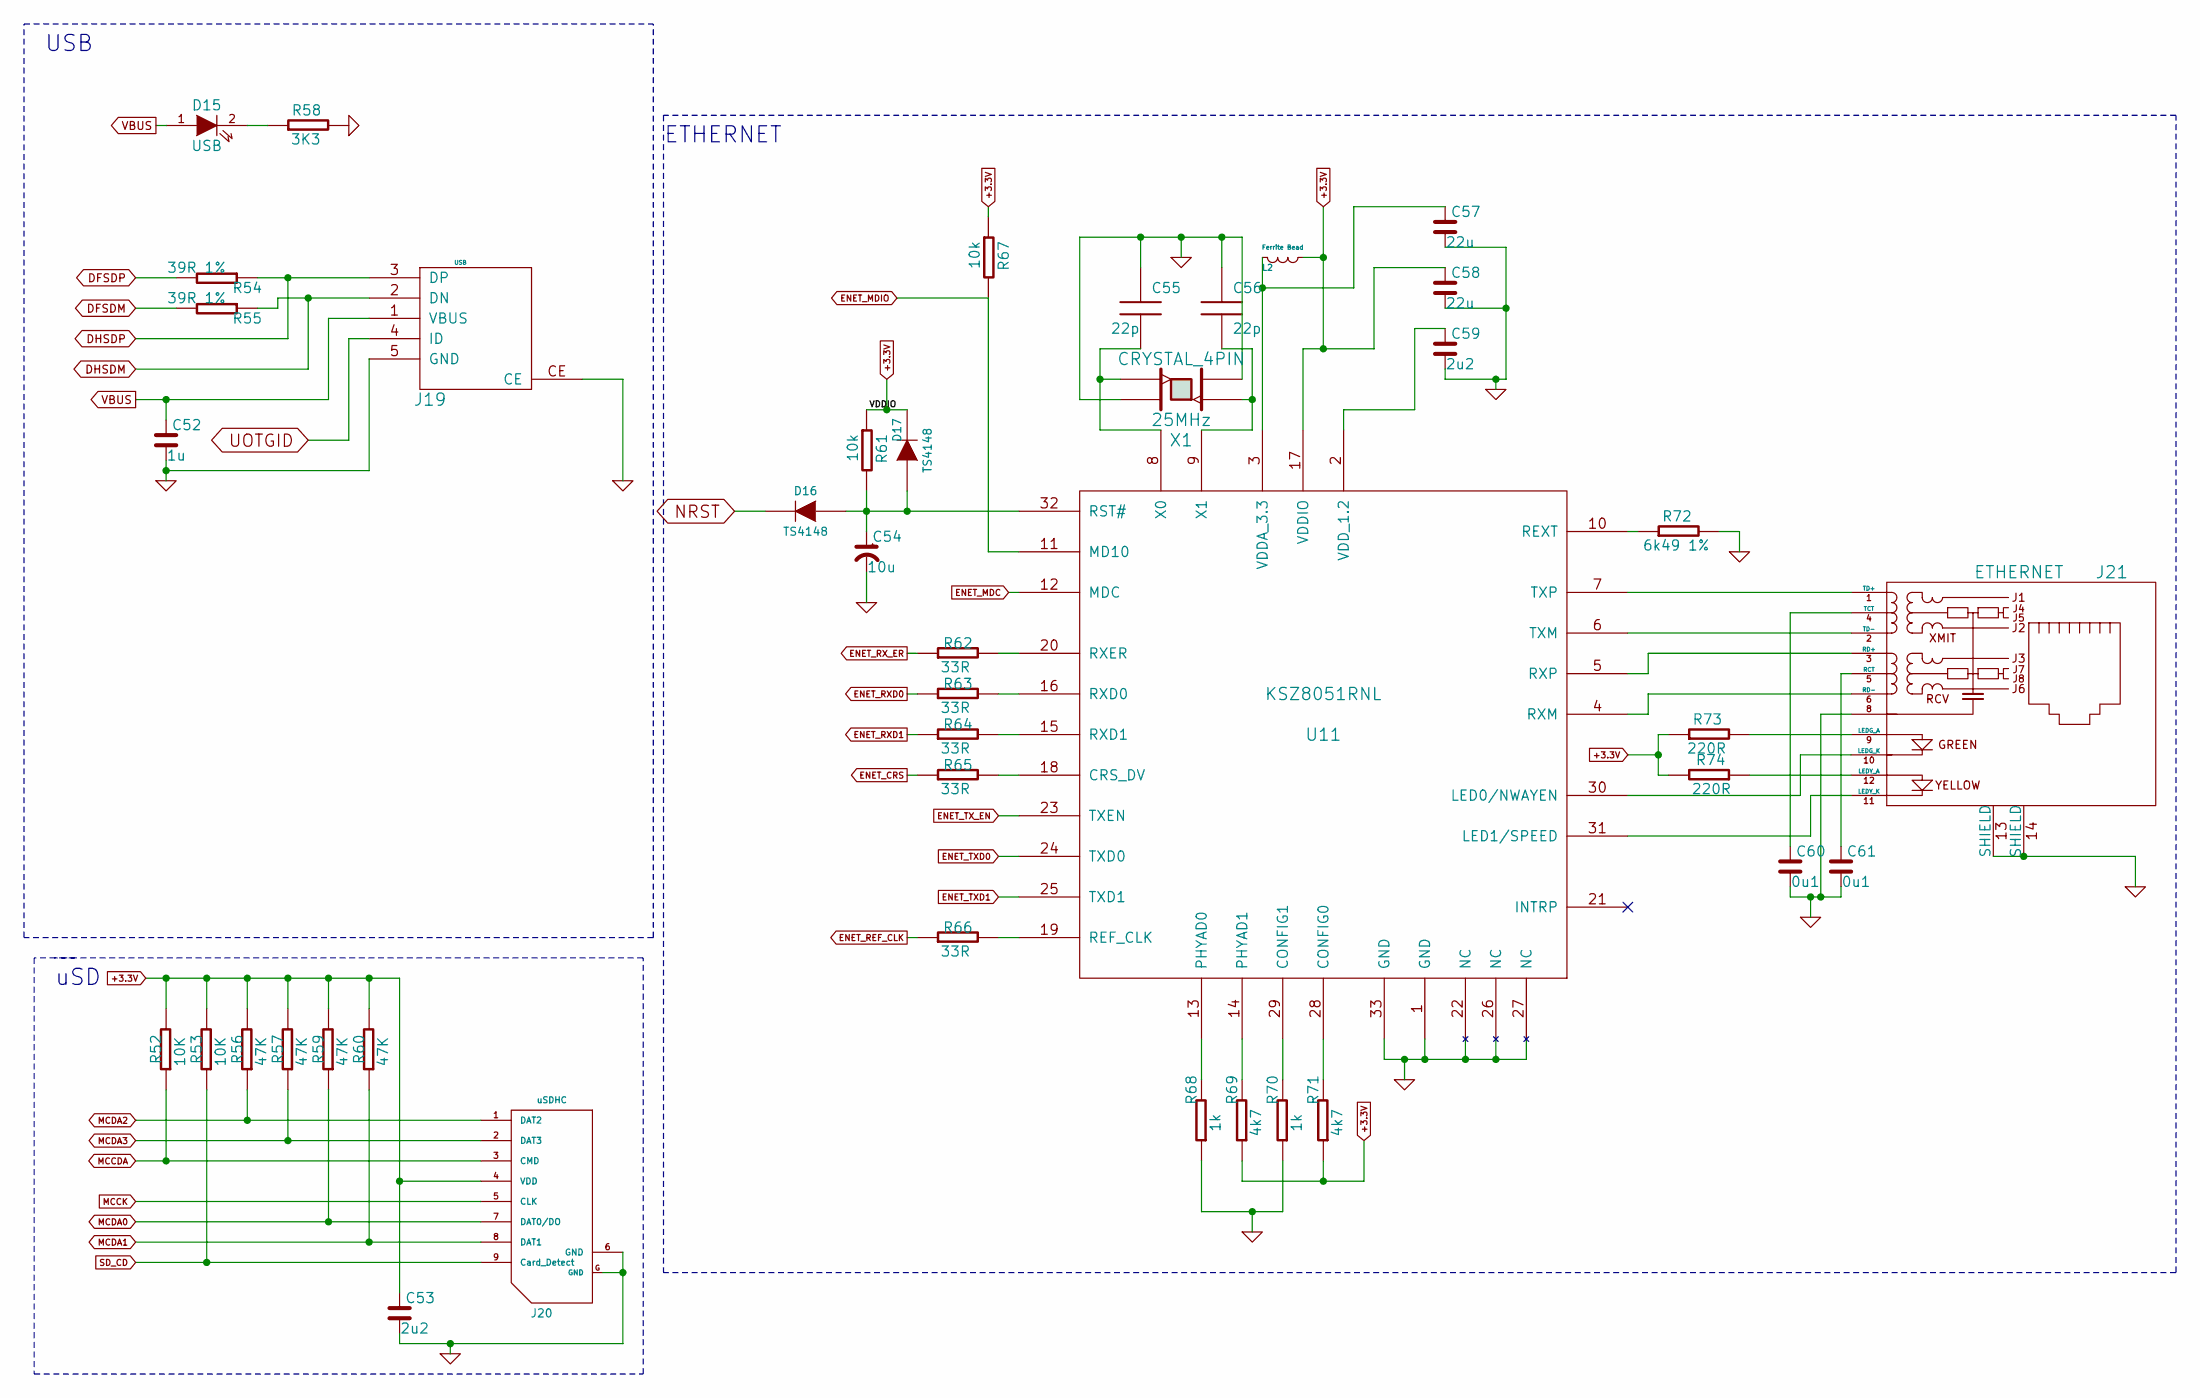
[picture p22: schematic Comms.sch]

Parts:
C52: 1u
C53, C59: 2u2
C54: 10u
C55, C56: 22p
C57, C58: 22u
C60, C61: 0u1
D15: USB
D16, D17: TS4148
J19: USB
J20: uSDHC
J21: ETHERNET
L2: Ferrite Bead; 1206
R52, R53: 10K; 0603
R54, R55: 39R 1%
R56, R57, R59, R60: 47K; 0603
R58: 3K3
R61, R67: 10k; 0603
R62, R63, R64, R65, R66: 33R; 0603
R68, R70: 1k; 0603
R69, R71: 4k7; 0603
R72: 6k49 1%; 0603
R73, R74: 220R; 0603
U11: KSZ8051RNL
X1: CRYSTAL_4PIN

Connections:
+3.3V: C53.1, C58.1, D17.1 (K), J20.4 (VDD), L2.2 (B), R52.2, R53.2, R56.2, R57.2, R59.2, R60.2, R61.1, R67.1, R69.1, R71.1, R73.1, R74.2, U11.17 (VDDIO)
DFSDM: R55.2
DFSDP: R54.2
DHSDM: J19.2 (DN), R55.1
DHSDP: J19.3 (DP), R54.1
ENET_CRS: R65.1
ENET_MDC: U11.12 (MDC)
ENET_MDIO: R67.2, U11.11 (MD10)
ENET_REF_CLK: R66.1
ENET_RXD0: R63.1
ENET_RXD1: R64.1
ENET_RX_ER: R62.1
ENET_TXD0: U11.24 (TXD0)
ENET_TXD1: U11.25 (TXD1)
ENET_TX_EN: U11.23 (TXEN)
GND: C52.2, C53.2, C54.2, C55.1, C56.1, C57.2, C58.2, C59.2, C60.2, C61.2, J19.5 (GND), J19.CE, J20.6 (GND), J20.G (GND), J21.8, J21.13 (SHIELD), J21.14 (SHIELD), R58.2, R68.1, R70.1, R72.2, U11.1 (GND), U11.22 (NC), U11.26 (NC), U11.27 (NC), U11.33 (GND), X1.2, X1.4
MCCDA: J20.3 (CMD), R52.1
MCCK: J20.5 (CLK)
MCDA0: J20.7 (DAT0/DO), R59.1
MCDA1: J20.8 (DAT1), R60.1
MCDA2: J20.1 (DAT2), R56.1
MCDA3: J20.2 (DAT3), R57.1
NRST: D16.1 (K)
unnamed: C54.1, D16.2 (A), D17.2 (A), R61.2, U11.32 (RST#)
unnamed: C55.2, U11.8 (X0), X1.3
unnamed: C56.2, U11.9 (X1), X1.1
unnamed: C57.1, L2.1 (A), U11.3 (VDDA_3.3)
unnamed: C59.1, U11.2 (VDD_1.2)
unnamed: C60.1, J21.4 (TCT)
unnamed: C61.1, J21.5 (RCT)
unnamed: D15.2 (K), R58.1
unnamed: J21.1 (TD+), U11.7 (TXP)
unnamed: J21.2 (TD-), U11.6 (TXM)
unnamed: J21.3 (RD+), U11.5 (RXP)
unnamed: J21.6 (RD-), U11.4 (RXM)
unnamed: J21.9 (LEDG_A), R73.2
unnamed: J21.10 (LEDG_K), U11.30 (LED0/NWAYEN)
unnamed: J21.11 (LEDY_K), U11.31 (LED1/SPEED)
unnamed: J21.12 (LEDY_A), R74.1
unnamed: R62.2, U11.20 (RXER)
unnamed: R63.2, U11.16 (RXD0)
unnamed: R64.2, U11.15 (RXD1)
unnamed: R65.2, U11.18 (CRS_DV)
unnamed: R66.2, U11.19 (REF_CLK)
unnamed: R68.2, U11.13 (PHYAD0)
unnamed: R69.2, U11.14 (PHYAD1)
unnamed: R70.2, U11.29 (CONFIG1)
unnamed: R71.2, U11.28 (CONFIG0)
unnamed: R72.1, U11.10 (REXT)
SD_CD: J20.9 (Card_Detect), R53.1
UOTGID: J19.4 (ID)
VBUS: C52.1, D15.1 (A), J19.1 (VBUS)

Notes on the sheet:
uSD
ETHERNET
USB
