woodsmoke/Due_SB/Duet-master/Duet0.8.5/Headers.sch

## KiCad design Duet-master/Duet0.8.5/Headers.sch (2015-08-21, an earlier design)

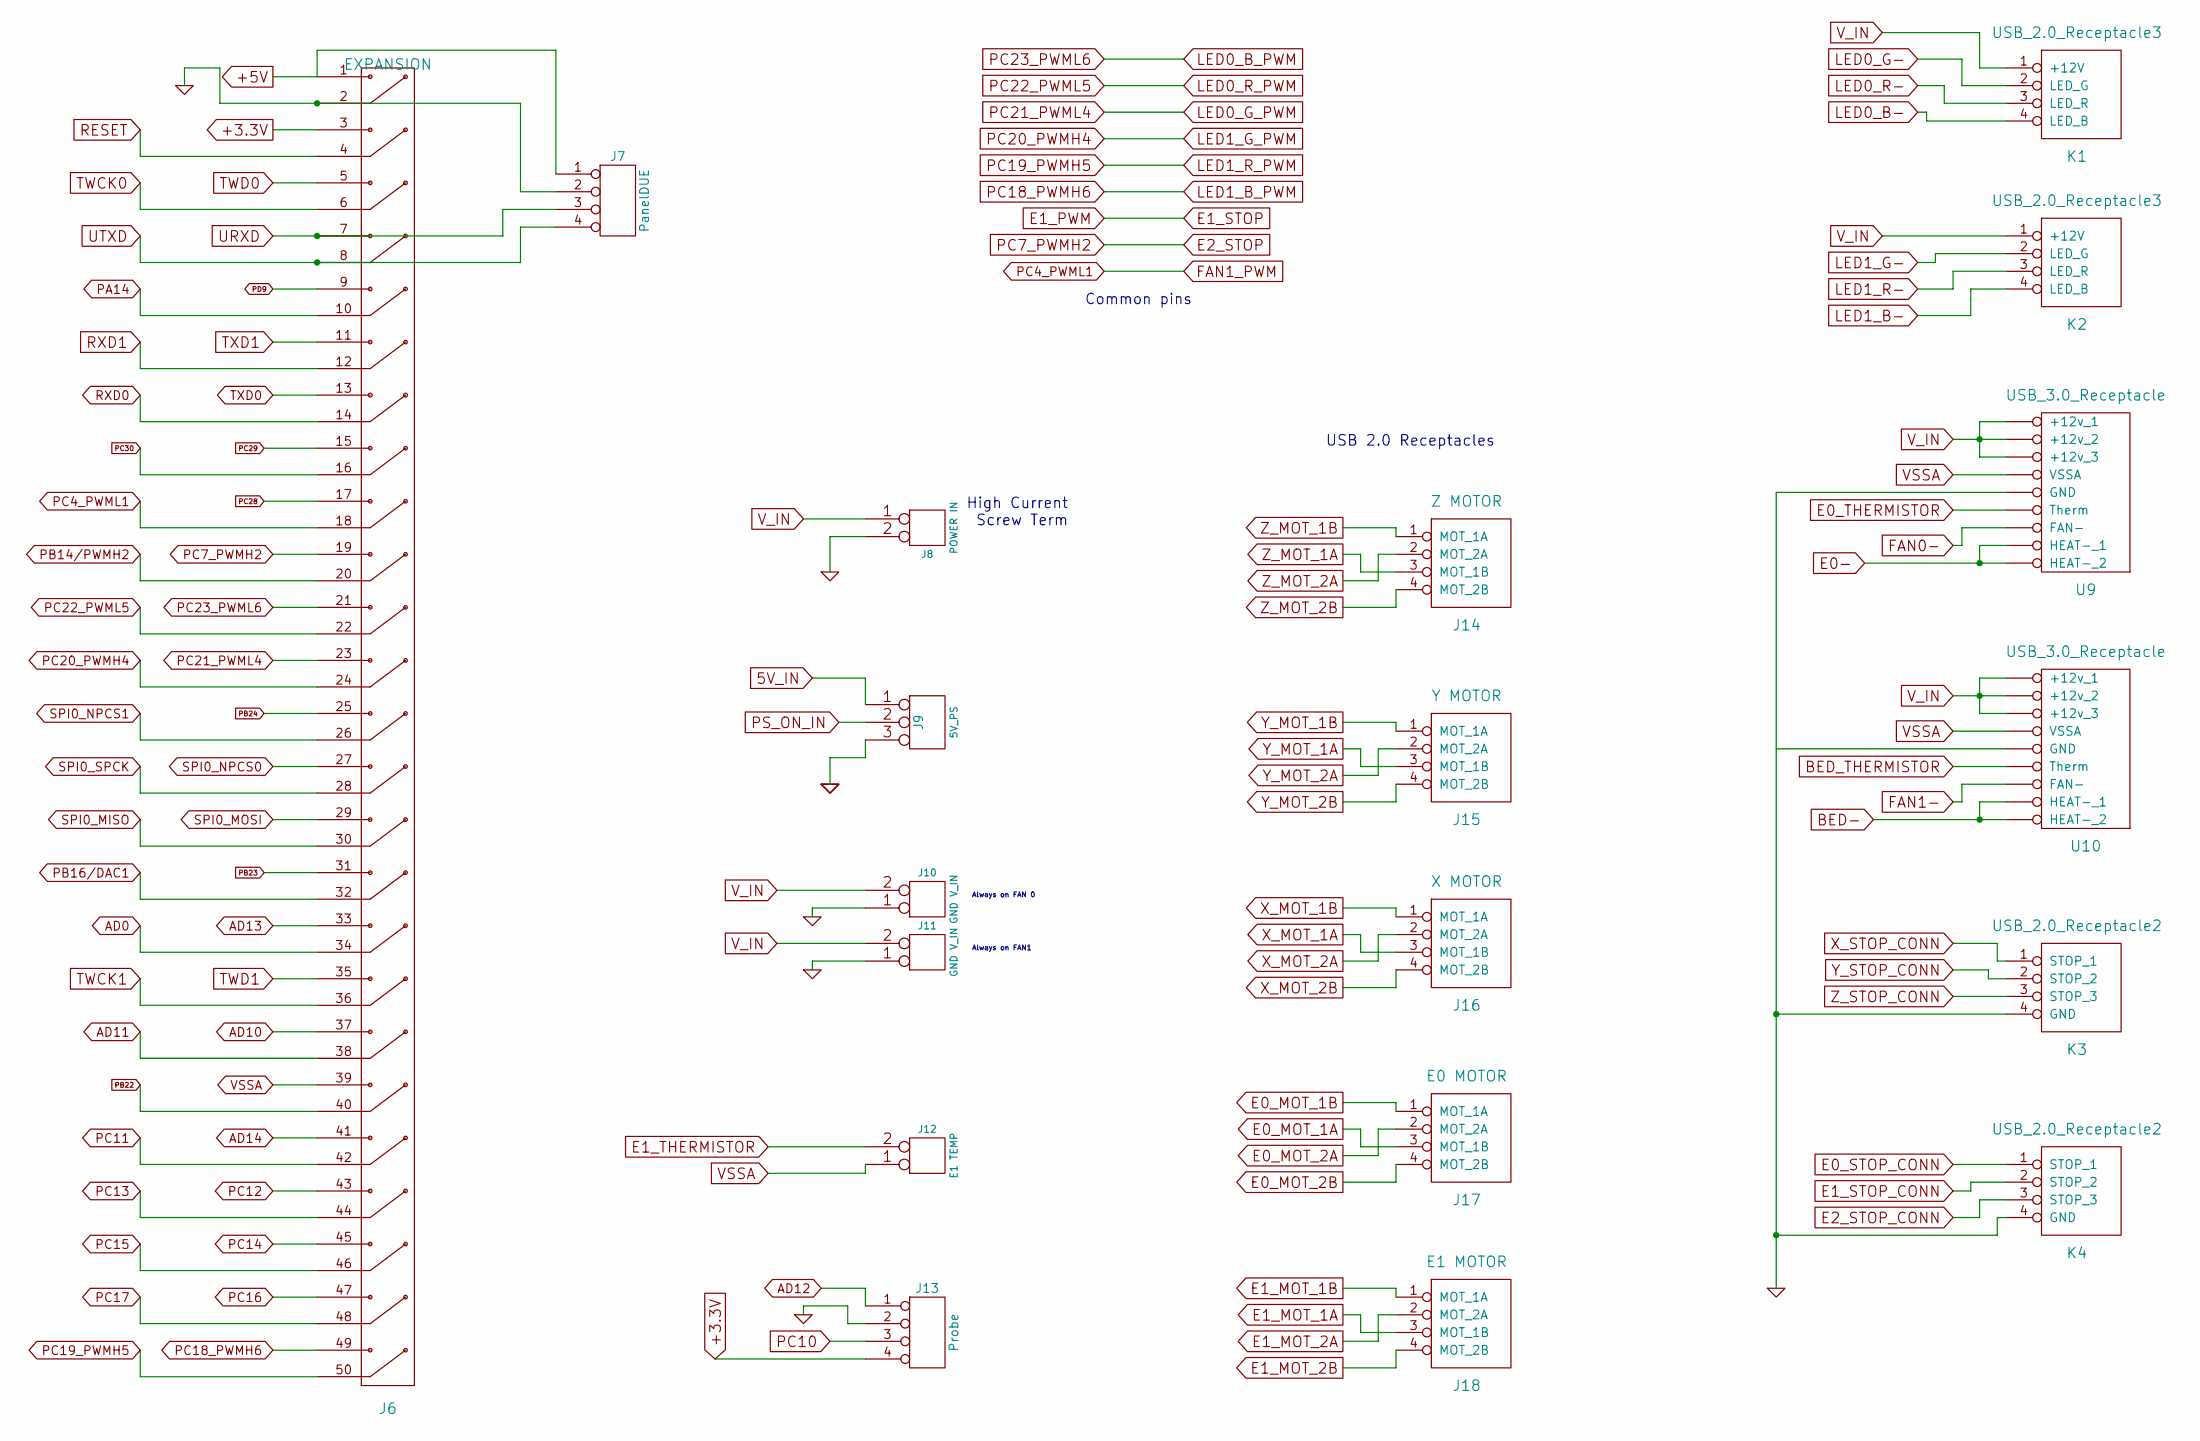
[picture p23: schematic Headers.sch]

Parts:
J6: EXPANSION
J7: PanelDUE
J8: POWER IN
J9: 5V_PS
J10, J11: GND V_IN
J12: E1 TEMP
J13: Probe
J14: Z MOTOR
J15: Y MOTOR
J16: X MOTOR
J17: E0 MOTOR
J18: E1 MOTOR
K1, K2: USB_2.0_Receptacle3
K3, K4: USB_2.0_Receptacle2
U9, U10: USB_3.0_Receptacle

Connections:
5V_IN: J9.1
+3.3V: J6.3, J13.4
+5V: J6.1, J7.1
AD0: J6.34
AD10: J6.37
AD11: J6.38
AD12: J13.1
AD13: J6.33
AD14: J6.41
BED-: U10.~
BED_THERMISTOR: U10.~
E0-: U9.~
E0_MOT_1A: J17.3 (MOT_1B)
E0_MOT_1B: J17.1 (MOT_1A)
E0_MOT_2A: J17.2 (MOT_2A)
E0_MOT_2B: J17.4 (MOT_2B)
E0_STOP_CONN: K4.1 (STOP_1)
E0_THERMISTOR: U9.~
E1_MOT_1A: J18.3 (MOT_1B)
E1_MOT_1B: J18.1 (MOT_1A)
E1_MOT_2A: J18.2 (MOT_2A)
E1_MOT_2B: J18.4 (MOT_2B)
E1_STOP_CONN: K4.2 (STOP_2)
E1_THERMISTOR: J12.2 (PM)
E2_STOP: J6.19
E2_STOP_CONN: K4.3 (STOP_3)
FAN0-: U9.~
FAN1-: U10.~
FAN1_PWM: J6.18
GND: J6.2, J7.2, J8.2 (PM), J9.3, J10.1, J11.1, J13.2, K3.4 (GND), K4.4 (GND), U9.~
LED0_B-: K1.4 (LED_B)
LED0_B_PWM: J6.21
LED0_G-: K1.2 (LED_G)
LED0_G_PWM: J6.23
LED0_R-: K1.3 (LED_R)
LED0_R_PWM: J6.22
LED1_B-: K2.4 (LED_B)
LED1_B_PWM: J6.49
LED1_G-: K2.2 (LED_G)
LED1_G_PWM: J6.24
LED1_R-: K2.3 (LED_R)
LED1_R_PWM: J6.50
PA14: J6.10
PB14/PWMH2: J6.20
PB16/DAC1: J6.32
PB22: J6.40
PB23: J6.31
PB24: J6.25
PC10: J13.3
PC11: J6.42
PC12: J6.43
PC13: J6.44
PC14: J6.45
PC15: J6.46
PC16: J6.47
PC17: J6.48
PC28: J6.17
PC29: J6.15
PC30: J6.16
PD9: J6.9
PS_ON_IN: J9.2 (PM)
RESET: J6.4
RXD0: J6.14
RXD1: J6.12
SPI0_MISO: J6.30
SPI0_MOSI: J6.29
SPI0_NPCS0: J6.27
SPI0_NPCS1: J6.26
SPI0_SPCK: J6.28
TWCK0: J6.6
TWCK1: J6.36
TWD0: J6.5
TWD1: J6.35
TXD0: J6.13
TXD1: J6.11
URXD: J6.7, J7.3
UTXD: J6.8, J7.4
VSSA: J6.39, J12.1, U9.~, U10.~
V_IN: J8.1, J10.2 (PM), J11.2 (PM), K1.1 (+12V), K2.1 (+12V), U9.~, U10.~
X_MOT_1A: J16.3 (MOT_1B)
X_MOT_1B: J16.1 (MOT_1A)
X_MOT_2A: J16.2 (MOT_2A)
X_MOT_2B: J16.4 (MOT_2B)
X_STOP_CONN: K3.1 (STOP_1)
Y_MOT_1A: J15.3 (MOT_1B)
Y_MOT_1B: J15.1 (MOT_1A)
Y_MOT_2A: J15.2 (MOT_2A)
Y_MOT_2B: J15.4 (MOT_2B)
Y_STOP_CONN: K3.2 (STOP_2)
Z_MOT_1A: J14.3 (MOT_1B)
Z_MOT_1B: J14.1 (MOT_1A)
Z_MOT_2A: J14.2 (MOT_2A)
Z_MOT_2B: J14.4 (MOT_2B)
Z_STOP_CONN: K3.3 (STOP_3)

Notes on the sheet:
High Current Screw Term
Always on FAN 0
Common pins
Always on FAN1
USB 2.0 Receptacles
