woodsmoke/Due_SB/Duet-master/Duet0.8.5/Htr_Fan.sch

## KiCad design Duet-master/Duet0.8.5/Htr_Fan.sch (2015-08-12, an earlier design)


Parts:
C62, C63, C68: 10u
C64, C65: 0u1
C66, C67: 100u
D18: Bed Heat
D19: E0 Heat
D20: LED0_G
D21: LED1_G
D22: LED0_R
D23: LED1_R
D24: LED0_B
D25: LED1_B
D26: FAN0
D27: FAN1
J22: GND
R75, R76: 100k
R77, R78: 470R
R79, R84, R85: 4K7
R80, R81: 220R
R82, R83, R88, R89, R92, R93, R96, R97, R100, R101: 4k7
R86, R87, R90, R91, R94, R95, R98, R99: 10K
TR2, TR3: BSH105
TR4, TR5: IPD036N04L
TR6, TR7, TR8, TR9, TR10, TR11, TR12, TR13: PMV40UN2

Connections:
+3.3V: R75.2, R76.2, R79.1, R84.1, R85.1
+5V: R77.1, R78.1
BED-: D18.2 (K), TR4.D
BED_PWM: R75.1, TR2.G
BED_THERMISTOR: C68.1, R85.2
E0-: D19.2 (K), TR5.D
E0_PWM: R76.1, TR3.G
E0_THERMISTOR: C63.1, R84.2
E1_THERMISTOR: C62.1, R79.2
FAN0-: D26.2 (K), TR12.D
FAN0_PWM: R98.1, TR12.G
FAN1-: D27.2 (K), TR13.D
FAN1_PWM: R99.1, TR13.G
GND: C64.2, C65.2, C66.2, C67.2, J22.1, R86.2, R87.2, R90.2, R91.2, R94.2, R95.2, R98.2, R99.2, TR2.S, TR3.S, TR4.S, TR5.S, TR6.S, TR7.S, TR8.S, TR9.S, TR10.S, TR11.S, TR12.S, TR13.S
LED0_B-: D24.2 (K), TR10.D
LED0_B_PWM: R94.1, TR10.G
LED0_G-: D20.2 (K), TR6.D
LED0_G_PWM: R86.1, TR6.G
LED0_R-: D22.2 (K), TR8.D
LED0_R_PWM: R90.1, TR8.G
LED1_B-: D25.2 (K), TR11.D
LED1_B_PWM: R95.1, TR11.G
LED1_G-: D21.2 (K), TR7.D
LED1_G_PWM: R87.1, TR7.G
LED1_R-: D23.2 (K), TR9.D
LED1_R_PWM: R91.1, TR9.G
unnamed: D18.1 (A), R82.1
unnamed: D19.1 (A), R83.1
unnamed: D20.1 (A), R88.1
unnamed: D21.1 (A), R89.1
unnamed: D22.1 (A), R92.1
unnamed: D23.1 (A), R93.1
unnamed: D24.1 (A), R96.1
unnamed: D25.1 (A), R97.1
unnamed: D26.1 (A), R100.1
unnamed: D27.1 (A), R101.1
unnamed: R77.2, R80.1, TR2.D
unnamed: R78.2, R81.1, TR3.D
unnamed: R80.2, TR4.G
unnamed: R81.2, TR5.G
VSSA: C62.2, C63.2, C68.2
V_IN: C64.1, C65.1, C66.1, C67.1, R82.2, R83.2, R88.2, R89.2, R92.2, R93.2, R96.2, R97.2, R100.2, R101.2

Notes on the sheet:
Returned to 4.7K resistors due to lower noise at low tempertures causing false open circuit errors
THERMISTOR INPUTS
FAN 0 MOSFET CONTROL
E0 MOSFET CONTROL
BED MOSFET CONTROL
FAN 1 MOSFET CONTROL
FAN 1 PWM is commoned with E5? PWM on the expansion connector - If you need 5 extruders you can't have a second hardware PWM FAN
RED LED 0 MOSFET CONTROL
GREEN LED 0 MOSFET CONTROL
BLUE LED 0 MOSFET CONTROL
RED LED 1 MOSFET CONTROL
GREEN LED 1 MOSFET CONTROL
BLUE LED 1 MOSFET CONTROL
