woodsmoke/Due_SB/Duet-master/Duet0.8.5/Power.sch

## KiCad design Duet-master/Duet0.8.5/Power.sch (2015-08-12, an earlier design)


Parts:
C43: 1u
C44: 2u2; Voltage 35V
C45: 100u; C_ELEC_6.3x7.7; Voltage 35V
C46: 0u1
C47, C49, C50: 10u
C48: 22nF
C51: 100u; C_ELEC_6.3x7.7; Voltage 10V
D8, D9: SS3P4
D10: VIN
D11: 5V+
D12: 3.3V
D13, D14: SS14M
JP1: 5V_EN
JP2: ATX_5V_EN
L1: 10uH
R43: 100K
R44, R45: 0R1
R46: 2k7
R47: 4k7
R48: 2K15
R49: 3K92
R50: 750R
R51: 470R
TR1: BSH105
U7: TC2117-3.3VDBTR
U8: A4403

Connections:
5V_IN: D14.1 (A)
+3.3V: C47.1, D12.1 (A), U7.2 (OUT), U7.4 (OUT)
+5V: C43.1, C49.1, C50.1, C51.1, D11.1 (A), D13.2 (K), JP2.1, L1.1 (A), R49.2, U7.3 (IN)
GND: C43.2, C44.2, C45.2, C46.2, C47.2, C49.2, C50.2, C51.2, JP1.1, R44.1, R45.1, R46.2, R47.2, R48.2, R50.1, R51.2, TR1.S, U7.1 (GND), U8.2 (NC), U8.6 (GND), U8.7 (NC), U8.9 (SGND), U8.13 (NC), U8.14 (NC), U8.15 (NC), U8.16 (NC), U8.17 (PAD)
unnamed: C44.1, C45.1, D8.2 (K), R43.1, U8.1 (Vin)
unnamed: C46.1, U8.4 (SS)
unnamed: C48.1, U8.11 (BOOT)
unnamed: C48.2, D9.2 (K), L1.2 (B), U8.12 (LX)
unnamed: D9.1 (A), R44.2, R45.2, U8.8 (Isen)
unnamed: D10.2 (K), R47.1
unnamed: D11.2 (K), R48.1
unnamed: D12.2 (K), R51.1
unnamed: D14.2 (K), JP2.2
unnamed: JP1.2, U8.10 (DIS)
unnamed: R43.2, U8.3 (Ton)
unnamed: R49.1, R50.2, U8.5 (FB)
PS_ON_CONTROL: R46.1, TR1.G
PS_ON_IN: TR1.D
VBUS: D13.1 (A)
V_IN: D8.1 (A), D10.1 (A)

Notes on the sheet:
PS_ON Control
up to 1A
this design allows
at least 780mA
ATX Spec advises
by the USB specification
VBUS limited to 500mA
5V Input, 3.3V 500mA Output Low Drop-Out Linear Regulator
12-24V Input, 5V 1A Output PWM Buck Converter
2k7 v7
220R v7
v0.7=220R
Resistors R85 and R86 should be surface mount, low inductance type, rated at 250 mW at 70°C Possibly use 0R2 IOT limit current to 1A
C5 sets the soft start time. Any value between 20nf and 100nf is fine if C97 and C98 total 20uF
Power LEDs
Must be able to handle 24V
Blue
Red
Green
