woodsmoke/Due_SB/Duet-master/Duet0.8.5/Processor.sch

## KiCad design Duet-master/Duet0.8.5/Processor.sch (2015-08-18, an earlier design)

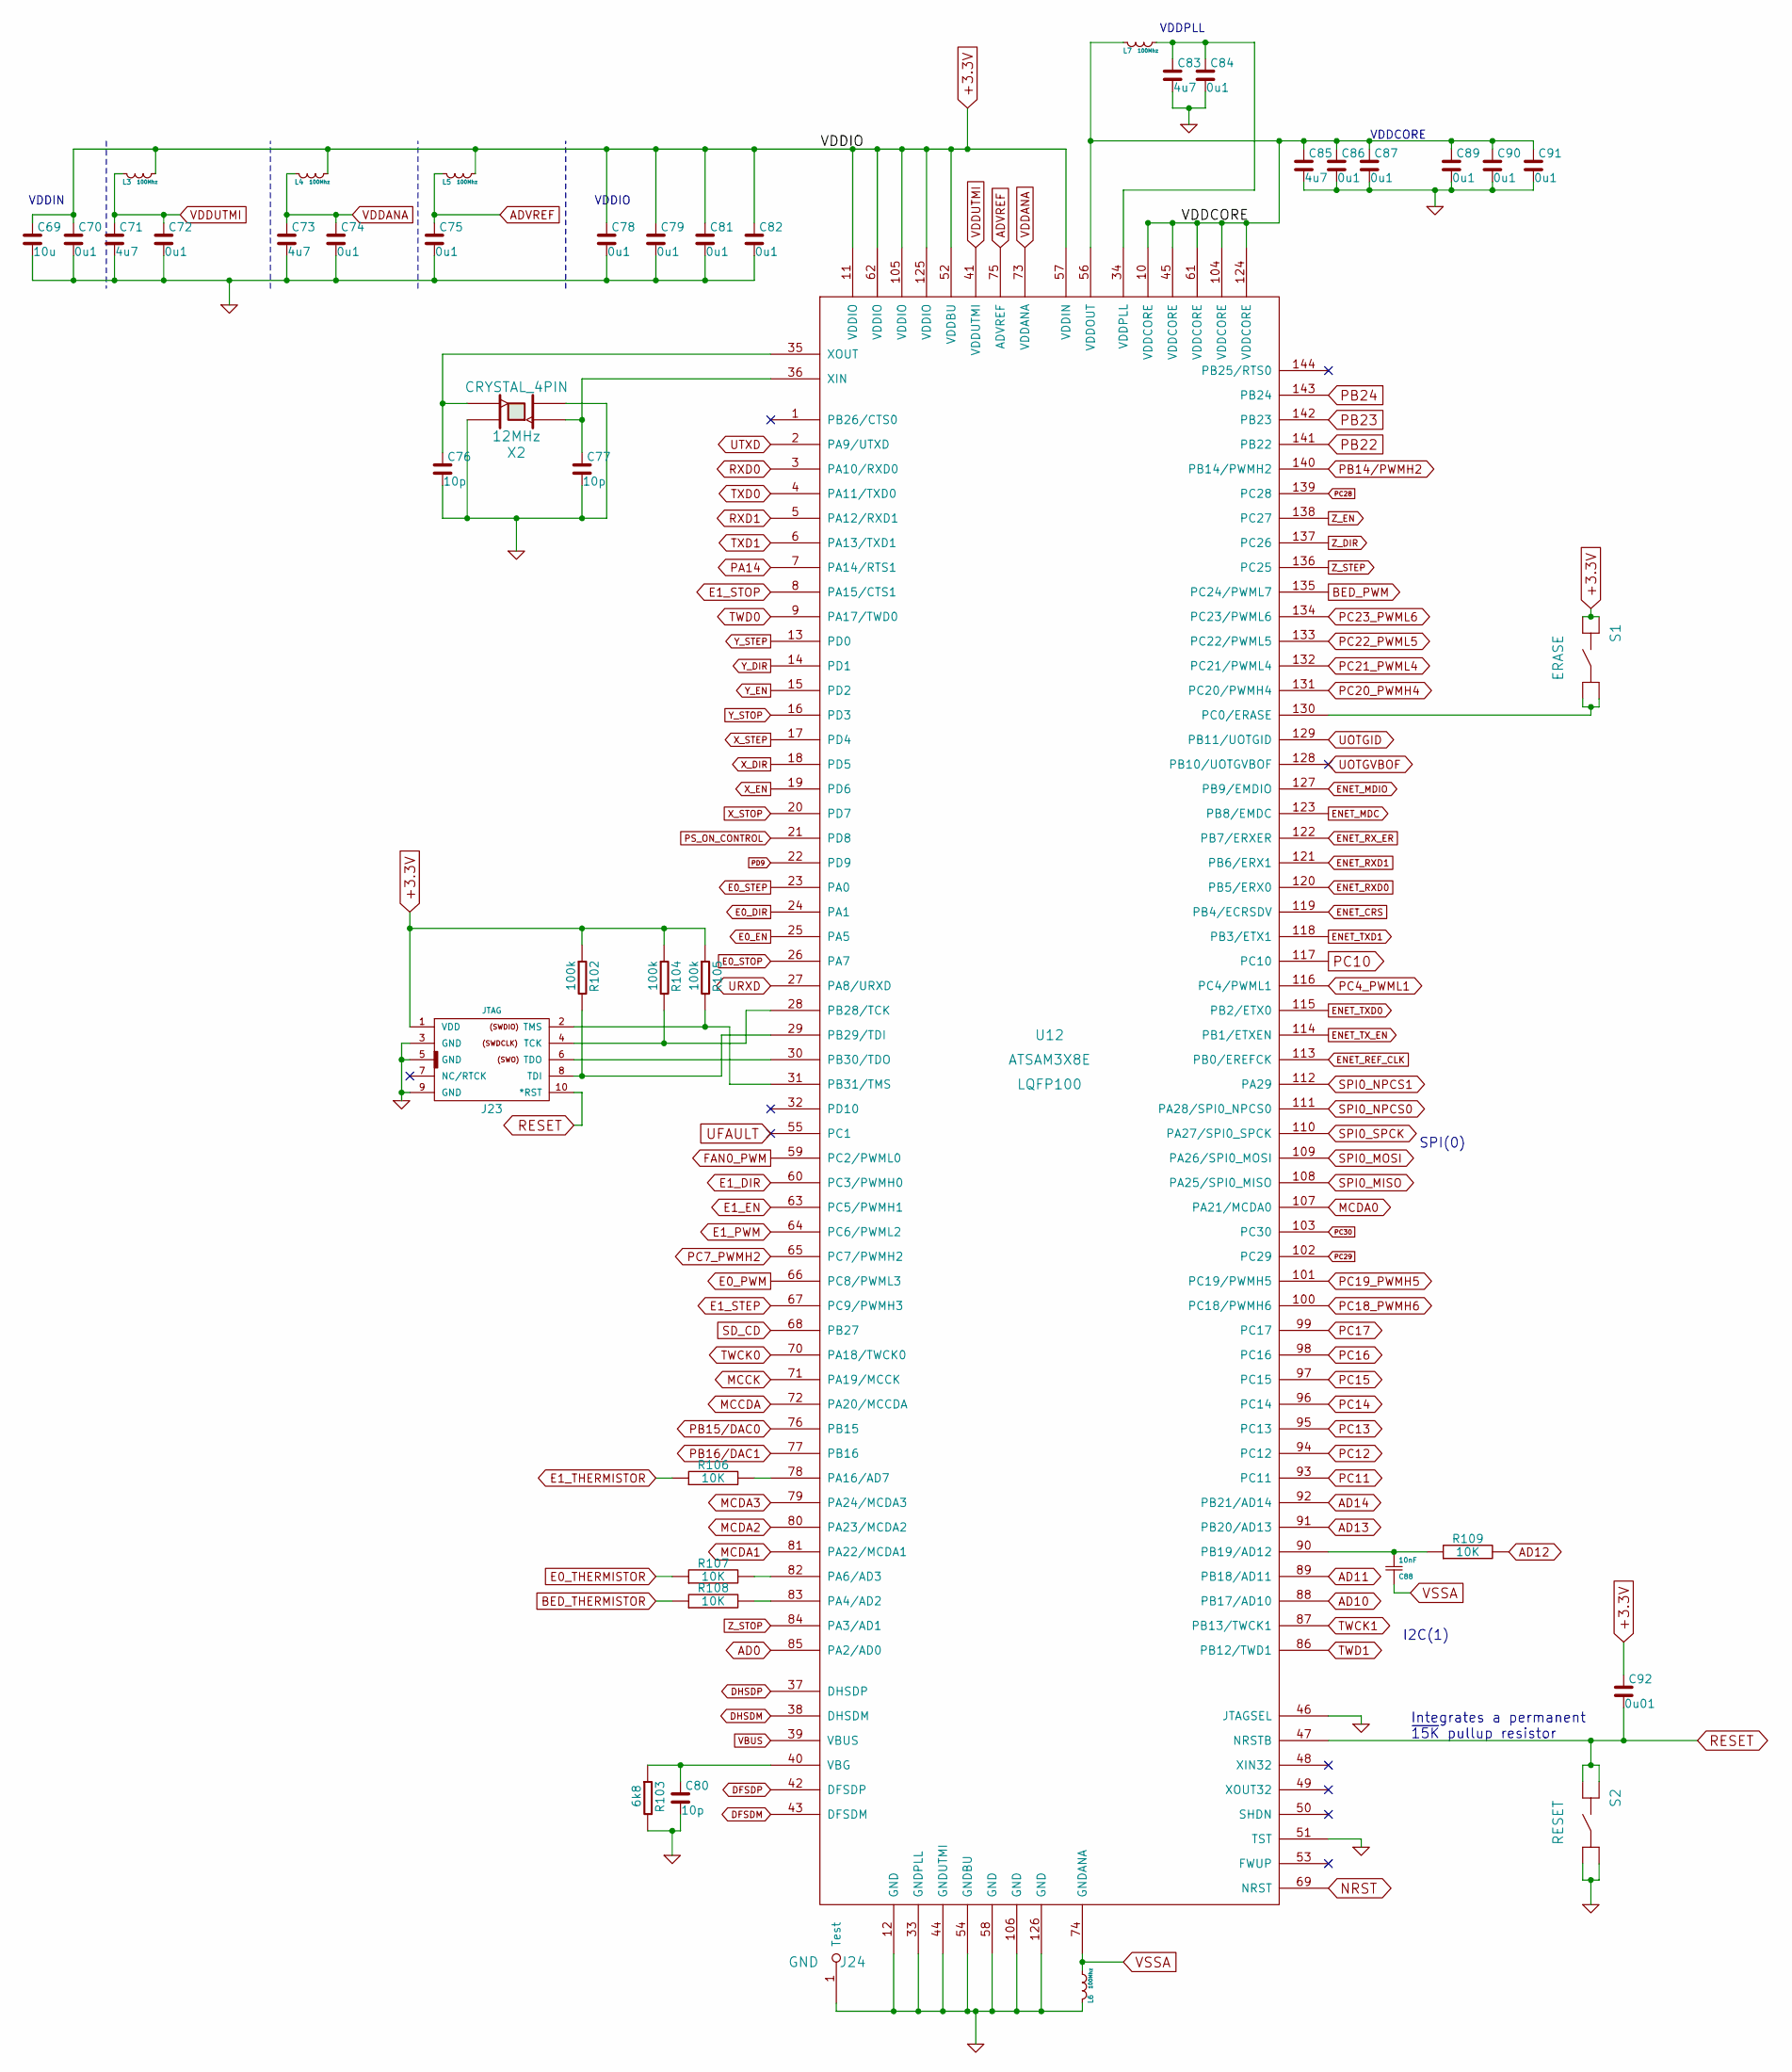
[picture p24: schematic Processor.sch]

Parts:
C69: 10u
C70, C72, C74, C75, C78, C79, C81, C82, C84, C86, C87, C89, C90, C91: 0u1
C71, C73, C83, C85: 4u7
C76, C77, C80: 10p
C88: 10nF
C92: 0u01
J23: JTAG
J24: GND
L3, L4, L5, L6, L7: 100Mhz
R102, R104, R105: 100k
R103: 6k8
R106, R107, R108, R109: 10K
S1: ERASE
S2: RESET
U12: ATSAM3X8E; LQFP100
X2: CRYSTAL_4PIN

Connections:
+3.3V: C69.1, C70.1, C78.1, C79.1, C81.1, C82.1, C92.1, J23.1 (VDD), L3.2 (B), L4.2 (B), L5.2 (B), R102.1, R104.1, R105.1, S1.3, S1.4, U12.11 (VDDIO), U12.52 (VDDBU), U12.57 (VDDIN), U12.62 (VDDIO), U12.105 (VDDIO), U12.125 (VDDIO)
AD0: U12.85 (PA2/AD0)
AD10: U12.88 (PB17/AD10)
AD11: U12.89 (PB18/AD11)
AD12: R109.2
AD13: U12.91 (PB20/AD13)
AD14: U12.92 (PB21/AD14)
ADVREF: C75.1, L5.1 (A), U12.75 (ADVREF)
BED_PWM: U12.135 (PC24/PWML7)
BED_THERMISTOR: R108.1
DFSDM: U12.43 (DFSDM)
DFSDP: U12.42 (DFSDP)
DHSDM: U12.38 (DHSDM)
DHSDP: U12.37 (DHSDP)
E0_DIR: U12.24 (PA1)
E0_EN: U12.25 (PA5)
E0_PWM: U12.66 (PC8/PWML3)
E0_STEP: U12.23 (PA0)
E0_STOP: U12.26 (PA7)
E0_THERMISTOR: R107.1
E1_DIR: U12.60 (PC3/PWMH0)
E1_EN: U12.63 (PC5/PWMH1)
E1_PWM: U12.64 (PC6/PWML2)
E1_STEP: U12.67 (PC9/PWMH3)
E1_STOP: U12.8 (PA15/CTS1)
E1_THERMISTOR: R106.1
ENET_CRS: U12.119 (PB4/ECRSDV)
ENET_MDC: U12.123 (PB8/EMDC)
ENET_MDIO: U12.127 (PB9/EMDIO)
ENET_REF_CLK: U12.113 (PB0/EREFCK)
ENET_RXD0: U12.120 (PB5/ERX0)
ENET_RXD1: U12.121 (PB6/ERX1)
ENET_RX_ER: U12.122 (PB7/ERXER)
ENET_TXD0: U12.115 (PB2/ETX0)
ENET_TXD1: U12.118 (PB3/ETX1)
ENET_TX_EN: U12.114 (PB1/ETXEN)
FAN0_PWM: U12.59 (PC2/PWML0)
GND: C69.2, C70.2, C71.2, C72.2, C73.2, C74.2, C75.2, C76.2, C77.2, C78.2, C79.2, C80.2, C81.2, C82.2, C83.2, C84.2, C85.2, C86.2, C87.2, C89.2, C90.2, C91.2, J23.3 (GND), J23.5 (GND), J23.9 (GND), J24.1, L6.1 (A), R103.2, S2.1, S2.2, U12.12 (GND), U12.33 (GNDPLL), U12.44 (GNDUTMI), U12.46 (JTAGSEL), U12.51 (TST), U12.54 (GNDBU), U12.58 (GND), U12.106 (GND), U12.126 (GND), X2.2, X2.4
MCCDA: U12.72 (PA20/MCCDA)
MCCK: U12.71 (PA19/MCCK)
MCDA0: U12.107 (PA21/MCDA0)
MCDA1: U12.81 (PA22/MCDA1)
MCDA2: U12.80 (PA23/MCDA2)
MCDA3: U12.79 (PA24/MCDA3)
NRST: U12.69 (NRST)
unnamed: C76.1, U12.35 (XOUT), X2.3
unnamed: C77.1, U12.36 (XIN), X2.1
unnamed: C80.1, R103.1, U12.40 (VBG)
unnamed: C83.1, C84.1, L7.2 (B), U12.34 (VDDPLL)
unnamed: C88.2, R109.1, U12.90 (PB19/AD12)
unnamed: J23.2 (TMS), R105.2, U12.31 (PB31/TMS)
unnamed: J23.4 (TCK), R104.2, U12.28 (PB28/TCK)
unnamed: J23.6 (TDO), U12.30 (PB30/TDO)
unnamed: J23.8 (TDI), R102.2, U12.29 (PB29/TDI)
unnamed: R106.2, U12.78 (PA16/AD7)
unnamed: R107.2, U12.82 (PA6/AD3)
unnamed: R108.2, U12.83 (PA4/AD2)
unnamed: S1.1, S1.2, U12.130 (PC0/ERASE)
PA14: U12.7 (PA14/RTS1)
PB14/PWMH2: U12.140 (PB14/PWMH2)
PB15/DAC0: U12.76 (PB15)
PB16/DAC1: U12.77 (PB16)
PB22: U12.141 (PB22)
PB23: U12.142 (PB23)
PB24: U12.143 (PB24)
PC4_PWML1: U12.116 (PC4/PWML1)
PC7_PWMH2: U12.65 (PC7/PWMH2)
PC10: U12.117 (PC10)
PC11: U12.93 (PC11)
PC12: U12.94 (PC12)
PC13: U12.95 (PC13)
PC14: U12.96 (PC14)
PC15: U12.97 (PC15)
PC16: U12.98 (PC16)
PC17: U12.99 (PC17)
PC18_PWMH6: U12.100 (PC18/PWMH6)
PC19_PWMH5: U12.101 (PC19/PWMH5)
PC20_PWMH4: U12.131 (PC20/PWMH4)
PC21_PWML4: U12.132 (PC21/PWML4)
PC22_PWML5: U12.133 (PC22/PWML5)
PC23_PWML6: U12.134 (PC23/PWML6)
PC28: U12.139 (PC28)
PC29: U12.102 (PC29)
PC30: U12.103 (PC30)
PD9: U12.22 (PD9)
PS_ON_CONTROL: U12.21 (PD8)
RESET: C92.2, J23.10 (*RST), S2.3, S2.4, U12.47 (NRSTB)
RXD0: U12.3 (PA10/RXD0)
RXD1: U12.5 (PA12/RXD1)
SD_CD: U12.68 (PB27)
SPI0_MISO: U12.108 (PA25/SPI0_MISO)
SPI0_MOSI: U12.109 (PA26/SPI0_MOSI)
SPI0_NPCS0: U12.111 (PA28/SPI0_NPCS0)
SPI0_NPCS1: U12.112 (PA29)
SPI0_SPCK: U12.110 (PA27/SPI0_SPCK)
TWCK0: U12.70 (PA18/TWCK0)
TWCK1: U12.87 (PB13/TWCK1)
TWD0: U12.9 (PA17/TWD0)
TWD1: U12.86 (PB12/TWD1)
TXD0: U12.4 (PA11/TXD0)
TXD1: U12.6 (PA13/TXD1)
UFAULT: U12.55 (PC1)
UOTGID: U12.129 (PB11/UOTGID)
UOTGVBOF: U12.128 (PB10/UOTGVBOF)
URXD: U12.27 (PA8/URXD)
UTXD: U12.2 (PA9/UTXD)
VBUS: U12.39 (VBUS)
VDDANA: C73.1, C74.1, L4.1 (A), U12.73 (VDDANA)
VDDCORE: C85.1, C86.1, C87.1, C89.1, C90.1, C91.1, L7.1 (A), U12.10 (VDDCORE), U12.45 (VDDCORE), U12.56 (VDDOUT), U12.61 (VDDCORE), U12.104 (VDDCORE), U12.124 (VDDCORE)
VDDUTMI: C71.1, C72.1, L3.1 (A), U12.41 (VDDUTMI)
VSSA: C88.1, L6.2 (B), U12.74 (GNDANA)
X_DIR: U12.18 (PD5)
X_EN: U12.19 (PD6)
X_STEP: U12.17 (PD4)
X_STOP: U12.20 (PD7)
Y_DIR: U12.14 (PD1)
Y_EN: U12.15 (PD2)
Y_STEP: U12.13 (PD0)
Y_STOP: U12.16 (PD3)
Z_DIR: U12.137 (PC26)
Z_EN: U12.138 (PC27)
Z_STEP: U12.136 (PC25)
Z_STOP: U12.84 (PA3/AD1)

Notes on the sheet:
Integrates a permanent ~15K pullup resistor
SPI(0)
I2C(1)
VDDPLL
VDDCORE
VDDIO
VDDIN
