woodsmoke/Due_SB/Duet-master/Duet0.8.5/Stepper_Drv.sch

## KiCad design Duet-master/Duet0.8.5/Stepper_Drv.sch (2015-08-12, an earlier design)



Parts:
C1, C2, C9, C10, C15, C16, C23, C24, C29, C33: 0u22
C3, C4, C7, C8, C11, C12, C13, C14, C17, C18, C21, C22, C25, C26, C27, C28, C30, C32, C34, C35, C36, C37, C38, C39, C40, C41, C42: 0u1
C5, C6, C19, C20, C31: 100u
D1: 1SS400T1G; Fwd Voltage Drop (1mA) 0.6V at 1mA
D2: E1 Stop
D3: Y Stop
D4: Z Stop
D5: E2 Stop
D6: E0 Stop
D7: X Stop
J1: X VREF
J2: Z VREF
J3: Y VREF
J4: E0 VREF
J5: E1 VREF
R1, R3, R13, R22: 100k
R2, R4, R12, R14, R23, R30: 10k
R5, R6, R15, R16, R25: 0R
R7, R8, R9, R10, R17, R18, R19, R20, R28, R29: 0R1
R11: 100k; 0603
R21, R24: 4k7
R26: 2k7
R27: 2K15
R31, R32, R33, R37, R38, R39: 100R
R34, R35, R36, R40, R41, R42: 680R
SJ1, SJ2, SJ5, SJ6, SJ9: MS2
SJ3, SJ4, SJ7, SJ8, SJ10: MS1
U1, U2, U3, U4, U5: A4982SLPTR
U6: MCP44X1

Connections:
+3.3V: C9.1, C10.1, C23.1, C24.1, C33.1, C35.1, R1.1, R2.1, R3.1, R4.1, R11.1, R12.1, R13.1, R14.1, R21.1, R22.1, R23.1, R24.1, R26.1, R30.1, R34.2, R35.2, R36.2, R40.2, R41.2, R42.2, SJ1.1 (SJ_P1), SJ1.2 (SJ_P2), SJ2.1 (SJ_P1), SJ2.2 (SJ_P2), SJ3.1 (SJ_P1), SJ3.2 (SJ_P2), SJ4.1 (SJ_P1), SJ4.2 (SJ_P2), SJ5.1 (SJ_P1), SJ5.2 (SJ_P2), SJ6.1 (SJ_P1), SJ6.2 (SJ_P2), SJ7.1 (SJ_P1), SJ7.2 (SJ_P2), SJ8.1 (SJ_P1), SJ8.2 (SJ_P2), SJ9.1 (SJ_P1), SJ9.2 (SJ_P2), SJ10.1 (SJ_P1), SJ10.2 (SJ_P2), U1.5 (MS1), U1.6 (MS2), U1.10 (VDD), U2.5 (MS1), U2.6 (MS2), U2.10 (VDD), U3.5 (MS1), U3.6 (MS2), U3.10 (VDD), U4.5 (MS1), U4.6 (MS2), U4.10 (VDD), U5.5 (MS1), U5.6 (MS2), U5.10 (VDD), U6.17 (VDD)
E0_DIR: U4.14 (DIR)
E0_EN: R13.2, U4.23 (/ENABLE)
E0_MOT_1A: U4.18 (OUT1A)
E0_MOT_1B: U4.15 (OUT1B)
E0_MOT_2A: U4.19 (OUT2A)
E0_MOT_2B: U4.22 (OUT2B)
E0_REF: C28.1, J4.1, U4.12 (REF), U6.12 (P0W)
E0_STEP: U4.11 (STEP)
E0_STOP: C42.1, R38.1
E0_STOP_CONN: D6.2 (K), R38.2
E1_DIR: U5.14 (DIR)
E1_EN: R22.2, U5.23 (/ENABLE)
E1_MOT_1A: U5.18 (OUT1A)
E1_MOT_1B: U5.15 (OUT1B)
E1_MOT_2A: U5.19 (OUT2A)
E1_MOT_2B: U5.22 (OUT2B)
E1_REF: C36.1, D1.1 (K), J5.1, R27.2, U5.12 (REF)
E1_STEP: U5.11 (STEP)
E1_STOP: C39.1, R32.1
E1_STOP_CONN: D2.2 (K), R32.2
E2_STOP: C40.1, R37.1
E2_STOP_CONN: D5.2 (K), R37.2
GND: C1.2, C2.2, C3.1, C4.1, C5.2, C6.2, C9.2, C10.2, C13.2, C14.2, C15.2, C16.2, C17.1, C18.1, C19.2, C20.2, C23.2, C24.2, C27.2, C28.2, C29.2, C30.1, C31.2, C33.2, C35.2, C36.2, C37.2, C38.2, C39.2, C40.2, C41.2, C42.2, R5.2, R6.2, R7.2, R8.2, R9.2, R10.2, R15.2, R16.2, R17.2, R18.2, R19.2, R20.2, R25.2, R27.1, R28.2, R29.2, U1.13 (GND), U1.24 (GND), U1.25 (GND_PAD), U2.13 (GND), U2.24 (GND), U2.25 (GND_PAD), U3.13 (GND), U3.24 (GND), U3.25 (GND_PAD), U4.13 (GND), U4.24 (GND), U4.25 (GND_PAD), U5.13 (GND), U5.24 (GND), U5.25 (GND_PAD), U6.3 (P3B), U6.4 (HVC/A0), U6.7 (VSS), U6.8 (P1B), U6.13 (P0B), U6.16 (A1), U6.18 (P2B)
unnamed: C1.1, U1.4 (VREG)
unnamed: C2.1, U2.4 (VREG)
unnamed: C7.1, U1.3 (VCP)
unnamed: C8.1, U2.3 (VCP)
unnamed: C11.1, U1.1 (CP1)
unnamed: C11.2, U1.2 (CP2)
unnamed: C12.1, U2.1 (CP1)
unnamed: C12.2, U2.2 (CP2)
unnamed: C15.1, U3.4 (VREG)
unnamed: C16.1, U4.4 (VREG)
unnamed: C21.1, U3.3 (VCP)
unnamed: C22.1, U4.3 (VCP)
unnamed: C25.1, U3.1 (CP1)
unnamed: C25.2, U3.2 (CP2)
unnamed: C26.1, U4.1 (CP1)
unnamed: C26.2, U4.2 (CP2)
unnamed: C29.1, U5.4 (VREG)
unnamed: C32.1, U5.3 (VCP)
unnamed: C34.1, U5.1 (CP1)
unnamed: C34.2, U5.2 (CP2)
unnamed: D2.1 (A), R34.1
unnamed: D3.1 (A), R35.1
unnamed: D4.1 (A), R36.1
unnamed: D5.1 (A), R40.1
unnamed: D6.1 (A), R41.1
unnamed: D7.1 (A), R42.1
unnamed: R2.2, U1.7 (/RESET), U1.9 (/SLEEP)
unnamed: R4.2, U2.7 (/RESET), U2.9 (/SLEEP)
unnamed: R5.1, U1.8 (ROSC)
unnamed: R6.1, U2.8 (ROSC)
unnamed: R7.1, U1.20 (SENSE2)
unnamed: R8.1, U2.20 (SENSE2)
unnamed: R9.1, U1.17 (SENSE1)
unnamed: R10.1, U2.17 (SENSE1)
unnamed: R12.2, U3.7 (/RESET), U3.9 (/SLEEP)
unnamed: R14.2, U4.7 (/RESET), U4.9 (/SLEEP)
unnamed: R15.1, U3.8 (ROSC)
unnamed: R16.1, U4.8 (ROSC)
unnamed: R17.1, U3.20 (SENSE2)
unnamed: R18.1, U4.20 (SENSE2)
unnamed: R19.1, U3.17 (SENSE1)
unnamed: R20.1, U4.17 (SENSE1)
unnamed: R23.2, U5.7 (/RESET), U5.9 (/SLEEP)
unnamed: R25.1, U5.8 (ROSC)
unnamed: R26.2, U6.1 (P3A), U6.10 (P1A), U6.11 (P0A), U6.20 (P2A)
unnamed: R28.1, U5.20 (SENSE2)
unnamed: R29.1, U5.17 (SENSE1)
unnamed: R30.2, U6.15 (*RESET)
PB15/DAC0: D1.2 (A)
TWCK0: R21.2, U6.5 (SCL)
TWD0: R24.2, U6.6 (SDA)
V_IN: C3.2, C4.2, C5.1, C6.1, C7.2, C8.2, C17.2, C18.2, C19.1, C20.1, C21.2, C22.2, C30.2, C31.1, C32.2, U1.16 (VBB1), U1.21 (VBB2), U2.16 (VBB1), U2.21 (VBB2), U3.16 (VBB1), U3.21 (VBB2), U4.16 (VBB1), U4.21 (VBB2), U5.16 (VBB1), U5.21 (VBB2)
X_DIR: U1.14 (DIR)
X_EN: R1.2, U1.23 (/ENABLE)
X_MOT_1A: U1.18 (OUT1A)
X_MOT_1B: U1.15 (OUT1B)
X_MOT_2A: U1.19 (OUT2A)
X_MOT_2B: U1.22 (OUT2B)
X_REF: C13.1, J1.1, U1.12 (REF), U6.9 (P1W)
X_STEP: U1.11 (STEP)
X_STOP: C41.1, R39.1
X_STOP_CONN: D7.2 (K), R39.2
Y_DIR: U3.14 (DIR)
Y_EN: R11.2, U3.23 (/ENABLE)
Y_MOT_1A: U3.18 (OUT1A)
Y_MOT_1B: U3.15 (OUT1B)
Y_MOT_2A: U3.19 (OUT2A)
Y_MOT_2B: U3.22 (OUT2B)
Y_REF: C27.1, J3.1, U3.12 (REF), U6.2 (P3W)
Y_STEP: U3.11 (STEP)
Y_STOP: C37.1, R33.1
Y_STOP_CONN: D3.2 (K), R33.2
Z_DIR: U2.14 (DIR)
Z_EN: R3.2, U2.23 (/ENABLE)
Z_MOT_1A: U2.18 (OUT1A)
Z_MOT_1B: U2.15 (OUT1B)
Z_MOT_2A: U2.19 (OUT2A)
Z_MOT_2B: U2.22 (OUT2B)
Z_REF: C14.1, J2.1, U2.12 (REF), U6.19 (P2W)
Z_STEP: U2.11 (STEP)
Z_STOP: C38.1, R31.1
Z_STOP_CONN: D4.2 (K), R31.2

Notes on the sheet:
2k7 resistor chosen to give range of VRef with 0R1 sense resistors for full range of current, to use the maximum current cooling would be required.
Endstops.
Digital Current Limit Control
Z-Axis Stepper Driver
Extruder 0 Stepper Driver
Y-Axis Stepper Driver
X-Axis Stepper Driver
Extruder 1 Stepper Driver
DAC Control for E1
DAC voltage range 0.55V-2.75V if Vana = 3.3V Diode with Vfwd of 0.6V drops the voltage range to approx 0V-2.15V (different from the same range as the Digipot). Note that Diodes Vfwd depends on current. The current flow is set by the resistor (2K15), at 2.15V = 1mA decreasing as the voltage decrease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
