woodsmoke/Due_SB/Duet-master/Archive_Files/Duet0.3/Comms.sch

## KiCad design Duet-master/Archive_Files/Duet0.3/Comms.sch (2015-08-09, an earlier design)

Schematic: Comms.sch

Parts:
C7: 10u
C8, C9: 22p
C10, C11: 22u
C12, C58: 2u2
C13: 1u
C16, C17, C53: 0u1
D3: LED
D4, D5: TS4148
J15: USD_SOCKET
J19: RJ45+MAG
J22: USBCONN-MICROB
L2: Ferrite Bead; 1206
R1: 680R
R2, R3: 39R 1%
R4, R5: 10k; 0603
R6, R7, R8, R9, R10: 33R; 0603
R11: 1k; 0603
R12, R13, R14: 4k7; 0603
R15: 6k49 1%; 0603
R16, R17: 220R; 0603
R53: 100k
U4: KSZ8051RNL
U10: SP2525A
X1: 25MHz

Notes on the sheet:
uSD
ETHERNET
USB
Further testing required, may not place in final design
LED Pins are as per the reference design this needs testing
