woodsmoke/Due_SB/Duet-master/Archive_Files/Duet0.3/Headers.sch

## KiCad design Duet-master/Archive_Files/Duet0.3/Headers.sch (2015-08-09, an earlier design)

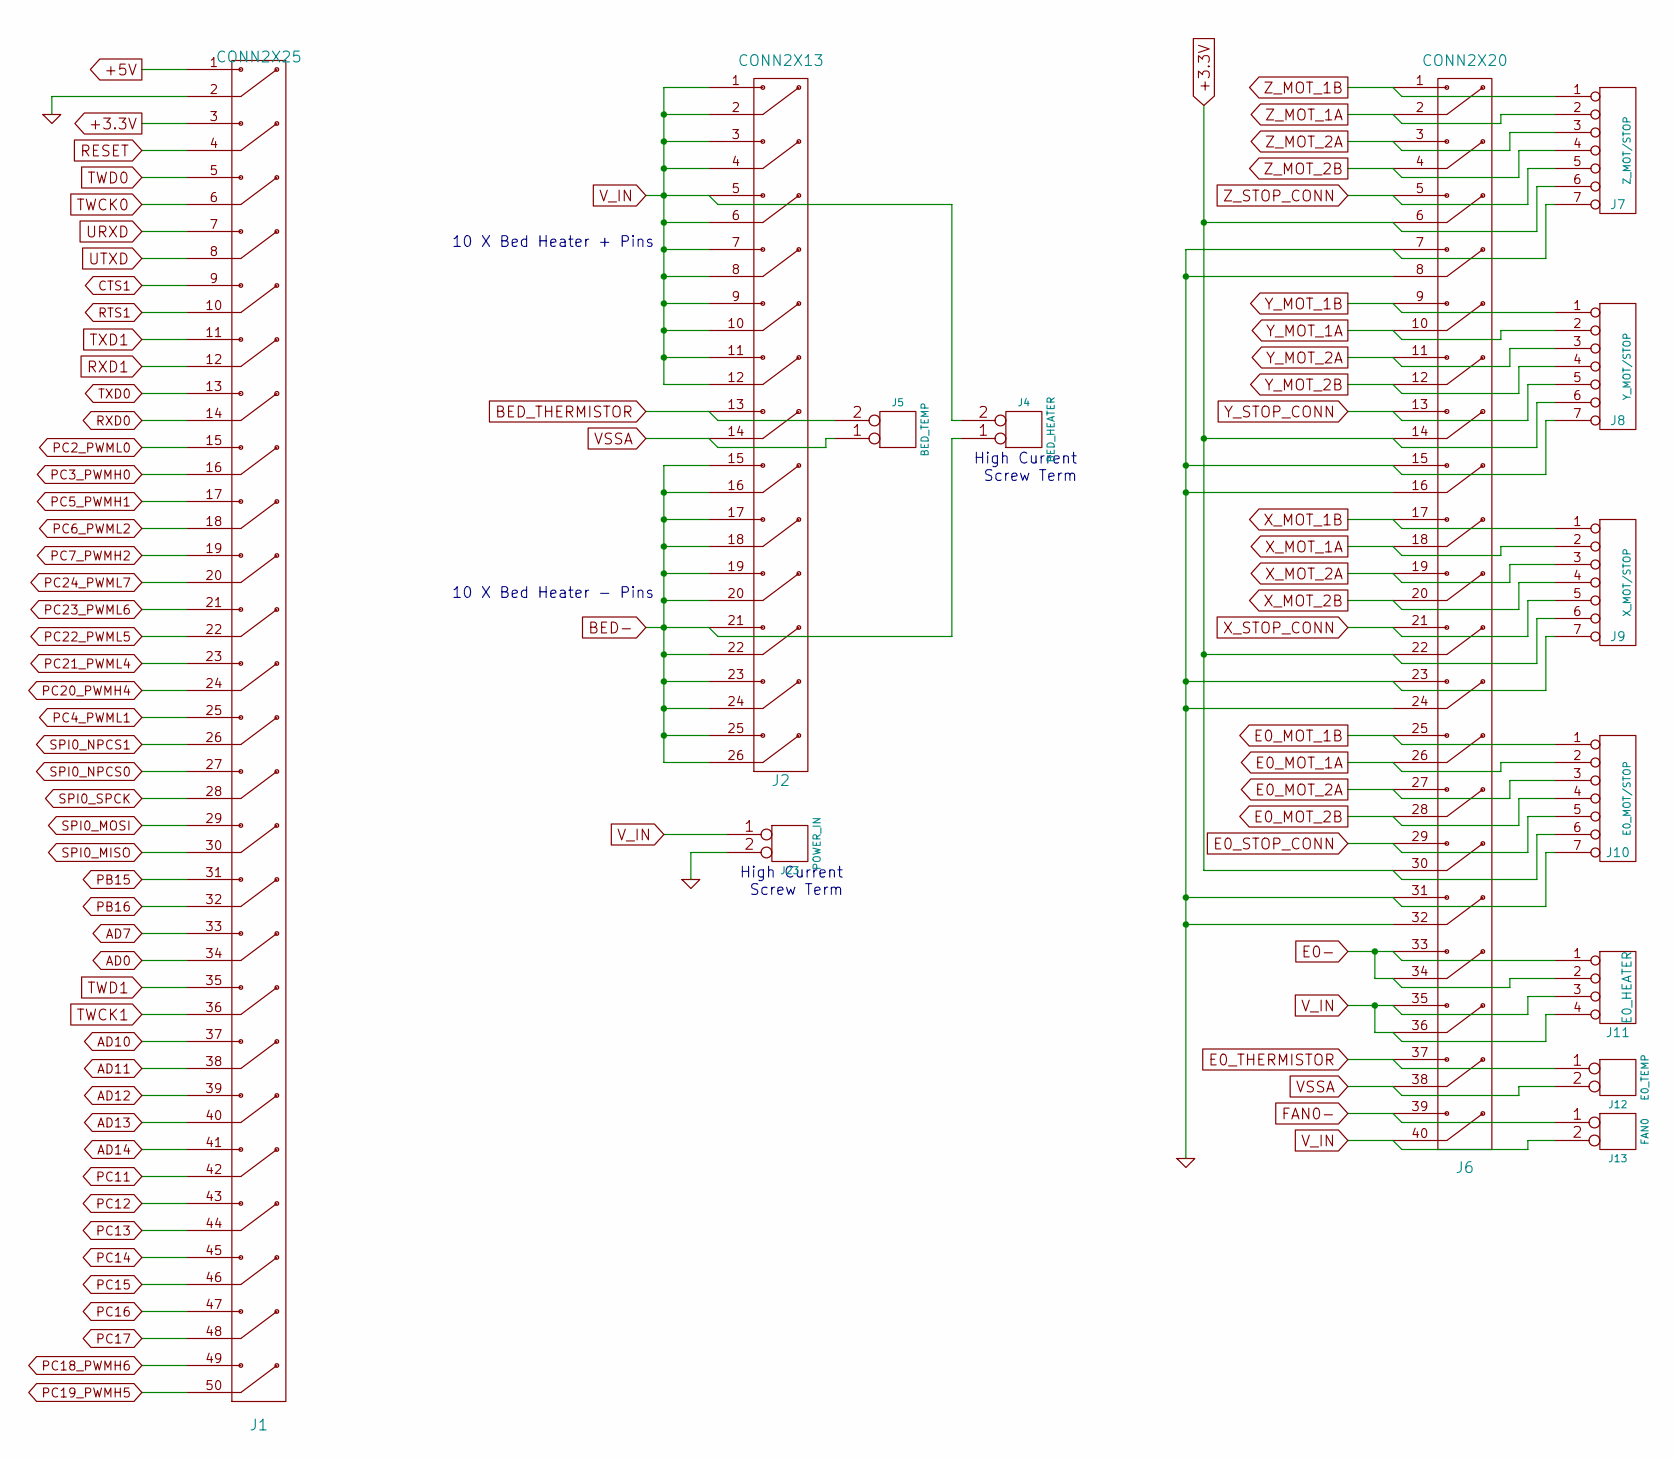
[picture p25: schematic Headers.sch]

Parts:
J1: CONN2X25
J2: CONN2X13
J4: BED_HEATER
J5: BED_TEMP
J6: CONN2X20
J7: Z_MOT/STOP
J8: Y_MOT/STOP
J9: X_MOT/STOP
J10: E0_MOT/STOP
J11: E0_HEATER
J12: E0_TEMP
J13: FAN0
J23: POWER_IN

Connections:
+3.3V: J1.3, J6.6, J6.14, J6.22, J6.30, J7.6, J8.6, J9.6, J10.6
+5V: J1.1
AD0: J1.34
AD7: J1.33
AD10: J1.37
AD11: J1.38
AD12: J1.39
AD13: J1.40
AD14: J1.41
BED-: J2.15, J2.16, J2.17, J2.18, J2.19, J2.20, J2.21, J2.22, J2.23, J2.24, J2.25, J2.26, J4.1
BED_THERMISTOR: J2.13, J5.2 (PM)
CTS1: J1.9
E0-: J6.33, J6.34, J11.1, J11.2
E0_MOT_1A: J6.26, J10.2
E0_MOT_1B: J6.25, J10.1
E0_MOT_2A: J6.27, J10.3
E0_MOT_2B: J6.28, J10.4
E0_STOP_CONN: J6.29, J10.5
E0_THERMISTOR: J6.37, J12.1
FAN0-: J6.39, J13.1
GND: J1.2, J6.7, J6.8, J6.15, J6.16, J6.23, J6.24, J6.31, J6.32, J7.7, J8.7, J9.7, J10.7, J23.2 (PM)
PB15: J1.31
PB16: J1.32
PC2_PWML0: J1.15
PC3_PWMH0: J1.16
PC4_PWML1: J1.25
PC5_PWMH1: J1.17
PC6_PWML2: J1.18
PC7_PWMH2: J1.19
PC11: J1.42
PC12: J1.43
PC13: J1.44
PC14: J1.45
PC15: J1.46
PC16: J1.47
PC17: J1.48
PC18_PWMH6: J1.49
PC19_PWMH5: J1.50
PC20_PWMH4: J1.24
PC21_PWML4: J1.23
PC22_PWML5: J1.22
PC23_PWML6: J1.21
PC24_PWML7: J1.20
RESET: J1.4
RTS1: J1.10
RXD0: J1.14
RXD1: J1.12
SPI0_MISO: J1.30
SPI0_MOSI: J1.29
SPI0_NPCS0: J1.27
SPI0_NPCS1: J1.26
SPI0_SPCK: J1.28
TWCK0: J1.6
TWCK1: J1.36
TWD0: J1.5
TWD1: J1.35
TXD0: J1.13
TXD1: J1.11
URXD: J1.7
UTXD: J1.8
VSSA: J2.14, J5.1, J6.38, J12.2 (PM)
V_IN: J2.1, J2.2, J2.3, J2.4, J2.5, J2.6, J2.7, J2.8, J2.9, J2.10, J2.11, J2.12, J4.2 (PM), J6.35, J6.36, J6.40, J11.3, J11.4, J13.2 (PM), J23.1
X_MOT_1A: J6.18, J9.2
X_MOT_1B: J6.17, J9.1
X_MOT_2A: J6.19, J9.3
X_MOT_2B: J6.20, J9.4
X_STOP_CONN: J6.21, J9.5
Y_MOT_1A: J6.10, J8.2
Y_MOT_1B: J6.9, J8.1
Y_MOT_2A: J6.11, J8.3
Y_MOT_2B: J6.12, J8.4
Y_STOP_CONN: J6.13, J8.5
Z_MOT_1A: J6.2, J7.2
Z_MOT_1B: J6.1, J7.1
Z_MOT_2A: J6.3, J7.3
Z_MOT_2B: J6.4, J7.4
Z_STOP_CONN: J6.5, J7.5

Notes on the sheet:
High Current Screw Term
10 X Bed Heater + Pins
10 X Bed Heater - Pins
