woodsmoke/Due_SB/Duet-master/Archive_Files/Duet0.3/Htr_Fan.sch

## KiCad design Duet-master/Archive_Files/Duet0.3/Htr_Fan.sch (2015-08-09, an earlier design)

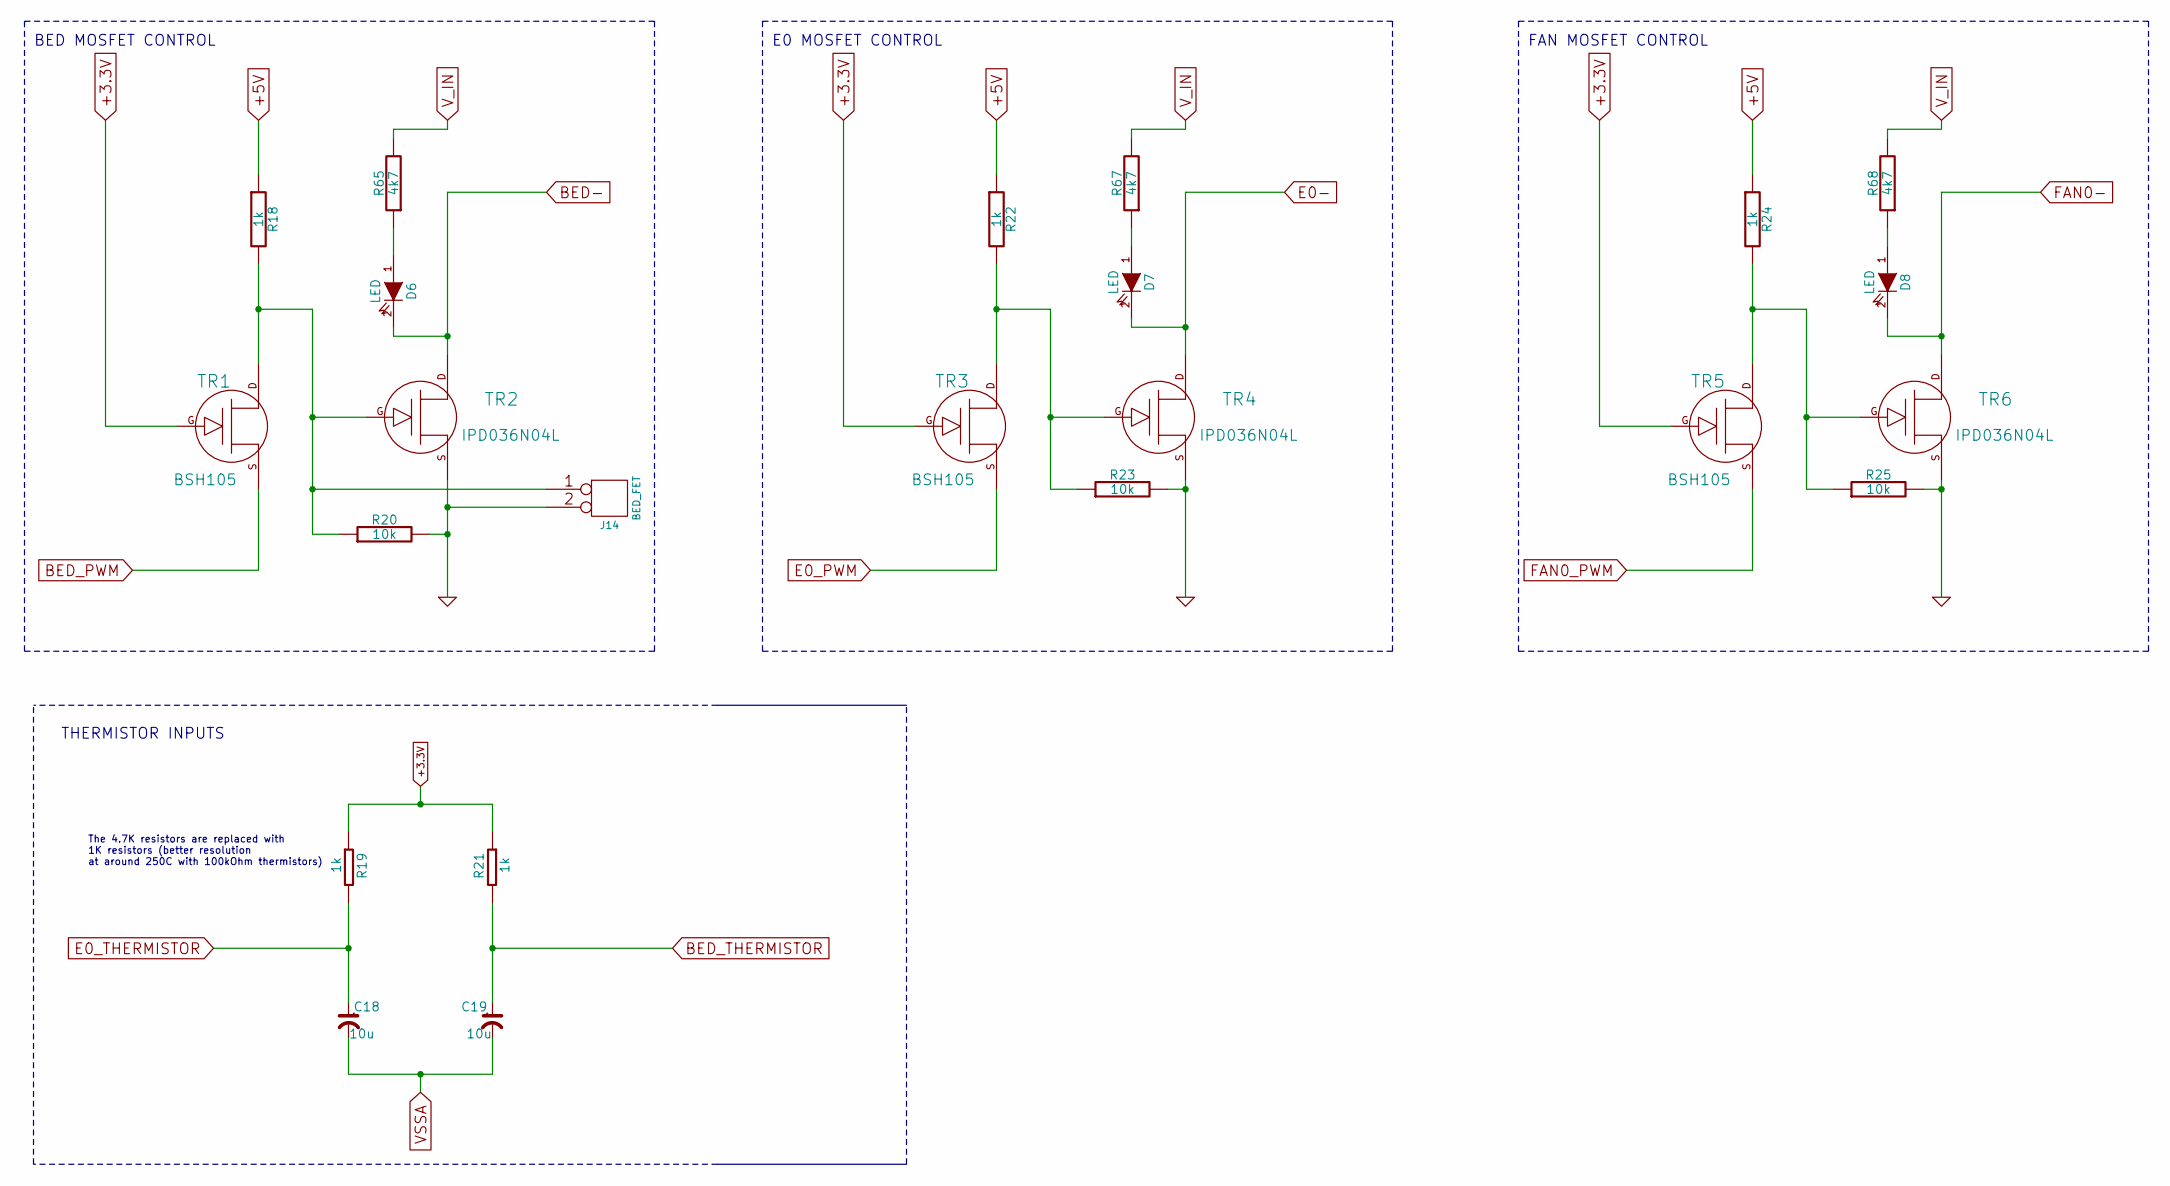
[picture p26: schematic Htr_Fan.sch]

Parts:
C18, C19: 10u
D6, D7, D8: LED
J14: BED_FET
R18, R19, R21, R22, R24: 1k
R20, R23, R25: 10k
R65, R67, R68: 4k7
TR1, TR3, TR5: BSH105
TR2, TR4, TR6: IPD036N04L

Connections:
+3.3V: R19.1, R21.1, TR1.G, TR3.G, TR5.G
+5V: R18.1, R22.1, R24.1
BED-: D6.2 (K), TR2.D
BED_PWM: TR1.S
BED_THERMISTOR: C19.1, R21.2
E0-: D7.2 (K), TR4.D
E0_PWM: TR3.S
E0_THERMISTOR: C18.1, R19.2
FAN0-: D8.2 (K), TR6.D
FAN0_PWM: TR5.S
GND: J14.2 (PM), R20.2, R23.2, R25.2, TR2.S, TR4.S, TR6.S
unnamed: D6.1 (A), R65.1
unnamed: D7.1 (A), R67.1
unnamed: D8.1 (A), R68.1
unnamed: J14.1, R18.2, R20.1, TR1.D, TR2.G
unnamed: R22.2, R23.1, TR3.D, TR4.G
unnamed: R24.2, R25.1, TR5.D, TR6.G
VSSA: C18.2, C19.2
V_IN: R65.2, R67.2, R68.2

Notes on the sheet:
The 4.7K resistors are replaced with 1K resistors (better resolution at around 250C with 100kOhm thermistors)
THERMISTOR INPUTS
FAN MOSFET CONTROL
E0 MOSFET CONTROL
BED MOSFET CONTROL
