woodsmoke/Due_SB/Duet-master/Archive_Files/Duet0.3/Power.sch

## KiCad design Duet-master/Archive_Files/Duet0.3/Power.sch (2015-08-09, an earlier design)

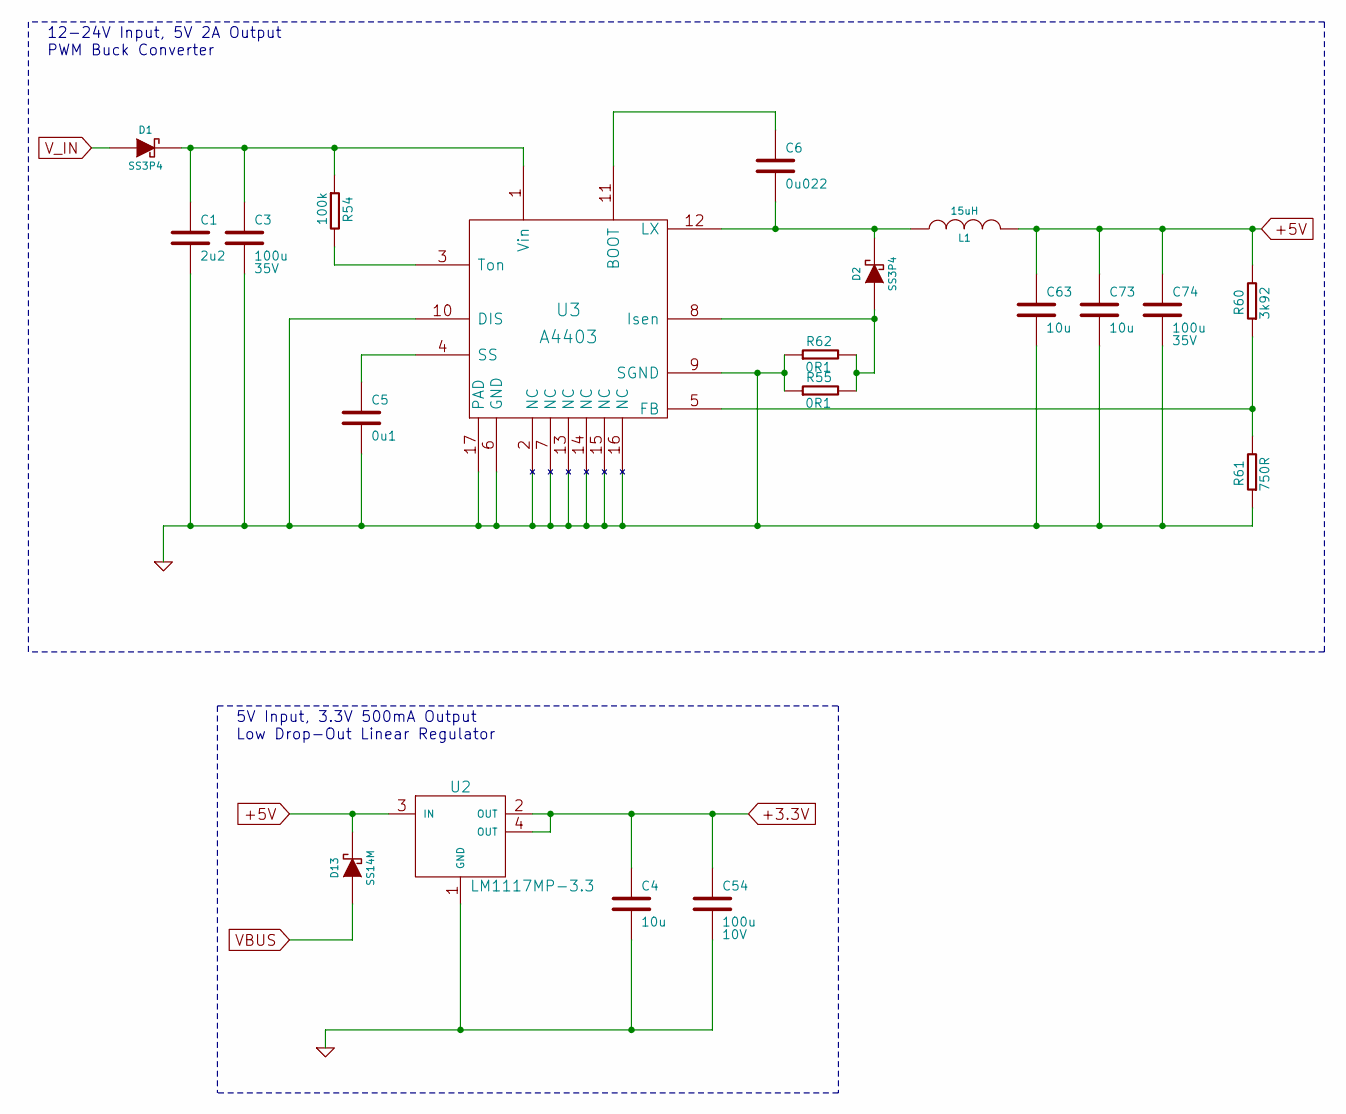
[picture p27: schematic Power.sch]

Parts:
C1: 2u2
C3, C74: 100u; Voltage 35V
C4, C63, C73: 10u
C5: 0u1
C6: 0u022
C54: 100u; Voltage 10V
D1, D2: SS3P4
D13: SS14M
L1: 15uH
R54: 100k
R55, R62: 0R1
R60: 3k92
R61: 750R
U2: LM1117MP-3.3
U3: A4403

Connections:
+3.3V: C4.1, C54.1, U2.2 (OUT), U2.4 (OUT)
+5V: C63.1, C73.1, C74.1, D13.2 (K), L1.2, R60.2, U2.3 (IN)
GND: C1.2, C3.2, C4.2, C5.2, C54.2, C63.2, C73.2, C74.2, R55.1, R61.1, R62.1, U2.1 (GND), U3.2 (NC), U3.6 (GND), U3.7 (NC), U3.9 (SGND), U3.10 (DIS), U3.13 (NC), U3.14 (NC), U3.15 (NC), U3.16 (NC), U3.17 (PAD)
unnamed: C1.1, C3.1, D1.2 (K), R54.1, U3.1 (Vin)
unnamed: C5.1, U3.4 (SS)
unnamed: C6.1, U3.11 (BOOT)
unnamed: C6.2, D2.2 (K), L1.1, U3.12 (LX)
unnamed: D2.1 (A), R55.2, R62.2, U3.8 (Isen)
unnamed: R54.2, U3.3 (Ton)
unnamed: R60.1, R61.2, U3.5 (FB)
VBUS: D13.1 (A)
V_IN: D1.1 (A)

Notes on the sheet:
5V Input, 3.3V 500mA Output Low Drop-Out Linear Regulator
12-24V Input, 5V 2A Output PWM Buck Converter
