woodsmoke/Due_SB/Duet-master/Duet_Expansion/Duex4v0.2/Headers_expansion.sch

## KiCad design Duet-master/Duet_Expansion/Duex4v0.2/Headers_expansion.sch (2015-08-09)

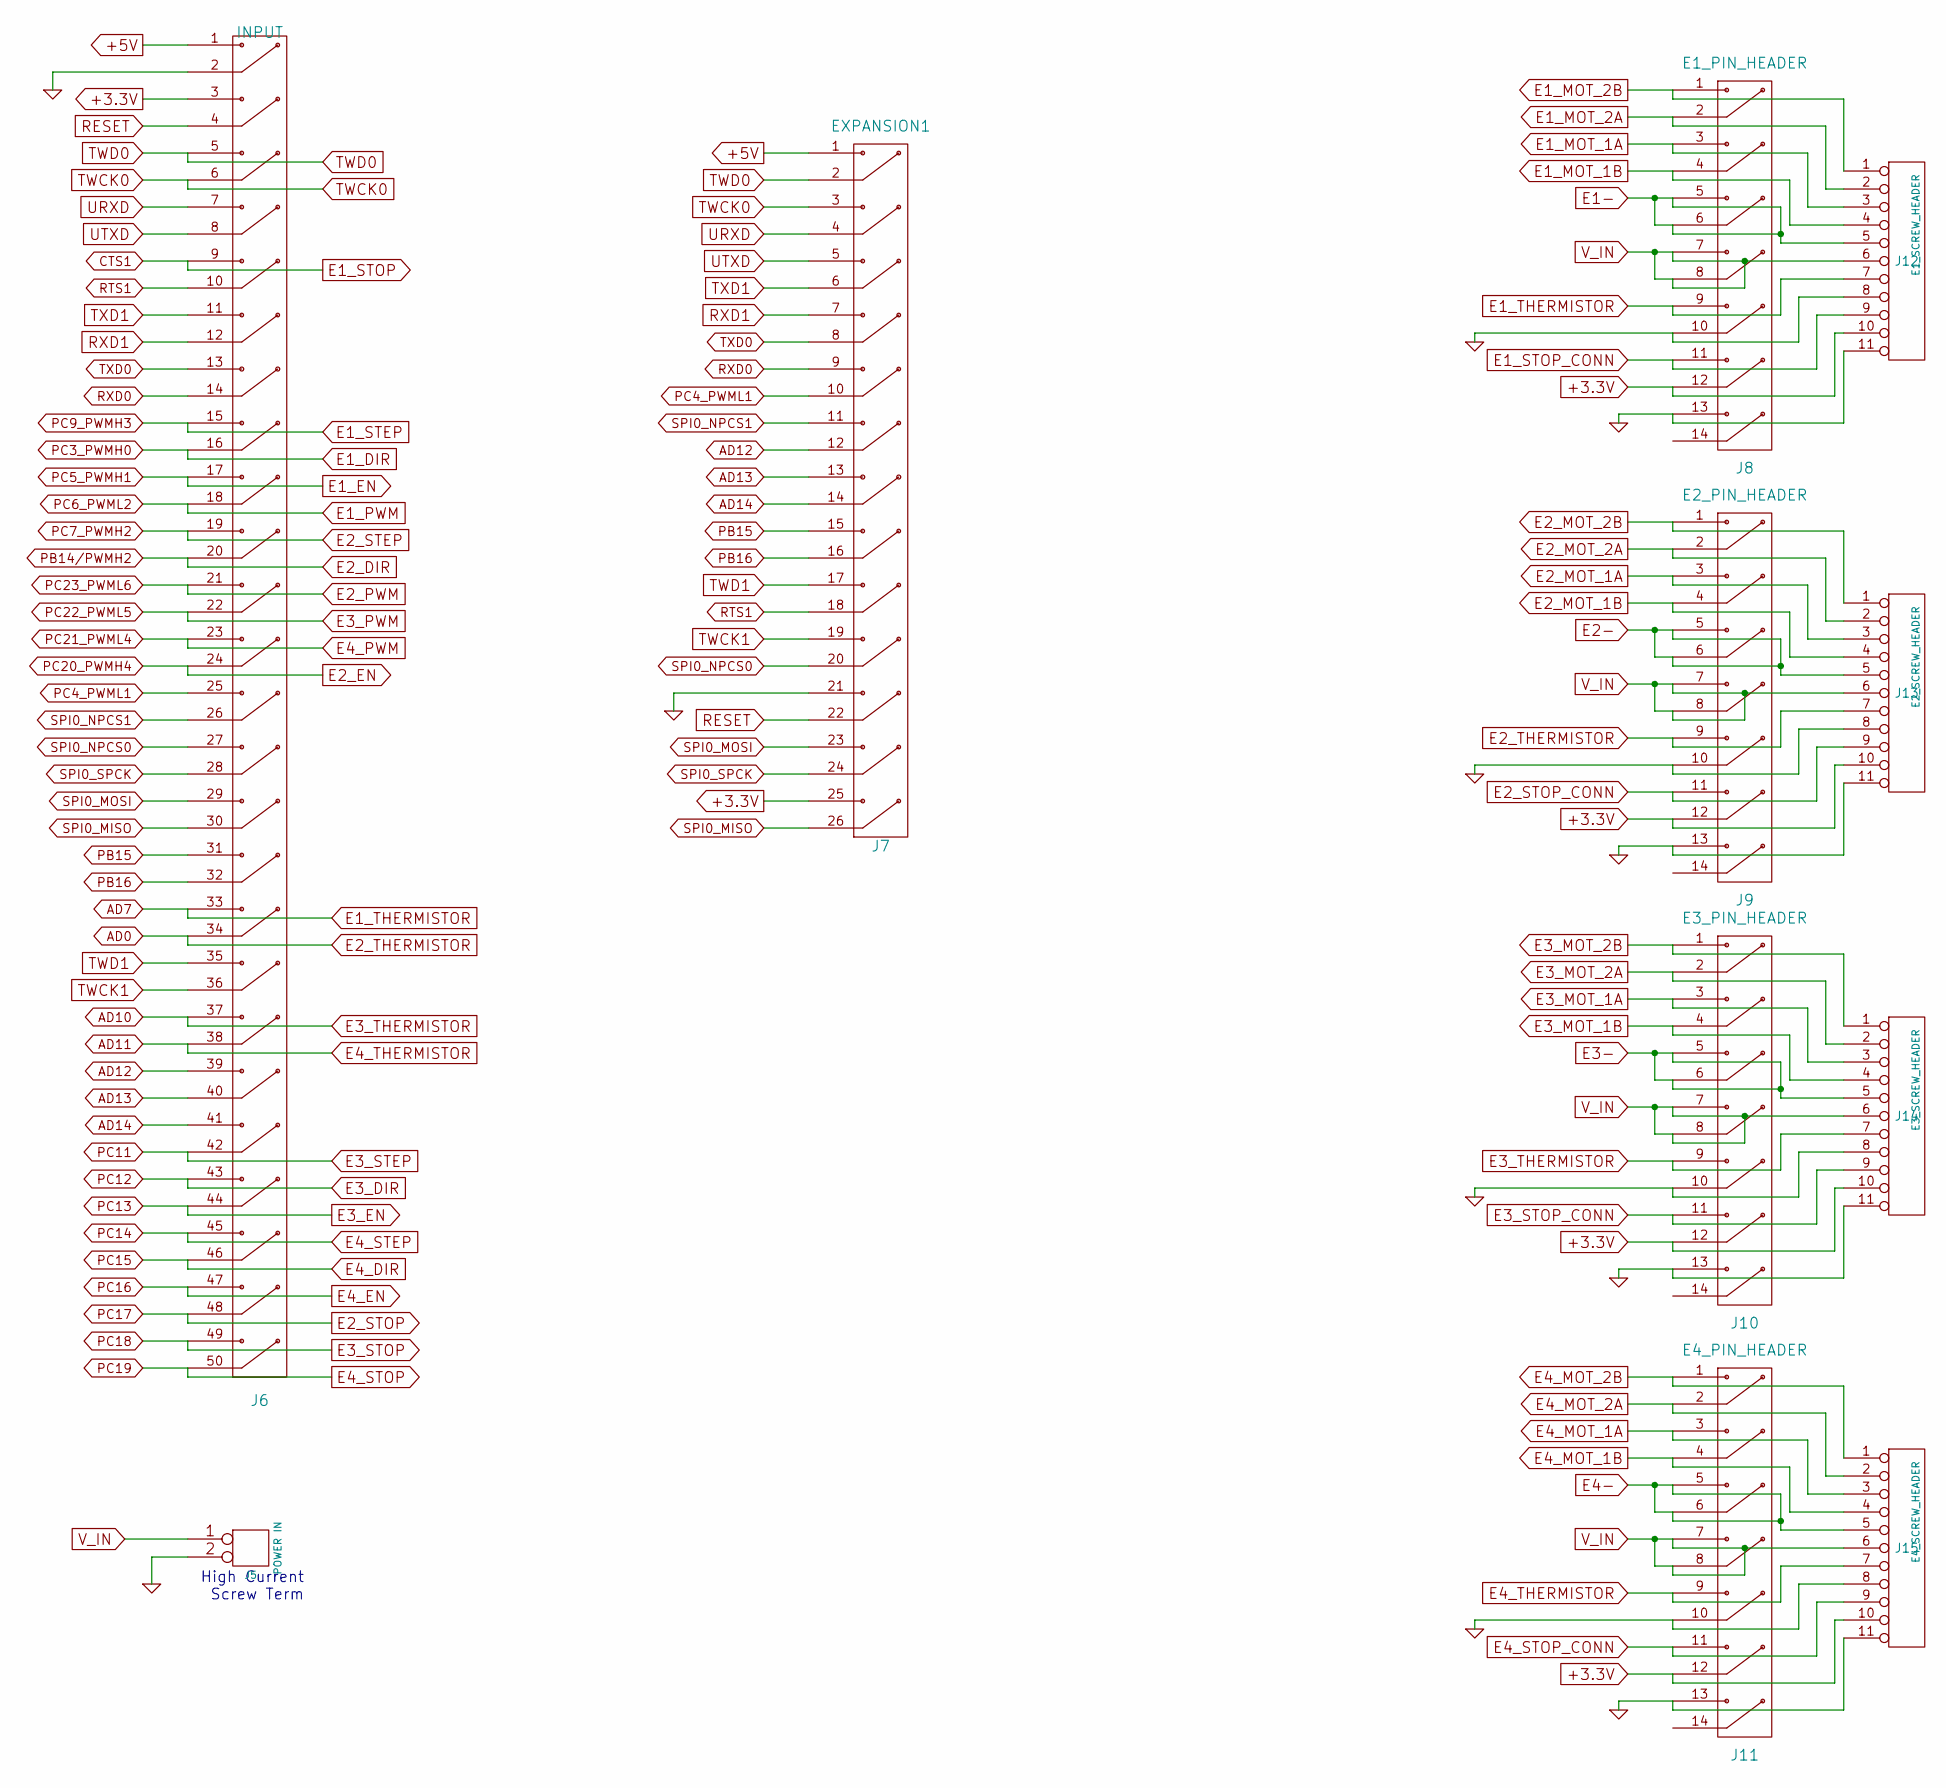
[picture p28: schematic Headers_expansion.sch]

Parts:
J5: POWER IN; TERM_2-WAY_24A
J6: INPUT; PIN_ARRAY_25X2
J7: EXPANSION1; PIN_ARRAY_13x2
J8: E1_PIN_HEADER
J9: E2_PIN_HEADER
J10: E3_PIN_HEADER
J11: E4_PIN_HEADER
J12: E1_SCREW_HEADER
J13: E2_SCREW_HEADER
J14: E3_SCREW_HEADER
J15: E4_SCREW_HEADER

Connections:
+3.3V: J6.3, J7.25, J8.12, J9.12, J10.12, J11.12, J12.10 (P5), J13.10 (P5), J14.10 (P5), J15.10 (P5)
+5V: J6.1, J7.1
AD0: J6.34, J9.9, J13.7
AD7: J6.33, J8.9, J12.7
AD10: J6.37, J10.9, J14.7
AD11: J6.38, J11.9, J15.7
AD12: J6.39, J7.12
AD13: J6.40, J7.13
AD14: J6.41, J7.14
CTS1: J6.9
E1-: J8.5, J8.6, J12.5
E1_DIR: J6.16
E1_EN: J6.17
E1_MOT_1A: J8.3, J12.3
E1_MOT_1B: J8.4, J12.4
E1_MOT_2A: J8.2, J12.2
E1_MOT_2B: J8.1, J12.1
E1_PWM: J6.18
E1_STEP: J6.15
E1_STOP_CONN: J8.11, J12.9 (P4)
E2-: J9.5, J9.6, J13.5
E2_DIR: J6.20
E2_EN: J6.24
E2_MOT_1A: J9.3, J13.3
E2_MOT_1B: J9.4, J13.4
E2_MOT_2A: J9.2, J13.2
E2_MOT_2B: J9.1, J13.1
E2_PWM: J6.21
E2_STEP: J6.19
E2_STOP: J6.48
E2_STOP_CONN: J9.11, J13.9 (P4)
E3-: J10.5, J10.6, J14.5
E3_DIR: J6.43
E3_EN: J6.44
E3_MOT_1A: J10.3, J14.3
E3_MOT_1B: J10.4, J14.4
E3_MOT_2A: J10.2, J14.2
E3_MOT_2B: J10.1, J14.1
E3_PWM: J6.22
E3_STEP: J6.42
E3_STOP: J6.49
E3_STOP_CONN: J10.11, J14.9 (P4)
E4-: J11.5, J11.6, J15.5
E4_DIR: J6.46
E4_EN: J6.47
E4_MOT_1A: J11.3, J15.3
E4_MOT_1B: J11.4, J15.4
E4_MOT_2A: J11.2, J15.2
E4_MOT_2B: J11.1, J15.1
E4_PWM: J6.23
E4_STEP: J6.45
E4_STOP: J6.50
E4_STOP_CONN: J11.11, J15.9 (P4)
GND: J5.2 (PM), J6.2, J7.21, J8.10, J8.13, J9.10, J9.13, J10.10, J10.13, J11.10, J11.13, J12.8 (P3), J12.11 (P6), J13.8 (P3), J13.11 (P6), J14.8 (P3), J14.11 (P6), J15.8 (P3), J15.11 (P6)
PB15: J6.31, J7.15
PB16: J6.32, J7.16
PC4_PWML1: J6.25, J7.10
RESET: J6.4, J7.22
RTS1: J6.10, J7.18
RXD0: J6.14, J7.9
RXD1: J6.12, J7.7
SPI0_MISO: J6.30, J7.26
SPI0_MOSI: J6.29, J7.23
SPI0_NPCS0: J6.27, J7.20
SPI0_NPCS1: J6.26, J7.11
SPI0_SPCK: J6.28, J7.24
TWCK0: J6.6, J7.3
TWCK1: J6.36, J7.19
TWD0: J6.5, J7.2
TWD1: J6.35, J7.17
TXD0: J6.13, J7.8
TXD1: J6.11, J7.6
URXD: J6.7, J7.4
UTXD: J6.8, J7.5
V_IN: J5.1, J8.7, J8.8, J9.7, J9.8, J10.7, J10.8, J11.7, J11.8, J12.6, J13.6, J14.6, J15.6

Notes on the sheet:
High Current Screw Term
