woodsmoke/Due_SB/Duet-master/Duet_Expansion/Duex4v0.2/Htr_Fan_expansion.sch

## KiCad design Duet-master/Duet_Expansion/Duex4v0.2/Htr_Fan_expansion.sch (2015-08-09)

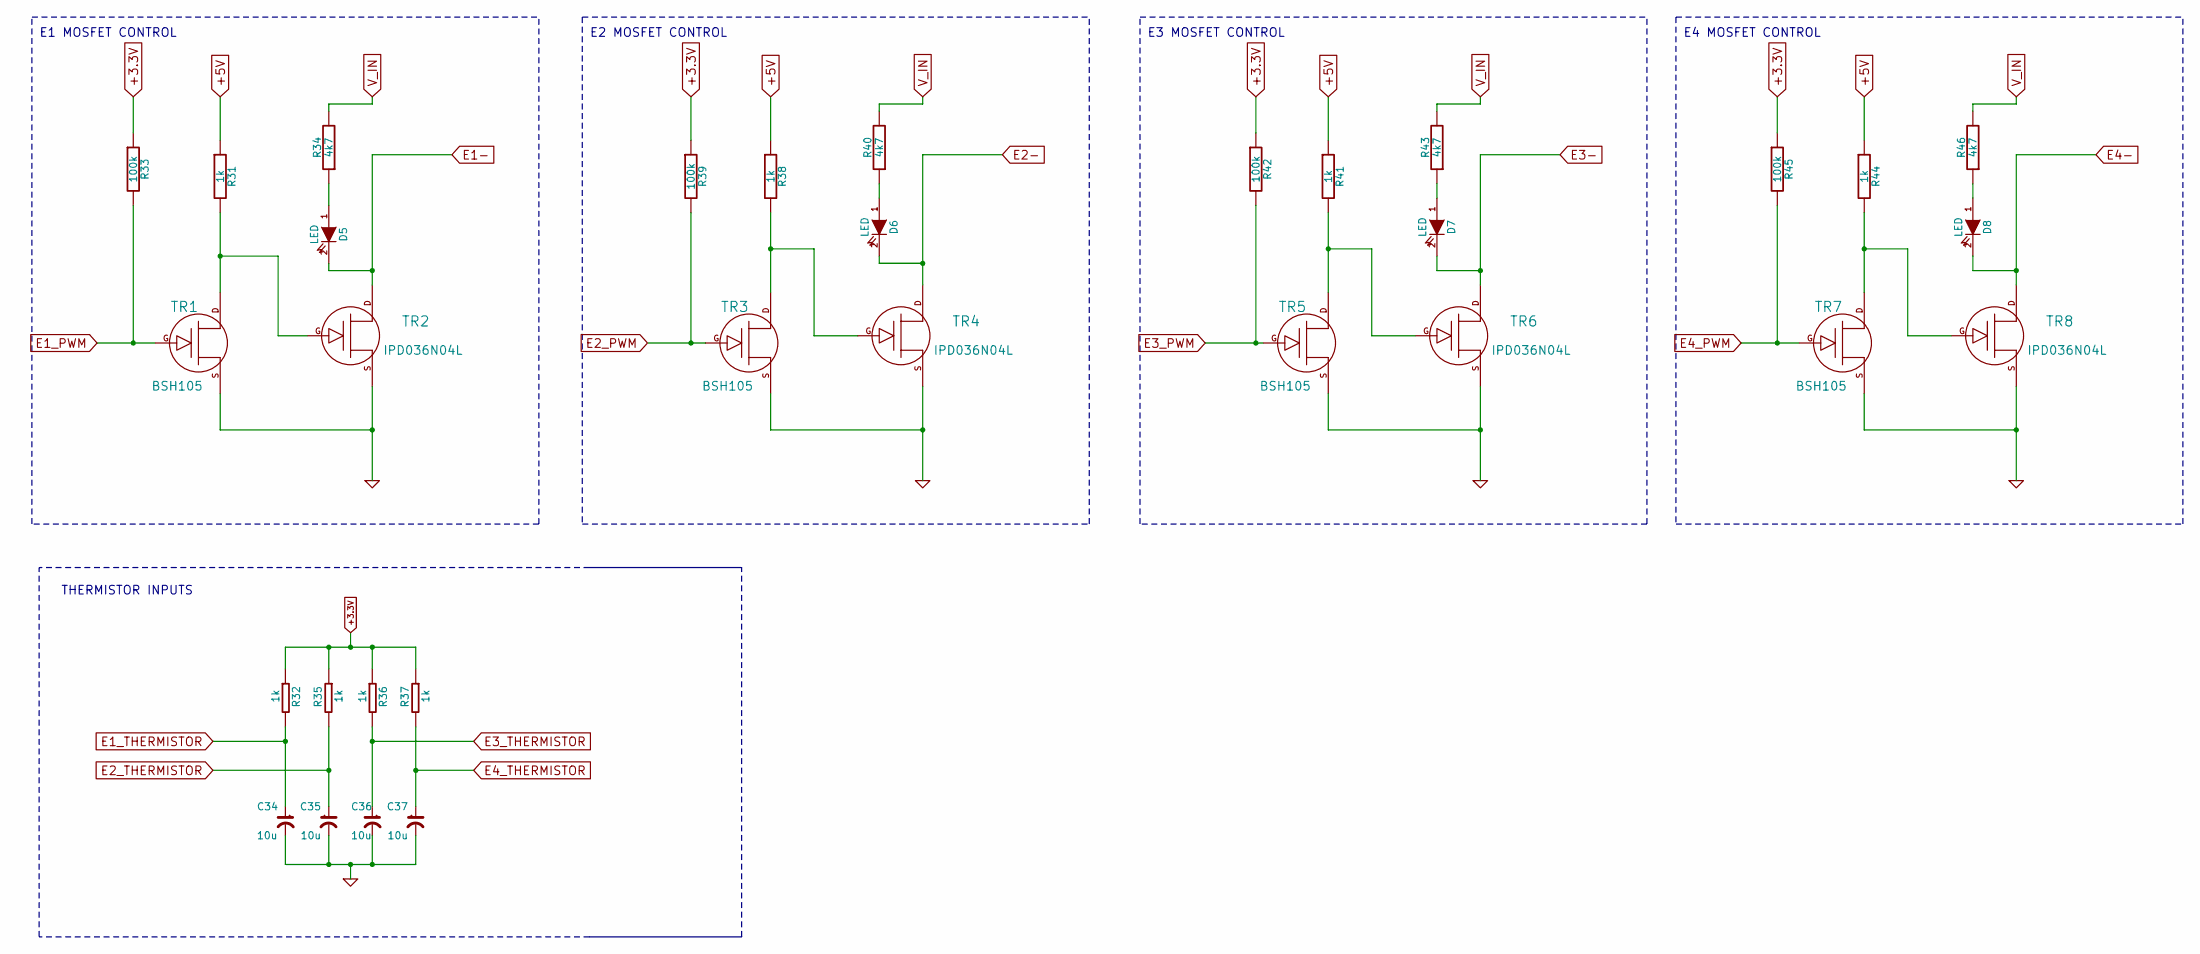
[picture p29: schematic Htr_Fan_expansion.sch]

Parts:
C34, C35, C36, C37: 10u; C_0805
D5, D6, D7, D8: LED; D_0603
R31, R32, R35, R36, R37, R38, R41, R44: 1k; R_0603
R33, R39, R42, R45: 100k; R_0603
R34, R40, R43, R46: 4k7; R_0603
TR1, TR3, TR5, TR7: BSH105; SOT-23
TR2, TR4, TR6, TR8: IPD036N04L; D-PAK

Connections:
+3.3V: R32.1, R33.1, R35.1, R36.1, R37.1, R39.1, R42.1, R45.1
+5V: R31.1, R38.1, R41.1, R44.1
E1-: D5.2 (K), TR2.D
E1_PWM: R33.2, TR1.G
E1_THERMISTOR: C34.1, R32.2
E2-: D6.2 (K), TR4.D
E2_PWM: R39.2, TR3.G
E2_THERMISTOR: C35.1, R35.2
E3-: D7.2 (K), TR6.D
E3_PWM: R42.2, TR5.G
E3_THERMISTOR: C36.1, R36.2
E4-: D8.2 (K), TR8.D
E4_PWM: R45.2, TR7.G
E4_THERMISTOR: C37.1, R37.2
GND: C34.2, C35.2, C36.2, C37.2, TR1.S, TR2.S, TR3.S, TR4.S, TR5.S, TR6.S, TR7.S, TR8.S
unnamed: D5.1 (A), R34.1
unnamed: D6.1 (A), R40.1
unnamed: D7.1 (A), R43.1
unnamed: D8.1 (A), R46.1
unnamed: R31.2, TR1.D, TR2.G
unnamed: R38.2, TR3.D, TR4.G
unnamed: R41.2, TR5.D, TR6.G
unnamed: R44.2, TR7.D, TR8.G
V_IN: R34.2, R40.2, R43.2, R46.2

Notes on the sheet:
E4 MOSFET CONTROL
THERMISTOR INPUTS
E3 MOSFET CONTROL
E2 MOSFET CONTROL
E1 MOSFET CONTROL
