woodsmoke/Due_SB/Duet-master/Duet_Expansion/Duex4v0.2/Stepper_Drv_expansion.sch

## KiCad design Duet-master/Duet_Expansion/Duex4v0.2/Stepper_Drv_expansion.sch (2015-08-09)

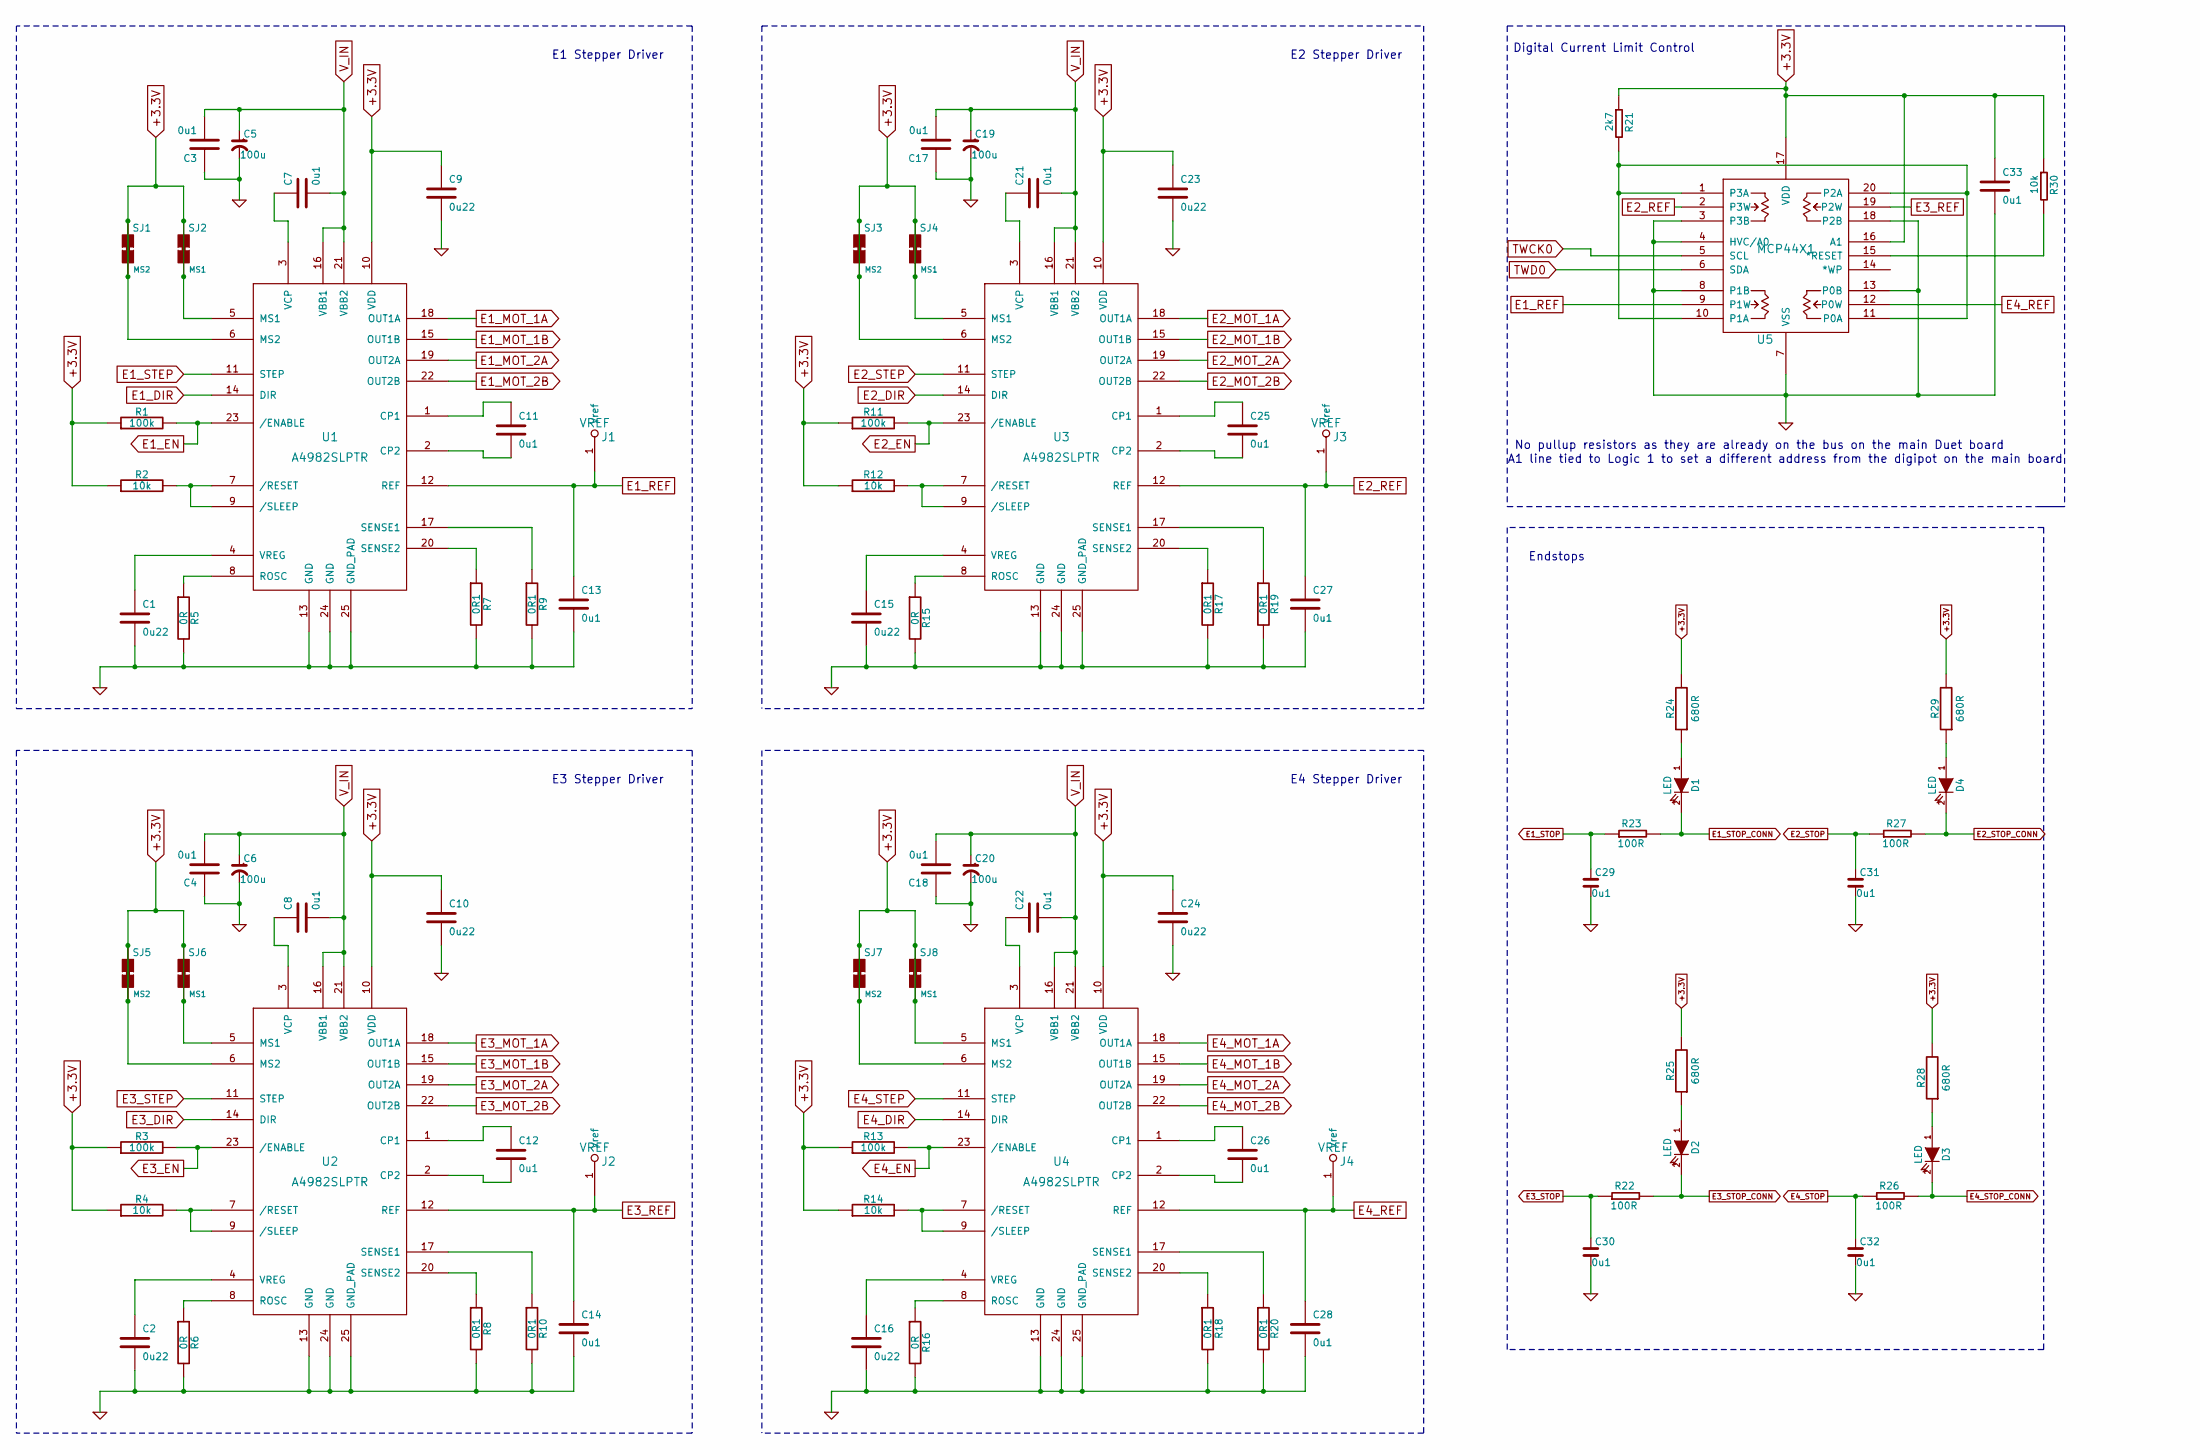
[picture p30: schematic Stepper_Drv_expansion.sch]

Parts:
C1, C2, C9, C10, C15, C16, C23, C24: 0u22; C_0603
C3, C4, C7, C8, C11, C12, C13, C14, C17, C18, C21, C22, C25, C26, C27, C28, C29, C30, C31, C32, C33: 0u1; C_0603
C5, C6, C19, C20: 100u; C_ELEC_6.3x7.7
D1, D2, D3, D4: LED; D_0603
J1, J2, J3, J4: VREF; Vref
R1, R3, R13: 100k; R_0603
R2, R4, R12, R14, R30: 10k; R_0603
R5, R6, R15, R16: 0R; R_0603
R7, R8, R9, R10, R17, R18, R19, R20: 0R1; R_1206
R11: 100k; 0603
R21: 2k7; R_0603
R22, R23, R26, R27: 100R; R_0603
R24, R25, R28, R29: 680R; R_0603
SJ1, SJ3, SJ5, SJ7: MS2
SJ2, SJ4, SJ6, SJ8: MS1
U1, U2, U3, U4: A4982SLPTR; TSSOP-24
U5: MCP44X1; TSSOP-20

Connections:
+3.3V: C9.1, C10.1, C23.1, C24.1, C33.1, R1.1, R2.1, R3.1, R4.1, R11.1, R12.1, R13.1, R14.1, R21.1, R24.2, R25.2, R28.2, R29.2, R30.1, SJ1.1 (SJ_P1), SJ1.2 (SJ_P2), SJ2.1 (SJ_P1), SJ2.2 (SJ_P2), SJ3.1 (SJ_P1), SJ3.2 (SJ_P2), SJ4.1 (SJ_P1), SJ4.2 (SJ_P2), SJ5.1 (SJ_P1), SJ5.2 (SJ_P2), SJ6.1 (SJ_P1), SJ6.2 (SJ_P2), SJ7.1 (SJ_P1), SJ7.2 (SJ_P2), SJ8.1 (SJ_P1), SJ8.2 (SJ_P2), U1.5 (MS1), U1.6 (MS2), U1.10 (VDD), U2.5 (MS1), U2.6 (MS2), U2.10 (VDD), U3.5 (MS1), U3.6 (MS2), U3.10 (VDD), U4.5 (MS1), U4.6 (MS2), U4.10 (VDD), U5.16 (A1), U5.17 (VDD)
E1_DIR: U1.14 (DIR)
E1_EN: R1.2, U1.23 (/ENABLE)
E1_MOT_1A: U1.18 (OUT1A)
E1_MOT_1B: U1.15 (OUT1B)
E1_MOT_2A: U1.19 (OUT2A)
E1_MOT_2B: U1.22 (OUT2B)
E1_REF: C13.1, J1.1, U1.12 (REF), U5.9 (P1W)
E1_STEP: U1.11 (STEP)
E1_STOP: C29.1, R23.1
E1_STOP_CONN: D1.2 (K), R23.2
E2_DIR: U3.14 (DIR)
E2_EN: R11.2, U3.23 (/ENABLE)
E2_MOT_1A: U3.18 (OUT1A)
E2_MOT_1B: U3.15 (OUT1B)
E2_MOT_2A: U3.19 (OUT2A)
E2_MOT_2B: U3.22 (OUT2B)
E2_REF: C27.1, J3.1, U3.12 (REF), U5.2 (P3W)
E2_STEP: U3.11 (STEP)
E2_STOP: C31.1, R27.1
E2_STOP_CONN: D4.2 (K), R27.2
E3_DIR: U2.14 (DIR)
E3_EN: R3.2, U2.23 (/ENABLE)
E3_MOT_1A: U2.18 (OUT1A)
E3_MOT_1B: U2.15 (OUT1B)
E3_MOT_2A: U2.19 (OUT2A)
E3_MOT_2B: U2.22 (OUT2B)
E3_REF: C14.1, J2.1, U2.12 (REF), U5.19 (P2W)
E3_STEP: U2.11 (STEP)
E3_STOP: C30.1, R22.1
E3_STOP_CONN: D2.2 (K), R22.2
E4_DIR: U4.14 (DIR)
E4_EN: R13.2, U4.23 (/ENABLE)
E4_MOT_1A: U4.18 (OUT1A)
E4_MOT_1B: U4.15 (OUT1B)
E4_MOT_2A: U4.19 (OUT2A)
E4_MOT_2B: U4.22 (OUT2B)
E4_REF: C28.1, J4.1, U4.12 (REF), U5.12 (P0W)
E4_STEP: U4.11 (STEP)
E4_STOP: C32.1, R26.1
E4_STOP_CONN: D3.2 (K), R26.2
GND: C1.2, C2.2, C3.1, C4.1, C5.2, C6.2, C9.2, C10.2, C13.2, C14.2, C15.2, C16.2, C17.1, C18.1, C19.2, C20.2, C23.2, C24.2, C27.2, C28.2, C29.2, C30.2, C31.2, C32.2, C33.2, R5.2, R6.2, R7.2, R8.2, R9.2, R10.2, R15.2, R16.2, R17.2, R18.2, R19.2, R20.2, U1.13 (GND), U1.24 (GND), U1.25 (GND_PAD), U2.13 (GND), U2.24 (GND), U2.25 (GND_PAD), U3.13 (GND), U3.24 (GND), U3.25 (GND_PAD), U4.13 (GND), U4.24 (GND), U4.25 (GND_PAD), U5.3 (P3B), U5.4 (HVC/A0), U5.7 (VSS), U5.8 (P1B), U5.13 (P0B), U5.18 (P2B)
unnamed: C1.1, U1.4 (VREG)
unnamed: C2.1, U2.4 (VREG)
unnamed: C7.1, U1.3 (VCP)
unnamed: C8.1, U2.3 (VCP)
unnamed: C11.1, U1.1 (CP1)
unnamed: C11.2, U1.2 (CP2)
unnamed: C12.1, U2.1 (CP1)
unnamed: C12.2, U2.2 (CP2)
unnamed: C15.1, U3.4 (VREG)
unnamed: C16.1, U4.4 (VREG)
unnamed: C21.1, U3.3 (VCP)
unnamed: C22.1, U4.3 (VCP)
unnamed: C25.1, U3.1 (CP1)
unnamed: C25.2, U3.2 (CP2)
unnamed: C26.1, U4.1 (CP1)
unnamed: C26.2, U4.2 (CP2)
unnamed: D1.1 (A), R24.1
unnamed: D2.1 (A), R25.1
unnamed: D3.1 (A), R28.1
unnamed: D4.1 (A), R29.1
unnamed: R2.2, U1.7 (/RESET), U1.9 (/SLEEP)
unnamed: R4.2, U2.7 (/RESET), U2.9 (/SLEEP)
unnamed: R5.1, U1.8 (ROSC)
unnamed: R6.1, U2.8 (ROSC)
unnamed: R7.1, U1.20 (SENSE2)
unnamed: R8.1, U2.20 (SENSE2)
unnamed: R9.1, U1.17 (SENSE1)
unnamed: R10.1, U2.17 (SENSE1)
unnamed: R12.2, U3.7 (/RESET), U3.9 (/SLEEP)
unnamed: R14.2, U4.7 (/RESET), U4.9 (/SLEEP)
unnamed: R15.1, U3.8 (ROSC)
unnamed: R16.1, U4.8 (ROSC)
unnamed: R17.1, U3.20 (SENSE2)
unnamed: R18.1, U4.20 (SENSE2)
unnamed: R19.1, U3.17 (SENSE1)
unnamed: R20.1, U4.17 (SENSE1)
unnamed: R21.2, U5.1 (P3A), U5.10 (P1A), U5.11 (P0A), U5.20 (P2A)
unnamed: R30.2, U5.15 (*RESET)
TWCK0: U5.5 (SCL)
TWD0: U5.6 (SDA)
V_IN: C3.2, C4.2, C5.1, C6.1, C7.2, C8.2, C17.2, C18.2, C19.1, C20.1, C21.2, C22.2, U1.16 (VBB1), U1.21 (VBB2), U2.16 (VBB1), U2.21 (VBB2), U3.16 (VBB1), U3.21 (VBB2), U4.16 (VBB1), U4.21 (VBB2)

Notes on the sheet:
A1 line tied to Logic 1 to set a different address from the digipot on the main board
No pullup resistors as they are already on the bus on the main Duet board
Endstops
Digital Current Limit Control
E3 Stepper Driver
E4 Stepper Driver
E2 Stepper Driver
E1 Stepper Driver
