woodsmoke/Due_SB/(commit log)

2015-08-09 File upload
    First commit
    [Comms.sch, Duet0.3.brd, Duet0.3.sch, Duet0.4 BOM.xls, Duet0.4.brd, Duet0.4.csv, Duet0.4.sch, Duet0.6.brd]
2015-08-09 USB Receptacle Footprints
    KiCad Footprints for USB 2.0/3.0 receptacles
2015-08-10 Module Library update
    Lots of duplicate footprints
    [Power.sch, _saved_Comms.sch, _saved_Headers.sch, _saved_Processor.sch, _saved_Stepper_Drv.sch]
2015-08-12 PCB layout of components started
    Experienced advice welcome.
    [Comms.sch, Duet0.85.kicad_pcb, Headers.sch, Htr_Fan.sch, Power.sch, Processor.sch, Stepper_Drv.sch, _saved_Comms.sch]
2015-08-13 Finalising draft layout for comment
    [Duet0.85.kicad_pcb, _saved_Processor.sch]
2015-08-13 Finalising first draft layout for comment
    [Duet0.85.kicad_pcb]
2015-08-14 USB 3 receptacles!
    [Comms.sch, Duet0.85.kicad_pcb, _saved_Headers.sch]
2015-08-15 0.1" headers added
    [Comms.sch, Duet0.85.kicad_pcb, Headers.sch, Htr_Fan.sch, Power.sch, Processor.sch, Stepper_Drv.sch, _saved_Headers.sch]
2015-08-15 Routing started
    [Comms.sch, Duet0.85.kicad_pcb, Headers.sch, Htr_Fan.sch, Power.sch, Processor.sch, Stepper_Drv.sch]
2015-08-17 More routing, even under crystals.
    [Duet0.85.kicad_pcb, Headers.sch]
2015-08-18 More routing
    [Headers.sch, Processor.sch]
2015-08-19 Nearly complete
    [Duet0.85.kicad_pcb]
2015-08-21 Clean up
    [Duet0.85.kicad_pcb, Headers.sch]
2015-08-22 Some GND connections beefed up
    [Duet0.85.kicad_pcb]
