woodsmoke/Due_SB/(notices)

Notices in the files:
Duet-master/Archive_Files/Duet0.4/Duet0.4.brd:
V 0.4 License: GPL V3.0 www.t3p3.com
Duet-master/Archive_Files/Duet0.3/Duet0.3.brd:
V 0.3 License: GPL V3.0 www.t3p3.com
Duet-master/Duet_Expansion/Duex4v0.2/Duet_expansion0.2.brd:
V 0.2 License: CERN OSH License 1.2 www.t3p3.com
